ucnl/ucnl.github.io/README.md

|  |
| :---: |
| [www.unavlab.com](https://www.unavlab.com/) <br/> [support@unavlab.com](mailto:support@unavlab.com) |
| [EN](README.md) \| [RU](README_RU.md) |

## Support & Social media
{% include social-media-links.html %}

## Products documentation
* [Navigation & tracking systems](navigation_and_tracking_systems_en.md)
* [Underwater acoustic modems](underwater_acoustic_modems_en.md)
* [Underwater Wireless voice systems (Underwater telephone)](underwater_wireless_voice_systems_en.md)
* [Hydrophones & transducers](underwater_acoustic_antennas_en.md)
* [Accessories](accessories_en.md)
* [Other equipment](underwater_bespoke_systems_en.md)

## Media, educational project and other things
* [Media](media_videos_en.md)
* [Our educational projects](educational_projects_en.md)
* [Miscellaneous info](misc_en.md)
