ucnl/ucnl.github.io/documentation/EN/RedPhone/RedPhone_RF_Dongle_Specification_en.md

[Main](/) ❯ [Underwater wireless voice systems](/underwater_wireless_voice_systems_en) ❯ **RedPhone RF Dongle: Device specification**

|  |  |
| :---: | ---: |
| [www.unavlab.com](https://www.unavlab.com/) <br/> [support@unavlab.com](mailto:support@unavlab.com) | **RedPhone Radio dongle** - Radio dongle for configuring [RedPhone-DX](RedPhone_DX_Specification_en.md) devices <br/> Device specification |

## KEY FEATURES

* **Minimum dimensions and weight**
* **Splash-proof design**

## DESCRIPTION

The device is designed to connect [RedPhone-DX](RedPhone_DX_Specification_en.md) devices to a PC for configuration purposes.

## TECHNICAL SPECIFICATIONS

| PARAMETER | VALUE |
| :--- | :--- |
| DIMENSIONS (L x W x H, excluding the cable) | 42 x 26 x 109 mm |
| USB CABLE LENGTH | At least 0.1 m |
| WEIGHT | 110 g |
| OPERATING TEMPERATURE RANGE | -10 .. 50 °C |
| MAXIMUM RADIO COMMUNICATION RANGE<sup>[1](#footnote1)</sup> | 30 m |
| CONNECTION | To a PC's USB port |
| MOUNTING | Magnetic |

________________
<a name="footnote1"><sup>1</sup></a> Achieved in the absence of interference, in an open area.
