ucnl/ucnl.github.io/documentation/EN/RedPhone/RedPhone_Specification_en.md

|  | RedPhone-D |
| :---: | ---: |
| [www.unavlab.com](https://www.unavlab.com/) <br/> [support@unavlab.com](mailto:support@unavlab.com) | **RedPhone-D** <br/> Diver station of the wireless voice communication system <br/> Device specification |

## FEATURES

* **Compatibility with most similar systems (OTS, Oceanreef, etc.)**
* **Built-in function for determining the diver's location<sup>[1](#footnote1)</sup>**
* **Acoustic communication range up to 1000<sup>[2](#footnote2)</sup> m**
* **Battery life up to 80 hours in receiving mode**
* **Automatic power-on in water**
* **Built-in voice activity detector**
* **Strong, durable plastic housing**

## DESCRIPTION

The **RedPhone-D** wireless diver telephone communication station provides voice messaging between divers and/or from a diver to a surface station. The device supports standard frequency bands and is compatible with most similar systems. The built-in pinger function of the **RWLT** navigation system allows recording the geographic position of the diver upon completion of a voice transmission. 
[RedButton](https://docs.unavlab.com/documentation/EN/Accessories/uPress_Specification_en.html), which contains no corroding elements, is used as a push-to-talk (PTT) button.

## TECHNICAL SPECIFICATIONS

| PARAMETER | VALUE |
| :--- | :--- |
| DIMENSIONS<sup>[3](#footnote3)</sup> (L x W x H) | 106 x 95 x 55 mm |
| WEIGHT<sup>[4](#footnote4)</sup> (dry) | 0.6 kg |
| MAXIMUM IMMERSION DEPTH | 100 m |
| MAXIMUM ACOUSTIC COMMUNICATION RANGE<sup>[2](#footnote2)</sup> | 1000 m |
| MAXIMUM ACOUSTIC SOURCE LEVEL | 150 dB re 1 μPa @ 1 m |
| VOICE BANDWIDTH<sup>[5](#footnote5)</sup> | 300 .. 4300 Hz |
| NUMBER OF SUPPORTED CHANNELS | 8 |
| MAXIMUM BATTERY LIFE (RX MODE)<sup>[6](#footnote6)</sup> | up to 80 hours |
| MAXIMUM BATTERY LIFE (MIXED MODE, 20%)<sup>[6](#footnote6),[7](#footnote7)</sup> | up to 5 hours |
| MAXIMUM BATTERY LIFE (MIXED MODE, 50%)<sup>[6](#footnote6),[8](#footnote8)</sup> | up to 2.5 hours |
| OPERATING TEMPERATURE RANGE | -10 .. 50 °C |
| BUILT-IN POWER SUPPLY | 28 watt-hours, LiFePO4, up to 3000 charge-discharge cycles |
| CHANNEL SWITCHING | In the surface position, using a USB radio dongle |
| HOUSING MATERIAL | Polyurethane |
| CABLE INSULATION MATERIAL | Polyurethane |
| NAVIGATION SIGNAL CARRIER FREQUENCY | 20050 Hz |
| NAVIGATION SIGNAL MODULATION TYPE | BPSK |
| NAVIGATION SIGNAL DURATION | 200 ms |

## CHANNELS AND FREQUENCY BANDS

| CHANNEL NUMBER | CARRIER FREQUENCY, Hz | SIDEBAND | BANDWIDTH, Hz |
| :---: | :---: | :---: | :---: |
| 1 | 32768 | Lower | 28468 .. 32468 |
| 2 | 32768 | Upper | 33068 .. 37068 |
| 3 | 31250 | Lower | 26950 .. 30950 |
| 4 | 31250 | Upper | 31550 .. 35550 |
| 5 | 28500 | Lower | 24200 .. 28200 |
| 6 | 28500 | Upper | 28800 .. 32800 |
| 7 | 25000 | Lower | 20700 .. 24700 |
| 8 | 25000 | Upper | 25300 .. 29300 |

________________
<a name="footnote1"><sup>1</sup></a> The function is provided by the buoys of the **RWLT** navigation system.  
<a name="footnote2"><sup>2</sup></a> A parameter that determines the maximum range at which signal reception is possible, based on the electro-acoustic parameters of the transmitter and receiver, the spatial decrease in the intensity of sound energy, attenuation in the medium and the acoustic noise level.  
<a name="footnote3"><sup>3</sup></a> Including the transducer.  
<a name="footnote4"><sup>4</sup></a> With a battery, a PTT button and a mask connector; depending on the connector, the value may differ by the weight of the connector.  
<a name="footnote5"><sup>5</sup></a> The actual range of reproduced frequencies depends on the characteristics of the headset used.  
<a name="footnote6"><sup>6</sup></a> With new, fully charged batteries with a capacity of 3000 mA\*h or more, at an ambient temperature of 20 °C.  
<a name="footnote7"><sup>7</sup></a> In the mode of 2 minutes of transmission and 8 minutes of reception.  
<a name="footnote8"><sup>8</sup></a> In the mode of 5 minutes of transmission and 5 minutes of reception.
