ucnl/ucnl.github.io/documentation/EN/Transducers/R_1.d3505_1_Specification_en.md

[Main](/) ❯ [Hydrophones & transducers](/underwater_acoustic_antennas_en) ❯ **R-1.d3505-1: Device specification**

|  |  |
| :---: | ---: |
| [www.unavlab.com](https://www.unavlab.com/) <br/> [support@unavlab.com](mailto:support@unavlab.com) | **R-1.d3505-1** <br/> Underwater acoustic receiving transducer <br/> Device specification |

## KEY FEATURES

* Miniature and lightweight transducer based on a single disk piezoelectric element
* Complete absence of corroding elements
* Mounting holes

## TECHNICAL SPECIFICATIONS

| PARAMETER | VALUE |
| :--- | :--- |
| SIZE | 75 x 55 x 6 mm |
| WEIGHT (dry, excluding cable weight) | 5 g |
| ELECTRICAL CAPACITANCE | |
| MAXIMUM EXTERNAL HYDROSTATIC PRESSURE | 30 bar |
| STANDARD CABLE LENGTH | 1 m |
| CABLE TYPE | RG-174 / RG-58 |
| CABLE INSULATION MATERIAL | PVC / PU |
| OPERATING TEMPERATURE RANGE | -40..+60 °C |
| CABLE DIAMETER | 3 +/- 0.5 mm or 4 +/- 0.5 |

## DIMENSIONAL DRAWING

### Cable wire assignment

| No. | Color/Name | Function |
| :---: | :--- | :--- |
| 1 | Shield | Common |
| 2 | Center conductor | NC |

## ADDITIONAL PARAMETERS
