ucnl/ucnl.github.io/documentation/EN/Transducers/RT-1.524525-1_specification_en.md

[Main](/) ❯ [Hydrophones & transducers](/underwater_acoustic_antennas_en) ❯ **RT-1.524525-1: Device specification**

|  |  |
| :---: | ---: |
| [www.unavlab.com](https://www.unavlab.com/) <br/> [support@unavlab.com](mailto:support@unavlab.com) | **RT-1.524525-1** <br/> Underwater acoustic transducer <br/> Device specification |

## KEY FEATURES

* Maintenance-free monoblock design made using a patented technology
* Complete absence of corroding elements
* Single-element transducer - a balance between sensitivity in receiving and transmitting modes, weight and dimensions
* High-quality shielded cable with polyurethane insulation
* Mounting groove

## TECHNICAL SPECIFICATIONS

| PARAMETER | VALUE |
| :--- | :--- |
| SIZE (Ø x h) | 64 x 65 mm |
| WEIGHT (dry) | 0.28 kg |
| MAXIMUM INPUT VOLTAGE (PEAK) | 200 V |
| ELECTRICAL CAPACITANCE | 20 +/- 5 nF |
| MAXIMUM EXTERNAL HYDROSTATIC PRESSURE | 30 bar |
| STANDARD CABLE LENGTH | 1 m |
| OPERATING TEMPERATURE RANGE | -40..+60 °C |
| CABLE DIAMETER | 5 +/- 0.5 mm |
| BEAM PATTERN (10 .. 40 kHz) | Torus coaxial with the cylinder |
| BEAM ANGLE (10 .. 40 kHz) | 120° (frequency response 3 dB) |

## DIMENSIONAL DRAWING

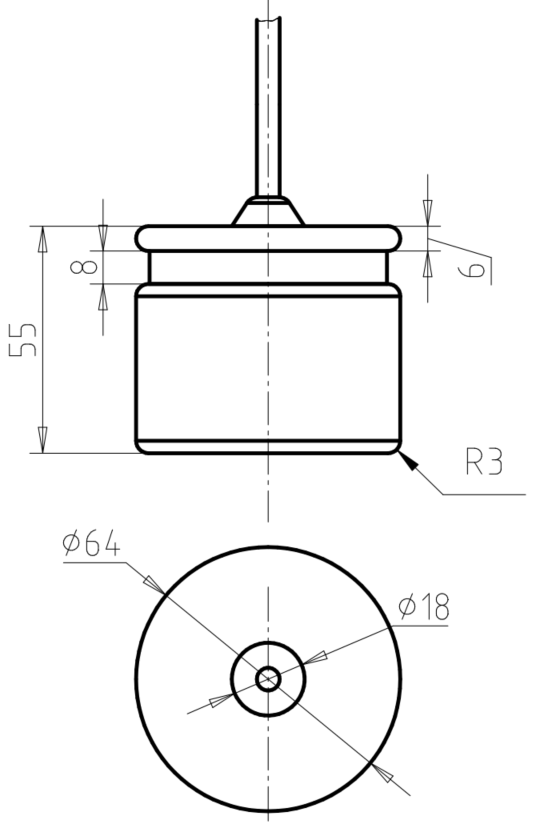
[picture p3: documentation/RT_1_524525_1_drawings.png]
RT_1_524525_1_drawings


### Cable wire assignment

| No. | Color | Function |
| :---: | :--- | :--- |
| 1 | Green | "-" |
| 2 | Red | "+" |
| 3 | White/Transparent | NC |
| 4 | Yellow | NC |
| 5 | Shield | NC |

## ADDITIONAL PARAMETERS

RT_1_524525_1_impedance

RT_1_524525_1_tx_sensitivity

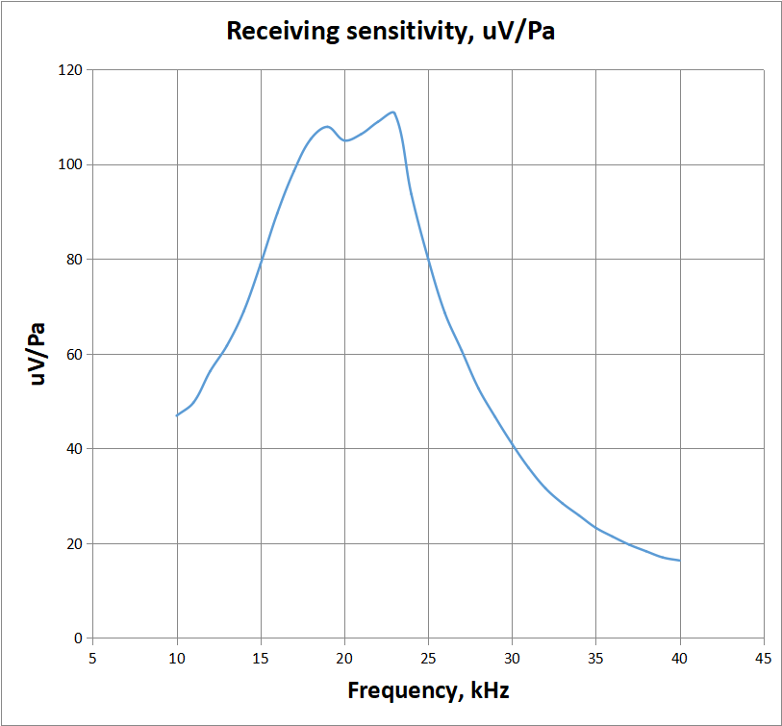
[picture p4: documentation/RT_1_524525_1_rx_sensitivity_en.png]
RT_1_524525_1_rx_sensitivity
