ucnl/ucnl.github.io/documentation/EN/WAYU/WAYU_GIB_Specification_en.md

[Main](/) ❯ [Educational projects](/educational_projects_en) ❯ **WAYU GIB: Device specification**

|  | WAYU_GIB_1(1)(1) |
| :---: | ---: |
| [www.unavlab.com](https://www.unavlab.com/) <br/> [support@unavlab.com](mailto:support@unavlab.com) | **WAYU GIB** - Navigation buoy <br/> Device specification |

## KEY FEATURES

* **Minimum dimensions and weight**
* **Strong and durable maintenance-free housing**
* **Automatic activation in water**

## DESCRIPTION

The **WAYU GIB** navigation sonobuoy of the **[WAYU](WAYU_DataBrief_en.md)** system, in a set of four such devices, forms a floating long navigation base that supports positioning of the **[WAYU Pinger](WAYU_Pinger_Specification_en.md)** pinger.  
The device has a one-piece design, is made of high-strength polyurethane and polypropylene, and switches off automatically when it enters the water. It does not require any settings or calibrations. Buoyancy is provided by an easily noticeable float made of ethylene-vinyl acetate (EVA).

## TECHNICAL SPECIFICATIONS

| PARAMETER | VALUE |
| :--- | :--- |
| DIMENSIONS<sup>[1](#footnote1)</sup> (Ø x h) | 55 x 1000 mm |
| WEIGHT (dry) | 1.55 kg |
| MAXIMUM BATTERY LIFE<sup>[2](#footnote2)</sup> | 12 hours |
| MAXIMUM VELOCITY RELATIVE TO PINGER | +/- 2 m/s |
| OPERATING TEMPERATURE RANGE | -10 .. 50 °C |
| MAXIMUM ACOUSTIC COMMUNICATION RANGE<sup>[3](#footnote3)</sup> | 300 m |
| ACOUSTIC SIGNAL FREQUENCY | 25000 Hz |
| REFERENCE ELLIPSOID | WGS-84 |
| BUILT-IN BATTERY TYPE | LiFePO4 |
| BUILT-IN BATTERY CAPACITY | 18 W·h |
| TRANSDUCER CABLE LENGTH | 1 m |
| BUILT-IN RADIO MODULE TYPE | 433 MHz |
| MAXIMUM RADIO MODULE POWER | 100 mW |
| MAXIMUM RADIO COMMUNICATION RANGE<sup>[4](#footnote4)</sup> | 300 m |
| CHARGING THE BUILT-IN BATTERY | With the included charger |
| CHARGING TIME OF THE BUILT-IN BATTERY | 8 h |

## ADDITIONAL INFORMATION

| [MSDS OF THE BUILT-IN POWER SUPPLY](https://docs.unavlab.com/documentation/EN/Misc/WAYU_GIB_MSDS_en.html) | [ELECTRONIC VERSION OF THIS DOCUMENT](https://docs.unavlab.com/documentation/EN/WAYU/WAYU_GIB_Specification_en.html) |
| :---: | :---: |
|  |  |

________________
<a name="footnote1"><sup>1</sup></a> Not including the receiving transducer on a 1 m cable, not including the float (Ø x h) 125 x 160 mm.  
<a name="footnote2"><sup>2</sup></a> With a new battery, at an ambient temperature of 20 °C.  
<a name="footnote3"><sup>3</sup></a> A parameter that determines the maximum range at which signal reception is possible, based on the electro-acoustic parameters of the transmitter and receiver, the spatial decrease in the intensity of sound energy, attenuation in the medium and the acoustic noise level.  
<a name="footnote4"><sup>4</sup></a> Achieved in the absence of interference, in open areas. The receiving antenna may need to be raised several meters higher.
