ucnl/ucnl.github.io/documentation/EN/Accessories/uPress_Specification_en.md

[Main](/) ❯ [Accessories](/accessories_en) ❯ **uPress underwater button**

|  |  |
| :---: | ---: |
| [www.unavlab.com](https://www.unavlab.com/) <br/> [support@unavlab.com](mailto:support@unavlab.com) | uPress underwater button <br/> Device specification |

## FEATURES

* **Complete absence of corroding elements**
* **Domestic development and production**
* **Patented design<sup>[*](#fn_asterisk)</sup>**
* **Ergonomic design**
* **Strong, durable, highly visible housing**
* **Loop for a cord or strap**

## DESCRIPTION

The **uPress** underwater switch is specially designed for use by divers. The device has no parts that require maintenance or are susceptible to corrosion.
It offers high reliability and a high mean time between failures compared with spring-loaded rod designs and piezo buttons.

___________________

<a name="fn_asterisk"><sup>*</sup></a> Patent RU2831916 C1

## TECHNICAL SPECIFICATIONS

| PARAMETER | VALUE |
| :--- | :--- |
| DEFAULT STATE | NORMALLY OPEN |
| DIMENSIONS (L x W x H)| 86 x 60 x 23 mm |
| WEIGHT<sup>[1](#fn1)</sup> (dry) | 55 g |
| MAXIMUM OPERATING DEPTH | 140 m |
| CABLE LENGTH<sup>[2](#fn2)</sup> | 0.5 m |
| CABLE DIAMETER | 5 mm |
| CABLE INSULATION MATERIAL | Polyurethane |
| HOUSING MATERIAL | Polyurethane |
| HOUSING COLOR<sup>[3](#fn3)</sup> | 🟥 🟦 🟩 🟨 ⬛ ⬜ |
| PUSH ELEMENT COLOR<sup>[3](#fn3)</sup> | 🟥 🟦 🟩 🟨 ⬛ ⬜ |
| OPERATING TEMPERATURE RANGE | -20 .. 50 °C |
| TRAVEL TO ACTUATION | 3 mm |
| MAXIMUM SWITCHING POWER | 10 W |
| SWITCHING CURRENT RANGE | 10<sup>-6</sup> .. 0.5 A |
| SWITCHING VOLTAGE RANGE | 5·10<sup>-2</sup> .. 100 V |
| CURRENT TYPE | DC, AC |
| NUMBER OF ACTUATIONS | 10<sup>5</sup> | 
| ACTUATION FORCE | 16 +/- 2 N |

________________  
<a name="fn1"><sup>1</sup></a> Including a cable of standard length.  
<a name="fn2"><sup>2</sup></a> The parameter can be changed by agreement.  
<a name="fn3"><sup>3</sup></a> Painting in any color from the RAL catalog is possible when ordering 50 pcs or more. Different colors of the button housing and the push element can also be combined.
