ucnl/ucnl.github.io/documentation/EN/Accessories/uSpeak_specification_en.md

[Main](/) ❯ [Accessories](/accessories_en) ❯ **uSpeak - protected microphone for diving masks**

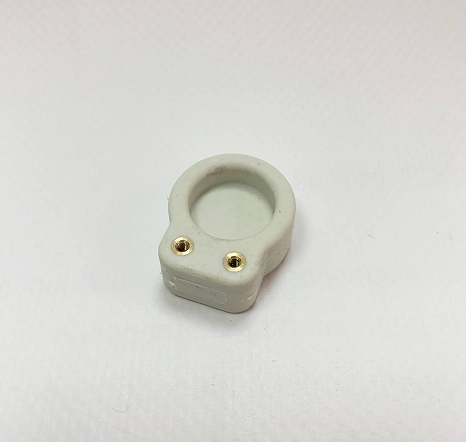
[picture p5: documentation/uspeak.png]
|  |  |
| :---: | ---: |
| [www.unavlab.com](https://www.unavlab.com/) <br/> [support@unavlab.com](mailto:support@unavlab.com) | **uSpeak** Protected microphone for diving masks <br/> Device specification |

## FEATURES

* **Resistant to any diving modes and depths**
* **Domestic development and production**
* **Patented design<sup>[*](#fn_asterisk)</sup>**
* **Ergonomic design**
* **Strong and durable**
* **Can be used as a replacement for DEMSh, OTS HotMic™, etc.**

## DESCRIPTION

**uSpeak** microphones are fully potted in a high-quality polyurethane compound. Simple and reliable, they have no closed air cavities. They withstand any diving and ascent modes.
It connects via a bronze M2 threaded connection, as do most counterparts.
The device is available in two form factors: standard and enlarged.

____________

<a name="fn_asterisk"><sup>*</sup></a> Patent RU225815

## TECHNICAL SPECIFICATIONS

| PARAMETER | VALUE |
| :--- | :--- |
| DIMENSIONS (L x W x H), mm | 31 x 26 x 12 mm (uSpeak) <br/> 39 x 37 x 13 mm (uSpeak Max) |
| WEIGHT (dry), g | 6.5 (uSpeak) <br/> 11.8 (uSpeak Max) |
| SENSITIVITY, μV/Pa | 500 (uSpeak) <br/> 1000 (uSpeak Max) |
| RESISTANCE<sup>[1](#fn1)</sup>, kOhm | 100 |
| FREQUENCY RANGE, Hz | 200 .. 6000 |
| CONNECTION | two bronze M2 screws |
| POTTING COMPOUND MATERIAL | Polyurethane |
| HOUSING COLOR<sup>[2](#fn2)</sup> | 🟥 🟦 🟩 🟨 ⬛ ⬜ |
| OPERATING TEMPERATURE RANGE, °C | -20 .. 60 |

________________  

<a name="fn1"><sup>1</sup></a> The parameter can be changed at the customer's request.  
<a name="fn2"><sup>2</sup></a> Painting in any color from the RAL catalog is possible when ordering 50 pcs or more.
