ucnl/ucnl.github.io/documentation/RU/Zima/Zima2SL_Specification_ru.md

[Главная](/README_RU) ❯ [Гидроакустические навигационные и трекинговые системы](/navigation_and_tracking_systems_ru) ❯ **Zima2-SL — решатель (Solver): Спецификация устройства**

<details>
  <summary><b>ℹ Рекомендации для печати/сохранения в PDF</b></summary>
  <br>
  <ol>
    <li>Нажмите <b>Ctrl+P</b> (macOS: <b>Cmd+P</b>)</li>
    <li>В настройках принтера выберите <b>«Сохранить как PDF»</b> (Microsoft Print to PDF)</li>
    <li>В поле <b>«Страницы»</b> укажите диапазон, исключая первую и последнюю страницу</li>
    <li>Отключите <b>верхние и нижние колонтитулы</b> (заголовки/URL/page numbers)</li>
    <li>В <b>Chrome/Edge</b>: в доп. настройках → «Поля» → <b>Нет</b> | в <b>Firefox</b>: «Поля и колонтитулы» → <b>Нет</b></li>
    <li>Нажмите <b>Печать</b> и укажите куда сохранить PDF</li>
  </ol>
</details>

|  | zima2_sl |
| :---: | ---: |
| [www.unavlab.com](https://www.unavlab.com/) <br/> [support@unavlab.com](mailto:support@unavlab.com) | **Zima2-SL** — решатель навигационной системы **Zima2 LBL** <br/> спецификация устройства |

## КЛЮЧЕВЫЕ ОСОБЕННОСТИ

* **Расчёт положения по дальностям до маяков с известными координатами**
* **Хранение координат маяков (до 16 шт.)**
* **Эмуляция GNSS-протокола (GGA, RMC, MTW)** для потребителя
* **Обмен с Zima2-LX по UART 3.3 В**
* **Компактная плата, размещаемая под водой или на поверхности**
* **Конфигурирование по протоколу [PAZM](Zima2_Protocol_Specification_ru.md)**

## ОПИСАНИЕ

**Zima2-SL** — вычислительный модуль (решатель) длиннобазисной навигационной системы [Zima2 LBL](Zima2_LBL_DataBrief_ru.md).

Модуль принимает по UART данные об измеренных дальностях от трансивера [Zima2-LX](Zima2LX_Specification_ru.md), хранит координаты маяков-ответчиков [Zima2-R](Zima2R_Specification_ru.md) и рассчитывает собственное положение. Результат выдаётся потребителю в виде стандартных GNSS-сообщений (**GGA**, **RMC**, **MTW**), что позволяет использовать **Zima2-SL** в качестве «прозрачной» замены приёмника GNSS в существующих системах.

Модуль может размещаться как под водой, так и на поверхности — в зависимости от решаемой задачи.

________________

## ТЕХНИЧЕСКИЕ ХАРАКТЕРИСТИКИ

| ПАРАМЕТР | ЗНАЧЕНИЕ |
| :--- | :--- |
| ГАБАРИТЫ (Ф х h) | ОЖИДАЕТСЯ |
| ВЕС | ОЖИДАЕТСЯ |
| НАПРЯЖЕНИЕ ПИТАНИЯ | 12 В |
| НАПРЯЖЕНИЕ ЛИНИЙ ДАННЫХ | 0 .. 3.3 В |
| ИНТЕРФЕЙС С Zima2-LX | UART 9600 бит/с |
| ИНТЕРФЕЙС С ПОТРЕБИТЕЛЕМ | UART 9600 бит/с |
| ПРОТОКОЛ КОНФИГУРИРОВАНИЯ | NMEA 0183 [PAZM](Zima2_Protocol_Specification_ru.md) |
| ЭМУЛИРУЕМЫЕ GNSS-СООБЩЕНИЯ | GGA, RMC, MTW |
| МАКСИМАЛЬНОЕ ЧИСЛО МАЯКОВ | до 16 |
| ДИАПАЗОН РАБОЧИХ ТЕМПЕРАТУР | ОЖИДАЕТСЯ |
| ЭНЕРГОПОТРЕБЛЕНИЕ | ОЖИДАЕТСЯ |
| МАКСИМАЛЬНАЯ ЧАСТОТА ОБНОВЛЕНИЯ ПОЗИЦИИ<sup>[1](#footnote1)</sup> | ОЖИДАЕТСЯ |
| НОМИНАЛЬНАЯ ТОЧНОСТЬ ОПРЕДЕЛЕНИЯ МЕСТОПОЛОЖЕНИЯ (СКО)<sup>[2](#footnote2)</sup> | ОЖИДАЕТСЯ |

________________
<a name="footnote1"><sup>1</sup></a> Определяется скоростью последовательного опроса маяков трансивером [Zima2-LX](Zima2LX_Specification_ru.md) и числом маяков в наборе.
<a name="footnote2"><sup>2</sup></a> ОЖИДАЕТСЯ.

### НАЗНАЧЕНИЕ РАЗЪЁМОВ / ЖИЛ КАБЕЛЯ

| ЦВЕТ ЖИЛЫ / КОНТАКТ | ФУНКЦИЯ |
| :--- | :---: |
| ОЖИДАЕТСЯ | + U<sub>пит.</sub> |
| ОЖИДАЕТСЯ | - U<sub>пит.</sub> (GND) |
| ОЖИДАЕТСЯ | UART к Zima2-LX: Rx |
| ОЖИДАЕТСЯ | UART к Zima2-LX: Tx |
| ОЖИДАЕТСЯ | UART к потребителю: Tx (GNSS-поток) |
