ucnl/ucnl.github.io/documentation/EN/RedPhone/RedPhone_DX_Specification_en.md

[Main](/../../) ❯ [Underwater Wireless voice systems (Underwater telephone)](/underwater_wireless_voice_systems_en) ❯ **Device specification: RedPhone-DX**

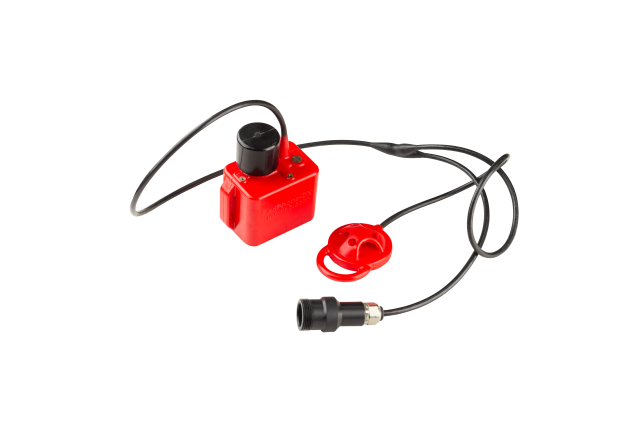
[picture p6: documentation/redphone_dx.png]
RedPhone-DX
|  |  |
| :---: | ---: |
| [www.unavlab.com](https://www.unavlab.com/) <br/> [support@unavlab.com](mailto:support@unavlab.com) | **RedPhone-DX** <br/> Underwater telephone. Diver's unit <br/> Device specification |

## KEY FEATURES

* **Compatible with most similar systems (OTS, Oceanreef, etc.)**
* **Fully rugger monoblock design - no place to leak!**
* **Built-in diver location function <sup>[1](#footnote1)</sup>**
* **Acoustic communication range up to 1000 <sup>[2](#footnote2)</sup> m**
* **Battery life up to 20 hours in receiving mode**
* **Automatic poweron in water**
* **Built-in voice activity detector / automatic squelch**

## DESCRIPTION

Diver's underwater wireless telephone communication unit **RedPhone-DX** provides voice messaging between divers and/or from a diver to a surface station. The device supports standard frequency bands and is compatible with most similar systems. The built-in pinger function of the navigation system **RWLT** allows the user to determine the geographic position of the diver after he completes voice transmission.
[uPress](https://docs.unavlab.com/documentation/EN/Accessories/uPress_Specification_en.html) that does not contain corrodable elements can be used as a Push-To-Talk button.

## TECHNICAL SPECIFICATIONS

| PARAMETER | VALUE |
| :--- | :--- |
| DIMENSIONS<sup>[3](#footnote3)</sup> | 106 x 95 x 55 mm |
| WEIGHT<sup>[4](#footnote4)</sup> (dry) | 0.6 kg |
| MAX. DEPTH | 100 m |
| MAX. OPERATING RANGE<sup>[2](#footnote2)</sup> | 1000 m |
| ACOUSTIC SOURCE LEVEL | 150 dB re 1 uPa @ 1 m |
| POWER (PEP) | 70 Watts |
| VOICE BANDWIDTH<sup>[5](#footnote5)</sup> | 300 .. 4300 Hz |
| NUMBER OF SUPPORTED CHANNELS | 8 |
| BATTERY LIFE (RX MODE)<sup>[6](#footnote6)</sup> | up to 20 hours |
| BATTERY LIFE (MIXED MODE)<sup>[6](#footnote6), [7](#footnote7)</sup> | up to 8 hours |
| BATTERY LIFE (MIXED MODE)<sup>[6](#footnote6), [8](#footnote8)</sup> | up to 2.5 hours |
| WORKING TEMPERATURE RANGE | -10 .. 50° С |
| BUILT-IN POWER SUPPLY | 28 Watt-hours, LiFePO4, up to 3000 cycles |
| CHANNEL SWITCHING | Onshore, via [RF-dongle](RedPhone_RF_Dongle_Specification_en.md) |
| BODY MATERIAL | Polyurethane |
| CABLES INSULATION MATERIAL | Polyurethane |
| NAVIGATION SIGNAL CARRIER | 20050 Hz |
| NAVIGATION SIGNAL MODULATION TYPE | BPSK |
| NAVIGATION SIGNAL DURATION | 200 msec |

## CHANNELS AND FREQUENCY BANDS

| CHANNEL NUMBER | CARRIER, Hz | SIDE BAND | BANDWIDTH, Hz |
| :---: | :---: | :---: | :---: |
| 1 | 32768 | Low | 28468 .. 32468 |
| 2 | 32768 | High | 33068 .. 37068 |
| 3 | 31250 | Low | 26950 .. 30950 |
| 4 | 31250 | High | 31550 .. 35550 |
| 5 | 28500 | Low | 24200 .. 28200 |
| 6 | 28500 | High | 28800 .. 32800 |
| 7 | 25000 | Low | 20700 .. 24700 |
| 8 | 25000 | High | 25300 .. 29300 |

### ADDITIONAL INFORMATION

[Material Safety Data Sheet (MSDS) for built-in battery](\documentation\EN\Misc\RedPhone_DX_MSDS_en) 

________________
<a name="footnote1"><sup>1</sup></a> The function is provided by buoys of the [RWLT](/documentation/EN/RWLT/RWLT_DataBrief_en) navigation system.  
<a name="footnote2"><sup>2</sup></a> A parameter that determines the maximum range at which a signal can be received based on the electro-acoustic parameters of the transmitter and receiver, spatial decrease in the intensity of sound energy, attenuation in the medium and level of acoustic noise.  
<a name="footnote3"><sup>3</sup></a> Including transducer.  
<a name="footnote4"><sup>4</sup></a> With a PTT button and a mask connector, deepending on the specific connector, the value may differ by the weight of the connector.  
<a name="footnote5"><sup>5</sup></a> The actual audible frequency range depends on the headset used.  
<a name="footnote6"><sup>6</sup></a> With new, fully charged batteries with a capacity of 3000 mA\*h or more, at an ambient temperature of 20 °C.  
<a name="footnote7"><sup>7</sup></a> While transmitting 2 minutes per 10 minutes.  
<a name="footnote8"><sup>8</sup></a> While transmitting 5 minutes per 10 minutes.
