ucnl/ucnl.github.io/documentation/EN/Accessories/Flange_rod_mound_Specification_en.md

[Main](/README) ❯ [Accessories](/accessories) ❯ **uClamp-S - Flange rod mount: Device specification**

|  | flange_rod_mount_zima2b |
| :---: | ---: |
| [www.unavlab.com](https://www.unavlab.com/) <br/> [support@unavlab.com](mailto:support@unavlab.com) | **uClamp-S** <br/> Flange rod mount <br/> Device specification |

## KEY FEATURES

* **Delrin resistant to external influences**
* **Four-screw flange mount**
* **Side cable exit**
* **Zero direction lock for Zima2-B and uWave USBL antennas**

## DESCRIPTION

The flange bracket is designed for mounting the following devices on a flat flange:
- Zima2-B direction-finding antennas (and its modifications)
- uWave USBL modems
- Zima2-R beacons-responders
- uWave Max modems
- RedNode navigation receivers
- RWLT Pinger pingers

For installing devices with a zero direction, such as Zima2-B and uWave USBL, the half rings have a special groove, and the position is marked on the cover with a round notch.
The bracket is made of delrin or polyacetal and is supplied with stainless steel screws.

## TECHNICAL SPECIFICATIONS

| PARAMETER | VALUE |
| :--- | :--- |
| DIMENSTIONS (Ф х h) | Ф88 х 58 mm |
| FLANGE MOUNTING | 4 screws М8 |
| HALF-RINGS MOUNTING | ISO 7380-2 A2/A4 M6х20 mm |
| CAP MOUNTING | DIN 7991 A2/A4 M6х40 mm |

## SET

| № | NAME | DESCRIPTION, pcs |
| :--- | :--- | :--- |
| 1 | CYLINDER | 1 |
| 2 | CAP | 1 |
| 3 | HALF-RING | 2 |
| 4 | SCREW ISO 7380-2 A2/A4 M6х20 mm | 4 |
| 5 | SCREW DIN 7991 A2/A4 M6х40 mm | 4 |



When installing Zima2-B and uWave USBL antennas, the round notch on the cap must correspond to the zero direction of the antenna.

## LOCATION OF MOUNTING HOLES
