ucnl/ucnl.github.io/documentation/EN/WAYU/WAYU_RF_Dongle_Specification_en.md

[Main](/../../) ❯ [Navigation & tracking systems](/navigation_and_tracking_systems_en) ❯ **Device specification: WAYU Radio dongle**

|  | uNav_WAYU_RF_Dongle |
| :---: | ---: |
| [www.unavlab.com](https://www.unavlab.com/) <br/> [support@unavlab.com](mailto:support@unavlab.com) | **uNav WAYU RF dongle** - Navigation receiver <br/> Device specification |

## KEY FEATURES

* **GNSS receiver protocol emulation**
* **Built-in GNSS module**

## DESCRIPTION

The receiver of the navigation signal of the buoys of the **[WAYU](WAYU_DataBrief_en.md)** system receives signals from the navigation buoys [WAYU GIB](WAYU_GIB_Specification_en.md) and determines the location of the underwater object on which the pinger [WAYU Pinger](WAYU_Pinger_Specification_en.md) is located. The receiver is made in the form of an unattended monoblock on a cable.

## TECHNICAL SPECIFICATIONS

| PARAMETER | VALUE |
| :--- | :--- |
| DIMENSIONS (Ф x h, w/o cable) | 90 x 330 mm |
| WEIGHT | 0.5 kg |
| CABLE LENGTH | 1 m |
| CABLE DIAMETER | 10 ± 0.5 mm |
| OPERATING TEMPERATURE RANGE | -10 .. 50 °C |
| MAXIMUM RADIO COMMUNICATION RANGE<sup>[1](#footnote1)</sup> | 300 m |
| RADIO COMMUNICATION | 433 MHz, receive only |
| CONNECTION | To PC USB port, USB-B |
| CURRENT CONSUMPTION | 150 mA |
| INTERFACE | RS-422, 38400 baud |
| PROTOCOL | [NMEA0183 (GGA, RMC), UNV](documentation/RU/RWLT/uNav_protocol_specification_en) |
| BUILT-IN GNSS module | GPS/GLONASS |
| HOUSING MATERIAL | Polyurethane |

________________
<a name="footnote1"><sup>1</sup></a> Achieved in the absence of interference, in open areas.
