ucnl/ucnl.github.io/documentation/EN/F4105/F4105_SU_Specification_en.md

[Main](/README) ❯ [Other equipment](/underwater_bespoke_systems_en) ❯ **Device specification: F4105-SU**

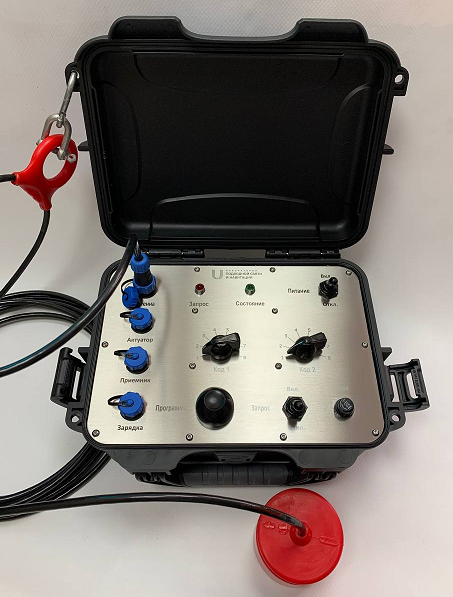
[picture p7: documentation/F4105_SU.png]
F4105-SU
|  |  |
| :---: | ---: |
| [www.unavlab.com](https://www.unavlab.com/) <br/> [support@unavlab.com](mailto:support@unavlab.com) | **F4105-SU** <br/> Acoustic release control unit <br/> Device specification |

## KEY FEATURES

* 64 unique addresses for acoustic realses
* Programming the address of releases and issuing commands in one device
* Durable, long-lasting plastic housing IP67<sup>[1](#footnote1)</sup>
* Stainless steel control panel
* Built-in LiFePO4 battery

## DESCRIPTION

The device is designed to:
- assign addresses to acoustic release receiver units [F4105-AU](F4105_AU_Specification_en.md)
- issue a command to acoustic release receiver units [F4105-AU](F4105_AU_Specification_en.md)

The device is made in accordance with the protection class IP67<sup>[1](#footnote1)</sup> and can operate autonomously thanks to the built-in power source.

## TECHNICAL SPECIFICATIONS

| PARAMETER | VALUE |
| :--- | :--- |
| DIMENSTIONS | 259 x 202 x 115 mm |
| WEIGHT | 2.4 kg |
| MAX. ACOUSTIC RANGE<sup>[2](#footnote2)</sup> | 200 m |
| BANDWIDTH | 22.4 .. 29 kHz | 
| MAX. ACOUSTIC SOURCE LEVEL | 160 dB re 1 uPa @ 1 m |
| TRANSDUCER CABLE LENGTH<sup>[3](#footnote3)</sup> | 5 m |
| TRANSDUCER TYPE | [RT-1.524525-1](/documentation/EN/Transducers/RT-1.524525-1_specification_en) |
| BUILT-IN BATTERY CAPACITY | 48 W·h |
| BUILT-IN BATTERY TYPE | LiFePO4 |
| MAX. BATTERY LIFE IN ASCENT COMMAND TRANSMISSION MODE<sup>[4](#footnote4)</sup> | up to 6 hours |
| WORKING TEMPERATURES | -5 .. 40 °С |
| DUST/WATERPROOF | IP67<sup>[1](#footnote1)</sup> |
| FUSE | 5х20 mm, 5 A |

________________
<a name="footnote1"><sup>1</sup></a> With the lid closed. With the case lid open but the connectors closed, exposure to precipitation is permitted.  
<a name="footnote2"><sup>2</sup></a> A parameter that determines the maximum range at which a signal can be received, based on the electroacoustic parameters of the transmitter and receiver, the spatial decrease in the intensity of sound energy, attenuation in the environment, and the level of hydroacoustic interference.  
<a name="footnote3"><sup>3</sup></a> The cable length can be changed by additional agreement.  
<a name="footnote4"><sup>4</sup></a> With a fully charged battery. As a rule, the initiation time of the release does not exceed 1 minute, provided that it is within the signal coverage area.
