ucnl/ucnl.github.io/documentation/EN/RedWAVE/RedBASE_Specification_en.md

[Main](/../../) ❯ [Navigation & tracking systems](/navigation_and_tracking_systems_en) ❯ **Device specification: RedBASE - GNSS-equipped sonobuoy**

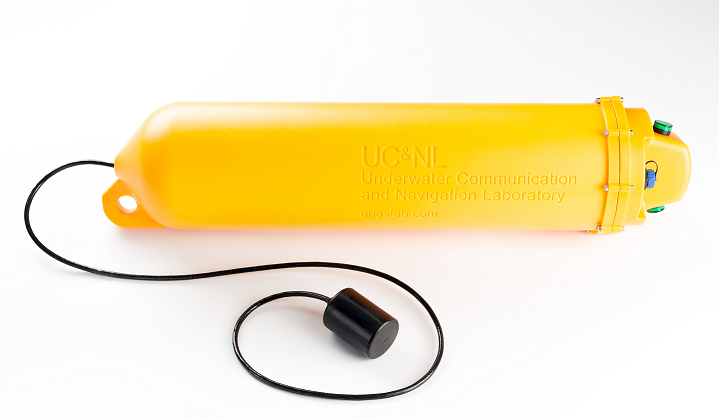
[picture p8: documentation/def_redbase_yellow.png]
|  |  |
| :---: | ---: |
| [www.unavlab.com](https://www.unavlab.com/) <br/> [support@unavlab.com](mailto:support@unavlab.com) | **RedBASE** - GNSS-equipped sonobuoy <br/> Device specification |

## KEY FEATURES

* **Simultaneous positioning for an unlimited number of devices [RedNODE](RedNODE_Specification_en.md) / [RedNAV](RedNAV_Specification_en.md)**
* **High-performance combined GPS/GLONASS receiver**
* **Strong, durable, easily visible housing**
* **Long battery life up to 24 hours**
* **Reliable and noise-immune technology of digital broadband acoustic communication**

## DESCRIPTION

GNSS-equipped sonobuoy **RedBASE** as part of a set of four such devices forms a floating long navigation base,
which supports the simultaneous positioning of an unlimited number of navigation receivers [RedNODE](RedNODE_Specification_en.md)/[RedNAV](RedNAV_Specification_en.md).
The device is made in the form of a plastic cylinder with dimensions Ф150х600 mm with a hydroacoustic transmitting antenna on the cable.

It has positive buoyancy, has a load-carrying eye for anchoring.

## TECHNICAL SPECIFICATION

| PARAMETER | VALUE |
| :--- | :--- |
| DIMENSIONS (Ф х h) | 146 x 597 mm |
| WEIGHT(dry) | 4.8 kg |
| REDUNDANT BUOYANCY | 1 kg |
| CARRIER | 20100 Hz |
| BATTERY LIFE | 24 hours |
| ACOUSTIC RANGE (ENEGRY)<sup>[1](#footnote1)</sup> | 3000 m |
| ACOUSTIC SOURCE LEVEL (IN BAND) | 170 dB re 1 μPa @ 1 m |
| ACOUSTIC SOURCE LEVEL (IN 1 Hz BAND) | 88 dB re 1 μPa @ 1 m |
| MAX. ALLOWED DISTANCE TO OTHER BUOYS FROM THE SET<sup>[2](#footnote2),[3](#footnote3)</sup> | 700 m |
| MIN. ALLOWED DISTANCE TO OTHER BUOYS FROM THE SET<sup>[3](#footnote3)</sup> | 30 m |
| MAX. RELATIVE VELOCITY | +/- 1.8 m/s  |
| WORKING TEMPERATURE RANGE | -10 .. 50 °С |
| REFERENCE ELLIPSOID | WGS-84 |
| BUILT-IN BATTERY TYPE | Lead-acid |
| TRANSDUCER CABLE LENGTH | 1.1 m |
| CHARGE TIME 220 V | 10 hours |

________________
<a name="footnote1"><sup>1</sup></a> A parameter that determines the maximum range at which a signal can be received, based on
electro-acoustic parameters of the transmitter and receiver, spatial decrease in the intensity of sound energy, attenuation in the medium
and the acoustic noise level.  
<a name="footnote2"><sup>2</sup></a> Buoys are located on the surface of the water as a convex polygon so that the distance from each buoy
before any other did not exceed the specified value.  
<a name="footnote3"><sup>3</sup></a> The immersion depth of the navigation receivers should not exceed the size of the navigation base.
