ucnl/ucnl.github.io/documentation/EN/Zima/Zima2B_Specification_en.md

[Main](/../../) ❯ [Navigation & tracking systems](/navigation_and_tracking_systems_en) ❯ **Zima2-B: Device specification**

|  |  |
| :---: | ---: |
| [www.unavlab.com](https://www.unavlab.com/) <br/> [support@unavlab.com](mailto:support@unavlab.com) | **Zima2-B** - **Zima2 USBL** direction finding antenna <br/> Device specification |

## KEY FEATURES

* **Extremely small size and weight**
* **Operating range up to 3000<sup>[1](#footnote1)</sup> m**
* **Reliable and noise-immune technology of digital broadband acoustic communication**
* **Subscribers code division - up to 16 responders**
* **Low power consumption (Rx/Tx) 0.33/10 W**
* **Patented monoblock design**
* **Built-in depth/temperature sensor**

## DESCRIPTION

**Zima2-B** - direction finding antenna of the ultra short baseline system [Zima2 USBL](Zima2_DataBrief_en.md).
The device uses a fixed-length code division signal to provide heading, range, and depth of responders [Zima2-R](Zima2R_Specification_en.md).

When using an external **GNSS** receiver and Compass, the device allows you to determine the absolute coordinates of the responder beacons.
Sequential operation of up to 16 responder beacons is provided.
 
The ideal solution for determining the direction and distance to **ROV**, **AUV** and **divers**.

Extremely small size, low power consumption and ease of use make the direction finding system [Zima2 USBL](Zima2_DataBrief_en.md) an ideal solution for working with autonomous and remotely controlled vehicles, as well as determining the relative position of divers.

## TECHNICAL FEATURES

| PARAMETER | VALUE |
| :--- | :--- |
| DIMENSIONS (Ф х h) | 64 x 128 mm |
| WEIGHT (dry)<sup>[2](#footnote2)</sup> | 0.44 kg |
| MAXIMAL DEPTH | 40 m |
| NOMINAL DEPTH ACCURACY | 0.1 m |
| MAX. OPERATING RANGE<sup>[1](#footnote1)</sup> | 3000 m |
| HORIZONTAL ANGLE OF ARRIVAL ESTIMATION ACCURACY (typ.)<sup>[3](#footnote3)</sup> | 1° |
| SLANT RANGE RESOLUTION | 0.15 m |
| MAX. TILT COMPENSATED BY THE BUILT-IN INCLINOMETER RELATED TO VERTICAL AXIS (pitch/roll) | +/- 30° |
| WORKING VERTICAL ANGLES (RELATIVE TO HORIZONTAL PLANE)<sup>[3](#footnote3)</sup> | 0 .. 85° |
| ACOUSTIC SOURCE LEVEL | 170 dB re 1 μPa @ 1 m |
| CARRIER FREQUENCY | 20100 Hz |
| BUILT-IN TEMPERATURE SENSOR ACCURACY | 0.1°С |
| BIT ERROR RATE | 10<sup>-6</sup> |
| SNR<sup>[2](#footnote2)</sup> | -3 dB |
| MAX. RELATIVE VELOCITY | +/- 2 m/s |
| RATED STARTUP TIME | 100 msec |
| WORKING TEMPERATURE RANGE | -5 .. 50 °C |
| BATTERY LIFE<sup>[4](#footnote4)</sup> (WHEN SUPPLIED FROM [BAT&LINK BOX](Bat_n_link_box_Specification_en.md)) | 8 h |
| POWER CONSUMPTION (Rx/Tx) | 0.5 / 10 W |
| INTERFACE | USB(COM) 9600 bit/s |
| COMMUNICATION PROTOCOL | NMEA 0183 [PAZM](Zima2_Protocol_Specification_en.md) |
| CABLE LENGTH<sup>[5](#footnote5)</sup> | 10 m |
| MAX. NUMBER OF RESPONDERS | 16 |

<!-- | BANDWIDTH | 10 .. 30 kHz | -->
________________
<a name="footnote1"><sup>1</sup></a> A parameter that determines the maximum range at which a signal can be received, based on electro-acoustic parameters of the transmitter and receiver, spatial decrease in the intensity of sound energy, attenuation in the medium and the acoustic noise level.  
<a name="footnote2"><sup>2</sup></a> Withoud cable and interface converter.  
<a name="footnote3"><sup>3</sup></a> Obtained under laboratory conditions in a static test.  
<a name="footnote4"><sup>4</sup></a> Considering 1 request in 3 seconds.  
<a name="footnote5"><sup>5</sup></a> With additional cable and interface converter [Bat&Link Box](Bat_n_link_box_Specification_en.md). Can be increased by a request up to 20 m.
