ucnl/ucnl.github.io/documentation/EN/RWLT/RWLT_Pinger_K_Specification_en.md

[Main](/../../) ❯ [Navigation & tracking systems](/navigation_and_tracking_systems_en) ❯ **Device specification: RWLT Pinger-K**

|  |  |
| :---: | ---: |
| [www.unavlab.com](https://www.unavlab.com/) <br/> [support@unavlab.com](mailto:support@unavlab.com) | **RWLT Pinger-K** - 500/1000 m pinger beacon <br/> Device specification |

## KEY FEATURES

* **Easy media integration**
* **Easy to maintain**
* **Minimum dimensions and weight**

## DESCRIPTION

The navigation beacon-pinger **RWLT Pinger-K** of the **[RWLT](RWLT_DataBrief_en.md)** system is placed on a positioned object: an ROV, AUV or other underwater object and emits a periodic navigation signal, which is received by four floating navigation buoys **[RWLT GIB](RWLT_GIB_Specification_en.md)** the geographic position of the pinger is determined by the navigation signal; transmission of telemetric information from the pinger in combination with navigation allows you to determine its depth, water temperature and battery voltage. Unlike the basic version of the device, **RWLT Pinger-K** is designed to operate at a maximum depth of up to 1000 m.
The device is powered by the carrier.

## TECHNICAL SPECIFICATIONS

| PARAMETER | VALUE |
| :--- | :--- |
| DIMENSIONS<sup>[1](#footnote1)</sup> (Ф х h) | 80 x 147 mm |
| WEIGHT (dry)<sup>[1](#footnote1)</sup> | 1130 г |
| MAX. OPERATING DEPTH | 1000 m |
| DEPTH RESOLUTION | 0.6 m for 500 m version, 1.2 m for 1000 m version |
| CARRIER FREQUENCY | 20050 Hz |
| NAVIGATION SIGNAL EMITTING PERIOD | 2 seconds |
| NAVIGATION SIGNAL DURATION | 0.2 seconds |
| TELEMETRY | Depth, Temperature, Supply voltage |
| MAX. ACOUSTIC RANGE<sup>[2](#footnote2)</sup> | 1500 m |
| ACOUSTIC SOURCE LEVEL | 160 dB re 1 uPa @ 1 m |
| MAX. RELATIVE SPEED | ± 1.8 m/s  |
| WORKING TEMPERATURE RANGE | -10 .. 50 °С |
<!-- | ПОЛОСА ЧАСТОТ | 10 .. 30 кГц | -->

________________
<a name="footnote1"><sup>1</sup></a> Without taking into account the weight and dimensions of the antenna. The device is equipped with an antenna [RT-1.524525-1-FF](/documentation/EN/Transducers/RT_1_524525_1_FF_Specification_en).   
<a name="footnote2"><sup>2</sup></a> A parameter that determines the maximum range at which signal reception is possible, based on the electroacoustic parameters of the transmitter and receiver, the spatial decrease in the intensity of sound energy, attenuation in the medium and the noise level.
