ucnl/ucnl.github.io/documentation/EN/Zima/Zima2RK_Specification_en.md

[Main](/../../) ❯ [Navigation & tracking systems](/navigation_and_tracking_systems_en) ❯ **Zima2-RK: Device specification**

|  |  |
| :---: | ---: |
| [www.unavlab.com](https://www.unavlab.com/) <br/> [support@unavlab.com](mailto:support@unavlab.com) | **Zima2-RK** - **Zima2 USBL** responder beacon <br/> Device specification |

## KEY FEATURES

* **1000 m depth rating**
* **Operating range up to 3000<sup>[1](#footnote1)</sup> m**
* **Reliable and noise-immune technology of digital broadband acoustic communication**
* **Subscribers code division - up to 16 responders**
* **Low power consumption (Rx/Tx) 0.33/10 W**
* **Patented monoblock design**
* **Built-in depth/temperature sensor**

## DESCRIPTION

**Zima2-RK** - responder of ultrashort baseline navigation system [Zima2 USBL](Zima2_DataBrief_en.md) for working on depths up to 1000 m.

The device is designed to be placed on an underwater object in order to determine the location of this object in real time using a direction-finding antenna [Zima2-BK](Zima2BK_Specification_en.md).

## TECHNICAL SPECIFICATIONS

| PARAMETER | VALUE |
| :--- | :--- |
| DIMENSIONS (Ф х h) | 80 x 147 mm |
| WEIGHT<sup>[2](#footnote2)</sup> (dry) | 1130 g |
| DEPTH RATING | 1000 m |
| DEPTH RESOLUTION | 2 m |
| MAX. OPERATING RANGE<sup>[1](#footnote1)</sup> |	3000 m |
| ACOUSIC SOURCE LEVEL |	170 dB re 1 μPa @ 1 m |
| CARRIER FREQUENCY | 20100 Hz |
| BUILT-IN TEMPERATURE SENSOR ACCURACY | 0.1°С |
| BIT ERROR RATE | 10<sup>-6</sup> |
| SNR<sup>[3](#footnote3)</sup> | -3 dB |
| MAX. RELATIVE VELOCITY | +/- 2 m/s |
| RATED STARTUP TIME | 100 msec |
| SUPPLY VOLTAGE | 12 V |
| DATA LINES VOLTAGE | 0 .. 3.3 V |
| WORKING TEMPERATURE RANGE | -5 .. 50 °C |
| POWER CONSUMPTION (Rx/Tx) | 0.33 / 10 W |
| INTERFACE | USB(COM) 9600 bit/s |
| PROTOCOL | NMEA 0183 [PAZM](Zima2_Protocol_Specification_en.md) |
| CABLE LENGTH<sup>[4](#footnote4)</sup> | 0.5 m |
| MAX. NUMBER OF ADRESSES | 16 |

<!-- | BANDWIDTH | 10 .. 30 kHz | -->
  
________________
<a name="footnote1"><sup>1</sup></a> Without the presence of a multipath effect. A parameter that determines the maximum range at which a signal can be received, based on electro-acoustic parameters of the transmitter and receiver, spatial decrease in the intensity of sound energy, attenuation in the medium and the acoustic noise level.   
<a name="footnote2"><sup>2</sup></a> Without taking into account the weight of the antenna. The device is equipped with [RT-1.524525-1-FF](/documentation/EN/Transducers/RT_1_524525_1_FF_Specification_en) antenna.  
<a name="footnote3"><sup>3</sup></a> Obtained under laboratory conditions in a static test.  
<a name="footnote4"><sup>4</sup></a> Can be changed by a special request.
