ucnl/ucnl.github.io/documentation/EN/Zima/Zima2R_Specification_en.md

[Main](/../../) ❯ [Navigation & tracking systems](/navigation_and_tracking_systems_en) ❯ **Zima2-R: Device specification**

|  |  |
| :---: | ---: |
| [www.unavlab.com](https://www.unavlab.com/) <br/> [support@unavlab.com](mailto:support@unavlab.com) | **Zima2-R** - **Zima2 USBL** responder beacon <br/> Device specification |

## KEY FEATURES

* **Extremely small size and weight**
* **Operating range up to 3000<sup>[1](#footnote1)</sup> m**
* **Reliable and noise-immune technology of digital broadband acoustic communication**
* **Subscribers code division - up to 16 responders**
* **Low power consumption (Rx/Tx) 0.33/10 W**
* **Built-in depth/temperature sensor**

## DESCRIPTION

**Zima2-RK** - responder of ultrashort baseline navigation system [Zima2 USBL](Zima2_DataBrief_en.md).

The device is designed to be placed on an underwater object in order to determine the location of this object in real time using a direction-finding antenna [Zima2-B](Zima2B_Specification_en.md).

The device can be either autonomous (with an additional [battery pack](/documentation/EN/Accessories/Sub_batteries_en.md#sb2448lf)) or coupled energetically with the carrier.

Extremely small size, ease of use and low power consumption make the direction finding system [Zima2 USBL](Zima2_DataBrief_en.md) an ideal solution for working with autonomous and remotely controlled vehicles, as well as determining the relative position of divers.

## TECHNICAL SPECIFICATIONS

| PARAMETER | VALUE |
| :--- | :--- |
| DIMENSIONS (Ф х h) | 64 x 62 mm |
| WEIGHT<sup>[2](#footnote2)</sup> (dry) | 0.3 kg |
| DEPTH RATING | 300 m |
| DEPTH RESOLUTION | 0.6 m |
| MAX. OPERATING RANGE<sup>[1](#footnote1)</sup> |	3000 m |
| ACOUSIC SOURCE LEVEL |	170 dB re 1 μPa @ 1 m |
| CARRIER FREQUENCY | 20100 Hz |
| BUILT-IN TEMPERATURE SENSOR ACCURACY | 0.1°С |
| BIT ERROR RATE | 10<sup>-6</sup> |
| SNR<sup>[3](#footnote3)</sup> | -3 dB |
| MAX. RELATIVE VELOCITY | +/- 2 m/s |
| RATED STARTUP TIME | 100 msec |
| SUPPLY VOLTAGE | 12 V |
| DATA LINES VOLTAGE | 0 .. 3.3 V |
| WORKING TEMPERATURE RANGE | -5 .. 50 °C |
| POWER CONSUMPTION (Rx/Tx) | 0.33 / 10 W |
| INTERFACE | USB(COM) 9600 bit/s |
| PROTOCOL | NMEA 0183 [PAZM](Zima2_Protocol_Specification_en.md) |
| CABLE LENGTH<sup>[4](#footnote4)</sup> | 1 m |
| MAX. NUMBER OF ADDRESSES | 16 |

<!-- | BANDWIDTH | 10 .. 30 kHz | -->
________________
<a name="footnote1"><sup>1</sup></a> Without the presence of a multipath effect. A parameter that determines the maximum range at which a signal can be received, based on electro-acoustic parameters of the transmitter and receiver, spatial decrease in the intensity of sound energy, attenuation in the medium and the acoustic noise level.   
<a name="footnote2"><sup>2</sup></a> Without a battery pack. Standard battery pack [SB SB-24-48-LF](/documentation/EN/Accessories/Sub_batteries_en#sb2448lf). 
Battery life with standard battery pack - up to 70 hours in receiving mode, up to 8 hours with 1 request in 3 seconds schedule.  
<a name="footnote3"><sup>3</sup></a> Obtained under laboratory conditions in a static test.  
<a name="footnote4"><sup>4</sup></a> Can be changed by a special request.
