ucnl/ucnl.github.io/documentation/EN/Transducers/RT_2_332820_1_specification_en.md

[Main](/../../) ❯ [Hydrophones & transducers](/underwater_acoustic_antennas_en) ❯ **Transducer RT-2.332820-1**

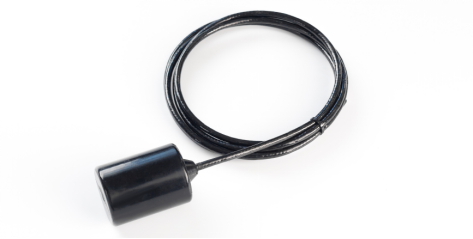
[picture p12: documentation/def_buoy_txd.png]
|  |  |
| :---: | ---: |
| [www.unavlab.com](https://www.unavlab.com/) <br/> [support@unavlab.com](mailto:support@unavlab.com) | **RT-2.332820-1** <br/> Underwater acostic transducer <br/> Device specification |

## KEY FEATURES

* Maintenance-free monoblock design, patented technology
* The complete absence of corrosive elements
* Based on two cylindrical piezo-elements connected in parallel - for maximum efficiency in transmission mode
* High quality shielded cable in polyurethane insulation

## TECHNICAL SPECIFICATIONS

| PARAMETER | VALUE |
| :--- | :--- |
| DIMENSIONS (Ф х h) | 45 x 70 mm |
| WEIGHT (dry) | 0.29 кг |
| MAX. INPUT VOLTAGE (peak) | 200 V |
| ELECTRIC CAPACITY | 30 +/- 5 nF |
| MAX. EXTERNAL HYDROSTATIC PRESSURE | 30 Bar |
| STANDARD CABLE LENGTH | 1 m |
| CABLE INSULATION | Polyurethane |
| CABLE DIAMETER | 5 +/- 0.5 mm |
| WORKING TEMPERATURE RANGE | -40..+60 °С |
| BEAM PATTERN (10 .. 40 kHz) | Torus coaxial with the cylinder |
| BEAM ANGLE (10 .. 40 kHz) | 90° (3 dB) |

## DRAWINGS

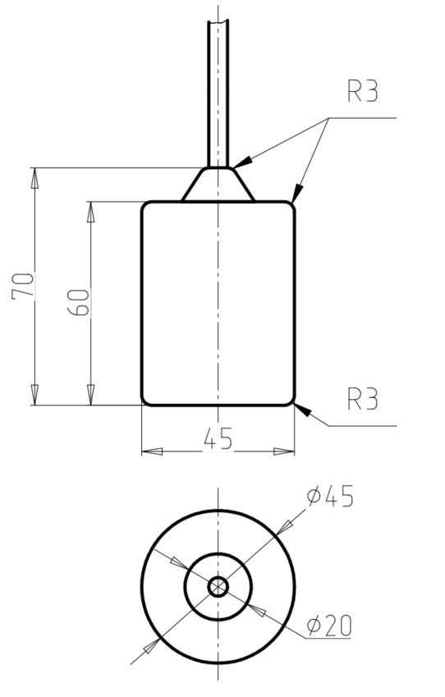
[picture p13: documentation/RT_2_332820_1_drawings.png]
RT_2_332820_1_drawings


### Wire functions

| № | Color | Function |
| :---: | :--- | :--- |
| 1 | Green | Signal |
| 2 | Black | NC |
| 3 | White/Transparent | NC |
| 4 | Brown | Common |
| 5 | Shield | NC |

## ADDITIONAL FEATURES

RT_2_332820_1_impedance

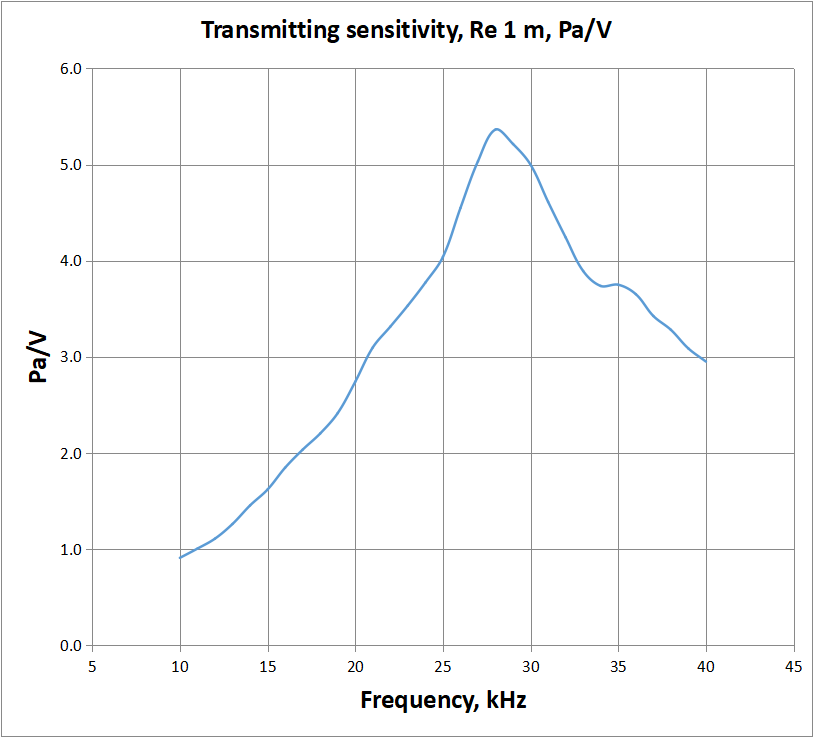
[picture p14: documentation/RT_2_332820_1_en_tx_sensitivity.png]
RT_2_332820_1_tx_sensitivity


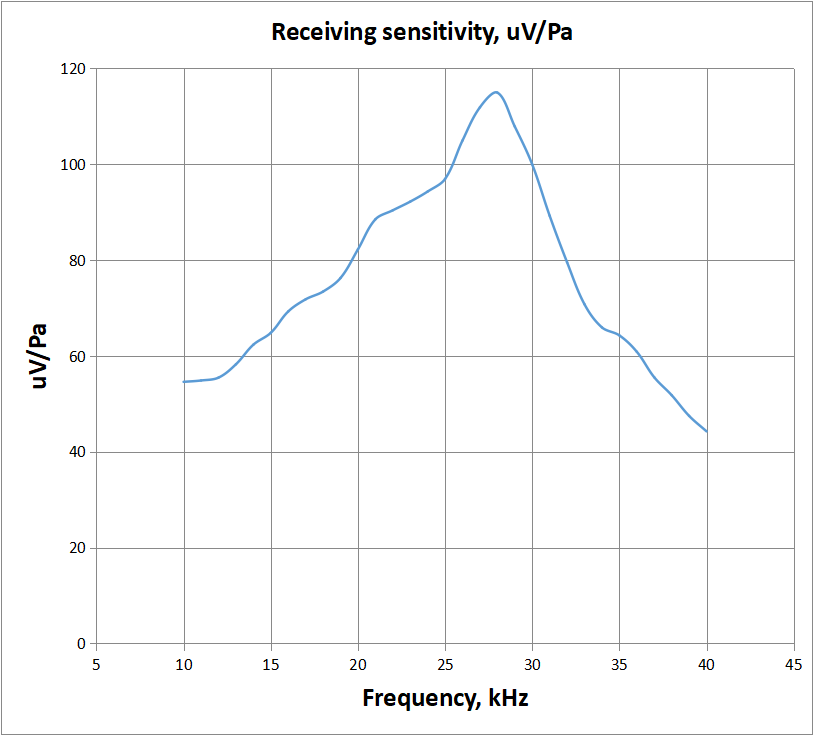
[picture p15: documentation/RT_2_332820_1_en_rx_sensitivity.png]
RT_2_332820_1_rx_sensitivity
