ucnl/ucnl.github.io/documentation/EN/Transducers/RT_1_524525_1_FF_Specification_en.md

[Main](/../../) ❯ [Hydrophones & transducers](/underwater_acoustic_antennas_en) ❯ **Transducer RT-1.524525-1-FF**

|  |  |
| :---: | ---: |
| [www.unavlab.com](https://www.unavlab.com/) <br/> [support@unavlab.com](mailto:support@unavlab.com) | **RT-1.524525-1-FF** <br/> Underwater acoustic transducer <br/> Device specification |

## KEY FEATURES

* Maintenance-free monoblock design, patented technology
* Free-flooded ring design
* The complete absence of corrosive elements
* Single-element antenna - a balance between sensitivity in receiving and transmission modes, weight and dimensions
* High quality shielded cable in polyurethane insulation
* Mounting groove

## TECHNICAL SPECIFICATIONS

| PARAMETER | VALUE |
| :--- | :--- |
| DIMENSIONS (Ф х h) | 64 x 62 mm |
| WEIGHT (dry) | 0.34 кг |
| MAX. INPUT VOLTAGE (peak) | 200 V |
| ELECTRIC CAPACITY | 20 +/- 5 nF |
| MAX. EXTERNAL HYDROSTATIC PRESSURE | 100 Bar |
| STANDARD CABLE LENGTH | 1 m |
| CABLE INSULATION | Polyurethane |
| CABLE DIAMETER | 5 +/- 0.5 mm |
| WORKING TEMPERATURE RANGE | -40..+60 °С |

## DRAWINGS
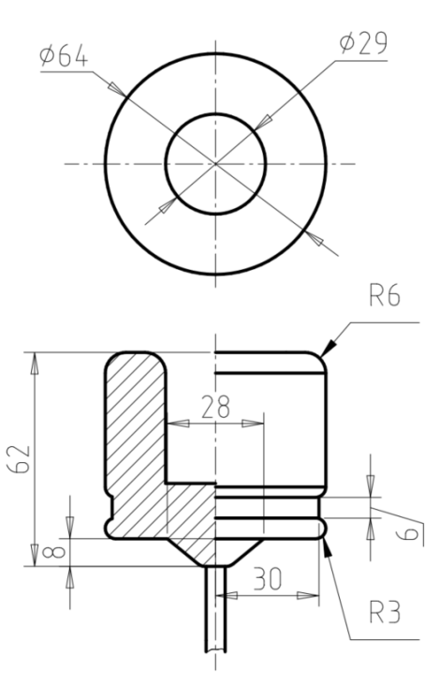
[picture p16: documentation/RT_1_524525_1_FF_drawings.png]
RT_1_524525_1_FF_drawings


### Wire functions

| № | Color | Function |
| :---: | :--- | :--- |
| 1 | Green | Signal |
| 2 | Black | NC |
| 3 | White/Transparent | NC |
| 4 | Brown | Common |
| 5 | Shield | NC |

## ADDITIONAL PARAMETERS

RT_1_524525_1_FF_en_impedance

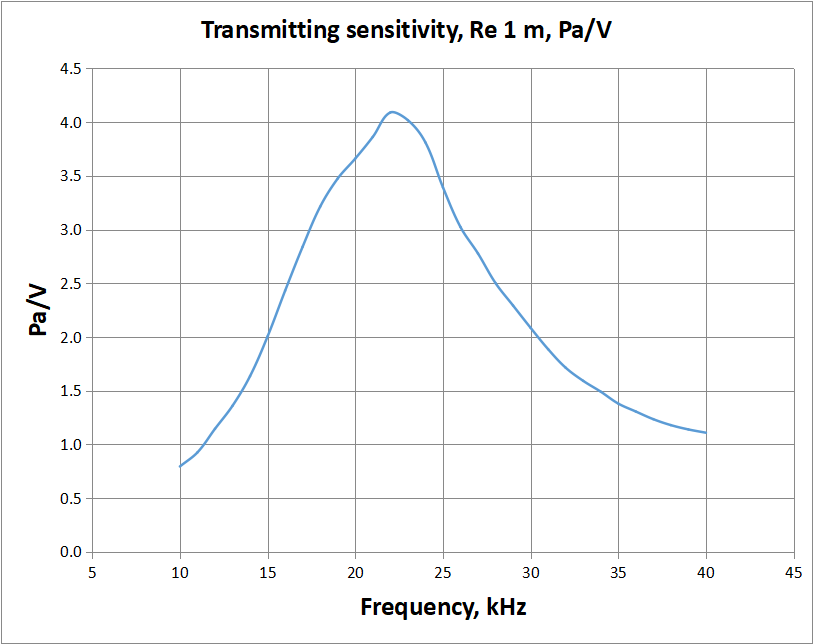
[picture p17: documentation/RT_1_524525_1_FF_en_tx_sensitivity.png]
RT_1_524525_1_FF_en_tx_sensitivity


RT_1_524525_1_FF_en_rx_sensitivity
