ucnl/ucnl.github.io/documentation/EN/Transducers/RT_1_332820_1_Specification_en.md

[Main](/../../) ❯ [Hydrophones & transducers](/underwater_acoustic_antennas_en) ❯ **Transducer RT-1.332820-1**

|  |  |
| :---: | ---: |
| [www.unavlab.com](https://www.unavlab.com/) <br/> [support@unavlab.com](mailto:support@unavlab.com) | **RT-1.332820-1** <br/> Underwater acoustic transducer <br/> Device specification |

## KEY FEATURES

* Small single-element antenna 
* Maintenance-free monoblock design, patented technology
* The complete absence of corrosive elements
* High quality shielded cable in polyurethane insulation
* Mounting groove

## TECHNICAL SPECIFICATIONS

| PARAMETER | VALUE |
| :--- | :--- |
| DIMENSIONS (Ф х h) | 41 x 45 mm |
| WEIGHT (dry) | 0.1 kg |
| MAX. INPUT VOLTAGE (peak) | 200 V |
| ELECTRIC CAPACITY | 15 +/- 3 nF |
| MAX. EXTERNAL HYDROSTATIC PRESSURE | 30 Bar |
| STANDARD CABLE LENGTH | 1 m |
| CABLE INSULATION | Polyurethane |
| CABLE DIAMETER | 5 +/- 0.5 mm |
| WORKING TEMPERATURE RANGE | -40..+60 °С |
| BEAM PATTERN (10 .. 40 kHz) | Torus coaxial with the cylinder |
| BEAM ANGLE (10 .. 40 kHz) | 120° (3 dB) |

## DRAWINGS

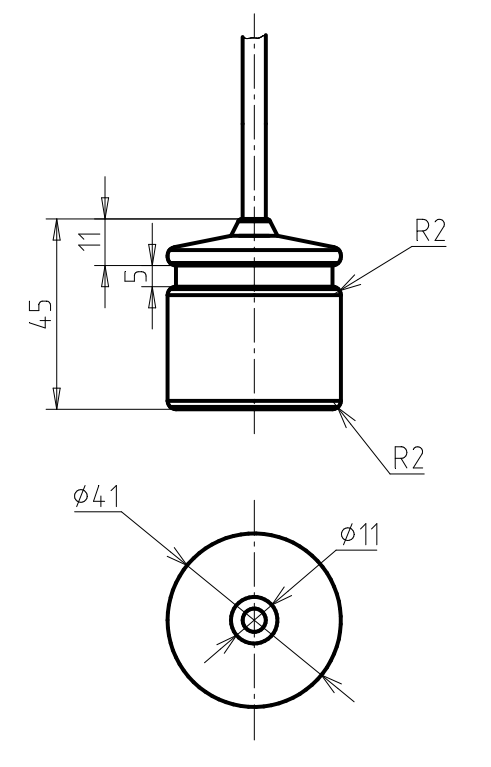
[picture p18: documentation/RT_1_332820_1_drawings.png]
RT_1_332820_1_drawings


### Wire functions

| № | Color | Function |
| :---: | :--- | :--- |
| 1 | Green | Signal |
| 2 | Black | NC |
| 3 | White/Transparent | NC |
| 4 | Brown | Common |
| 5 | Shield | NC |

## ADDITIONAL FEATURES

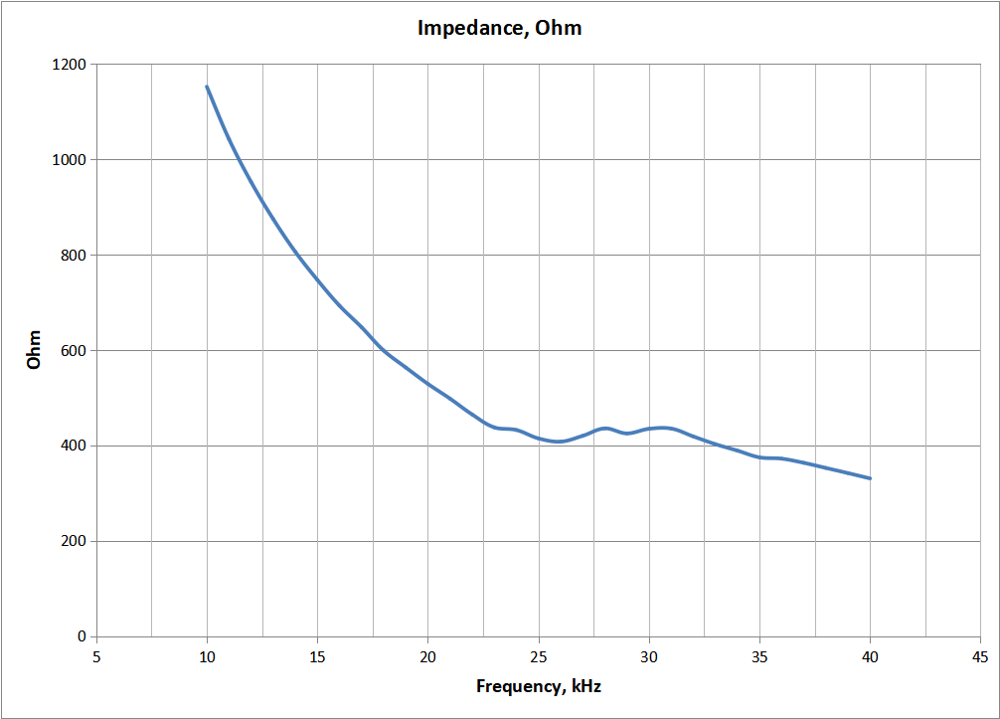
[picture p19: documentation/RT_1_332820_1_en_impedance.png]
RT_1_332820_1_impedance


RT_1_332820_1_tx_sensitivity

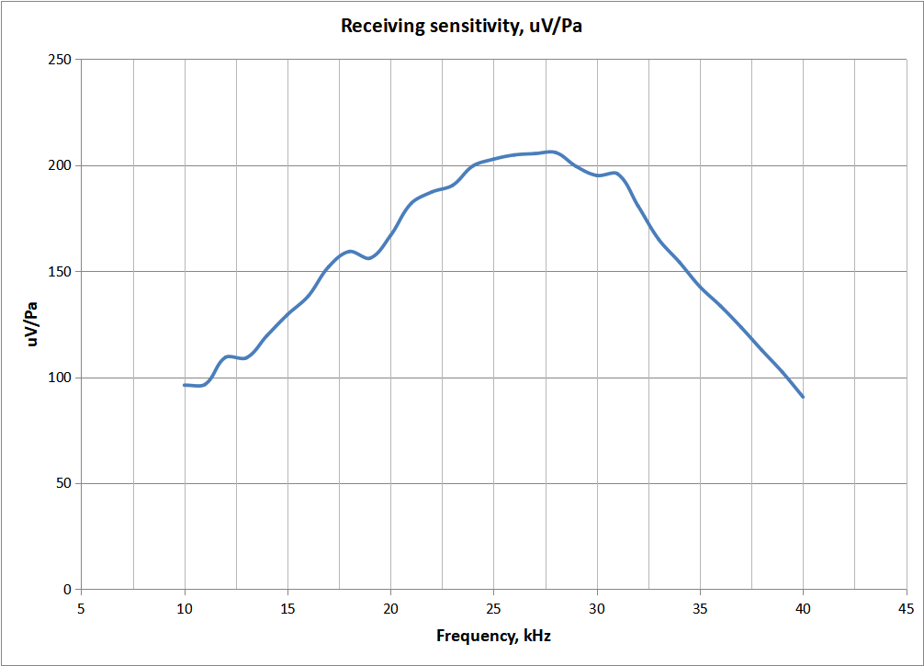
[picture p20: documentation/RT_1_332820_1_en_rx_sensitivity.png]
RT_1_332820_1_rx_sensitivity
