ucnl/ucnl.github.io/documentation/EN/Zima/Bat_n_link_box_Specification_en.md

[Main](/../../) ❯ [Navigation & tracking systems](/navigation_and_tracking_systems_en) ❯ **Bat & Link Box: Device specification**

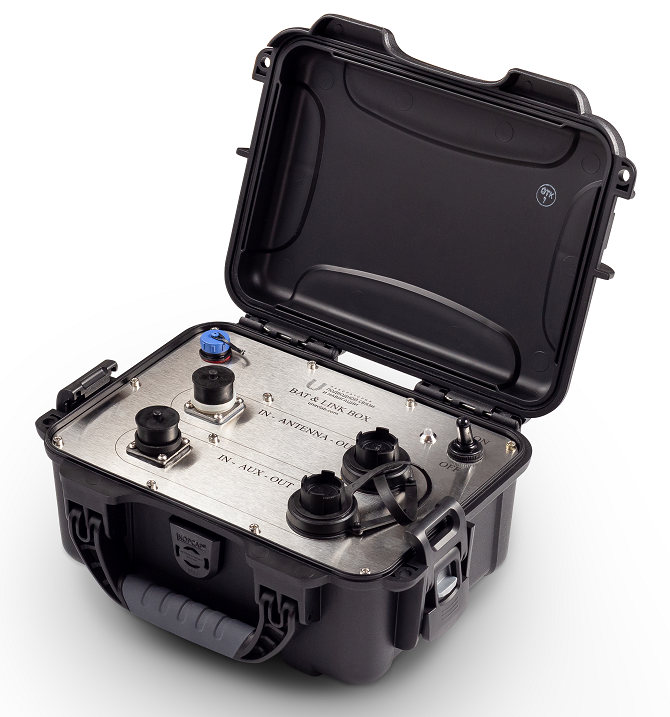
[picture p21: documentation/batnlinkbox.png]
Bat&Link Box
|  |  |
| :---: | ---: |
| [www.unavlab.com](https://www.unavlab.com/) <br/> [support@unavlab.com](mailto:support@unavlab.com) | **Bat&Link Box** - Autonomous power supply and interfacing unit <br/> Device specification |

## KEY FEATURES

* **Small size and weight**
* **IP67**
* **Long-life built-in LiFePO4 power supply**
* **Ability to work from an external power source**
* **3 mm thick hight quality stainless steel faceplate**

## DESCRIPTION

The Bat & Link Box device combines the functions of an autonomous power supply for a direction-finding station [Zima-B](Zima_B_Specification_en.md) and a converter for pairing the station with a user's PC, as well as for connecting data sources on the heading and position of the direction-finding station. Contains protection circuits against reverse polarity and overvoltage of connected devices.

The device is housed in a small shockproof plastic case. Has a front panel made of high-quality stainless steel. The modern lithium-iron-phosphate batteries used in the device provide operation at low temperatures and **more than a thousand** charge-discharge cycles. If necessary, it is possible to work from an external 12 V DC source and at the same time charge the built-in battery from a standard charger.

## TECHNICAL SPECIFICATIONS

| PARAMETER | VALUE |
| :--- | :--- |
| DIMENSIONS | 110 X 260 X 210 mm |
| WEIGHT | 2.5 kg |
| WORKING TEMPERATURE RANGE | -10 .. 50 °С |
| BUILT-IN BATTERY CAPACITY | 40 W\*h |
| BUILT-IN BATTERY TYPE | LiFePO4 |
| EXTERNAL POWER SUPPLY VOLTAGE | 12 +/-2 V |
| LOW BATTERY INDICATION | YES |
| EXTERNAL POWER SUPPLY QUALITY INDICATION | YES |
| CONNECTORS | 1 or 2 USB-B |
| | 1 RS-422 (FULL) |
| | 2 RS-422 (TX ONLY) |
| | EXTERNAL POWER SUPPLY |
| | CHARGER |

## ADDITIONAL INFORMATION

[Material Safety Data Sheet (MSDS) for built-in battery](\documentation\MSDS_BATLINK_LiFePO4_en.pdf)
