ucnl/ucnl.github.io/documentation/EN/RedPhone/RedPhone_OS_Specification_en.md

[Main](/../../) ❯ [Underwater Wireless voice systems (Underwater telephone)](/underwater_wireless_voice_systems_en) ❯ **Device specification: RedPhone-OS**

|  |  |
| :---: | ---: |
| [www.unavlab.com](https://www.unavlab.com/) <br/> [support@unavlab.com](mailto:support@unavlab.com) | **RedPhone-OS** <br/> Underwater telephone. Surface unit <br/> Device specification |

## KEY FEATURES

* **Compatible with most similar systems (OTS, Oceanreef, etc.)**
* **Rugged, durable plastic housing**
* **Operating range up to 1000<sup>[1](#footnote1)</sup> m**
* **High receiver sensitivity**
* **Built-in voice activity detector**

## DESCRIPTION

The RedPhone-OS Wireless underwater telephone provides voice transmission between the surface station and the divers. The device supports standard frequency bands and is compatible with most other systems. The device is made in a shockproof plastic case, the dashboard is made of high-grade 3 mm stainless steel with inscriptions applied by laser engraving. The built-in power supply consists of lithium-iron-phosphate batteries, which operate at low temperatures and more than 1000 charge-discharge cycles.

## TECHNICAL SPECIFICATIONS

| PARAMETER | VALUE |
| :--- | :--- |
| DIMENSIONS (length х width х height) | 259 x 202 x 115 mm |
| WIGHT | 2 kg |
| MAX. OPERATING RANGE<sup>[1](#footnote1)</sup> | 1000 m |
| ACOUSIC SOURCE LEVEL | 160 dB re 1 μPa @ 1 m |
| TRANSDUCER'S CABLE LENGTH<sup>[2](#footnote2)</sup> | 7 m |
| NUMBER OF SUPPORTED CHANNELS | 8 |
| VOICE BANDWIDTH<sup>[3](#footnote3)</sup> | 300 .. 4300 Hz |
| BUILT-IN BATTERY | LiFePO4 60 W\*h | 
| BATTERY LIFE (RX MODE)<sup>[4](#footnote4),[5](#footnote5)</sup> | up to 30 hours |
| BATTERY LIFE (20% TX, 80% RX)<sup>[4](#footnote4),[5](#footnote5),[6](#footnote6)</sup> | up to 24 hours |
| BATTERY LIFE (50% TX, 50% RX)<sup>[4](#footnote4),[5](#footnote5),[7](#footnote7)</sup> | up 12 hours |
| WORKING TEMPERATURE RANGE | -10 .. 50 °С |
| MICROPHONE | Handheld, with PTT |
| EXTERNAL HEADPHONES RESISTANCE (not less) | 8 Ohm |
| PROTECTION CLASS | IP67<sup>[8](#footnote8)</sup> |

## CHANNELS & FREQUENCY BANDS

| CHANNEL NUMBER | CARRIER, Hz | SIDE BAND | BANDWIDTH, Hz |
| :---: | :---: | :---: | :---: |
| 1 | 32768 | Low | 28468 .. 32468 |
| 2 | 32768 | High | 33068 .. 37068 |
| 3 | 31250 | Low | 26950 .. 30950 |
| 4 | 31250 | High | 31550 .. 35550 |
| 5 | 28500 | Low | 24200 .. 28200 |
| 6 | 28500 | High | 28800 .. 32800 |
| 7 | 25000 | Low | 20700 .. 24700 |
| 8 | 25000 | High | 25300 .. 29300 |

## ADDITIONAL INFORMATION

[Material Safety Data Sheet (MSDS) for built-in battery](\documentation\EN\Misc\RedPhone_OS_MSDS_en) 

________________
<a name="footnote1"><sup>1</sup></a> A parameter that determines the maximum range at which a signal can be received, based on electro-acoustic parameters of the transmitter and receiver, spatial decrease in the intensity of sound energy, attenuation in the medium and the acoustic noise level.  
<a name="footnote2"><sup>2</sup></a> By agreement, delivery with increased cable length is possible.  
<a name="footnote3"><sup>3</sup></a> The actual audible frequency range depends on the headset used.  
<a name="footnote4"><sup>4</sup></a> When playing on the built-in speaker, with a volume level of 40%.  
<a name="footnote5"><sup>5</sup></a> With a fully charged, new battery. At an ambient temperature of 20 ° C.  
<a name="footnote6"><sup>6</sup></a> In the mode, 2 minutes of transmission and 8 minutes of reception.  
<a name="footnote7"><sup>7</sup></a> In the mode, 5 minutes of transmission and 5 minutes of reception.  
<a name="footnote8"><sup>8</sup></a> With top cover closed
