ucnl/ucnl.github.io/documentation/EN/Accessories/RedButton_Specification_en.md

[Main](/../../) ❯ [Accessories](/accessories_en) ❯ **Underwater button RedButton**

|  |  |
| :---: | ---: |
| [www.unavlab.com](https://www.unavlab.com/) <br/> [support@unavlab.com](mailto:support@unavlab.com) | RedButton underwater button <br/> Device specification |

## KEY FEATURES
* **Total absence of corrosive elements**
* **Ergonomic design**
* **Strong, durable, highly visible housing**
* **Loop for a cord or belt**

## DESCRIPTION
Submersible switch **RedButton** specially designed for divers. The device has no serviced and corrosive parts.
It has high reliability and MTBF compared with spring-rod designs and piezo buttons.  

## TECHNICAL SPECIFICATIONS

| PARAMETER | VALUE |
| :--- | :--- |
| STATE BY DEFAULT | DISCONNECTED |
| DIMENSIONS | 86 x 60 x 23 mm |
| WEIGHT<sup>[1](#footnote1)</sup> (dry) | 55 g |
| DEPTH RATING | 300 m |
| CABLE LENGTH<sup>[2](#footnote2)</sup> | 0.5 m |
| CABLE DIAMETER | 5 мм |
| CABLE INSULATION MATERIAL | Polyurethane |
| BODY MATERIAL | Polyurethane |
| BODY COLOUR<sup>[3](#footnote1)</sup> | Red |
| WORKING TEMPERATURE RANGE | -20 .. 50 °С |
| DISPLACEMENT BETWEEN SWITCHING | 3 mm |
| MAX. POWER | 10 W |
| CURRENT RANGE | 10<sup>-6</sup> .. 0.5 A |
| VOLTAGE RANGE | 5·10<sup>-2</sup> .. 100 В |
| CURRENT TYPE |DC, AC |
| NUMBER OF CYCLES | 10<sup>5</sup> |
| SWITCHING FORCE | 25 +/- 5 N |

________________
<a name="footnote1"><sup>1</sup></a> With standard length cable.  
<a name="footnote2"><sup>2</sup></a> The parameter can be changed by agreement.  
<a name="footnote3"><sup>3</sup></a> The default color is specified. Other colors are available: black, yellow, green, blue. It is possible to dye in any color according to the RAL catalog when ordering from 50 pcs.
