ucnl/ucnl.github.io/documentation/EN/RWLT/RWLT_GIB_Specification_en.md

[Main](/../../) ❯ [Navigation & tracking systems](/navigation_and_tracking_systems_en) ❯ **Device specification: RWLT GIB**

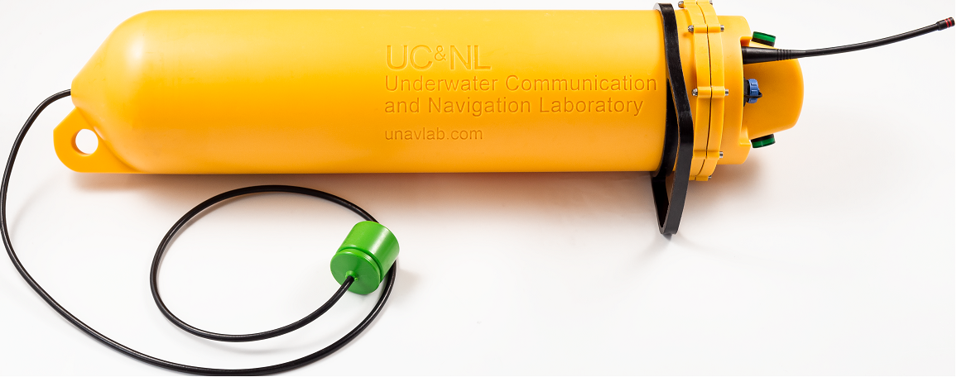
[picture p23: documentation/RWLT_GIB.png]
RWLT GIB
|  |  |
| :---: | ---: |
| [www.unavlab.com](https://www.unavlab.com/) <br/> [support@unavlab.com](mailto:support@unavlab.com) | **RWLT GIB** - Navigation buoy <br/> Device specification |

## KEY FEATURES

* **High performance combined GPS/GLONASS receiver**
* **Robust, durable, highly visible body**
* **Long battery life up to 24 hours**
* **Reliable and robust digital broadband hydroacoustic communication technology**

## DESCRIPTION

Navigation buoy **RWLT GIB** of the system **[RWLT](RWLT_DataBrief_en.md)** as part of a set of four such devices forms a floating long navigation base, with the support of which positioning of the pinger **[RWLT Pinger](RWLT_Pinger_Specification_ru. md)** or underwater wireless telephone **[RedPhone](https://docs.unavlab.com/documentation/EN/RedPhone/RedPhone_Specification_en.html)** is provided.  
The device is made in the form of a plastic cylinder with dimensions Ф150х600 mm with a receiving hydroacoustic antenna on a cable.

The device has positive buoyancy and a load-carrying eye for anchor attachment.

## TECHNICAL SPECIFICATIONS

| PARAMETER | VALUE |
| :--- | :--- |
| DIMENSIONS<sup>[1](#footnote1)</sup> (Ф х h) | 146 x 597 mm |
| WEIGHT (dry) | 4.8 kg |
| POSITIVE BUOYANCY | 1 kg |
| FREQUENCY RANGE | 10 .. 30 kHz |
| BATTERY LIFE<sup>[2](#footnote2)</sup> | up to 12 hours |
| MAX. RELATIVE VELOCITY | +/- 1.8 m/s  |
| WORKING TEMPERATURE RANGE | -10 .. 50 °С |
| MAX. ACOUSTIC RANGE<sup>[3](#footnote3)</sup> | 3000 m |
| MAX. ALLOWED DISTANCE TO OTHER BUOYS OF THE SET<sup>[4](#footnote4),[5](#footnote5)</sup> | 1500 m |
| MIN. ALLOWED DISTANCE TO OTHER BUOYS OF THE SET<sup>[5](#footnote5)</sup> | 30 m |
| REFERENCE ELLIPSOID | WGS-84 |
| BUILT-IN BATTERY TYPE | Lead-acid |
| ACOUSTIC ANTENNA CABLE LENGTH | 1.5 m |
| BUILT-IN RF UNIT TYPE | GFSK, 433 MHz |
| MAX. BUILT-IN RF UNIT OUTPUT POWER | 100 mW |
| MAX. RF RANGE<sup>[6](#footnote4)</sup> | 1000 m |

________________
<a name="footnote1"><sup>1</sup></a> Without taking into account the height of the radio antenna (180 mm) and the acoustic receiving antenna on a cable 1.5 m long.  
<a name="footnote2"><sup>2</sup></a> With a new, fully charged battery, at an ambient temperature of 20 °C.  
<a name="footnote3"><sup>3</sup></a> A parameter that determines the maximum range at which signal reception is possible, based on
electroacoustic parameters of the transmitter and receiver, spatial decrease in the intensity of sound energy, attenuation in the environment
and the level of hydroacoustic noise.  
<a name="footnote4"><sup>4</sup></a>Buoys should be located on the surface of the water in a convex polygon so that the distance from each buoy
to any other did not exceed the indicated value.  
<a name="footnote5"><sup>5</sup></a> Pinger's immersion depth should not exceed the size of the navigation base.  
<a name="footnote6"><sup>6</sup></a> Achieved in the absence of interference, in an open area.
