ucnl/ucnl.github.io/documentation/EN/RedLINE/RedLine_Specification_en.md

|  |  |
| :---: | ---: |
| [www.unavlab.com](https://www.unavlab.com/) <br/> [support@unavlab.com](mailto:support@unavlab.com) | **RedLINE** - Underwater acoustic modem <br/> Device specification |

## KEY FEATURES
* **Extremely small size and weight**
* **Reliable data transmission with 80 bit/s**
* **Operating range up to 8000<sup>[1](#footnote1)</sup> m**
* **Subscribers code division**
* **Reliable and noise-immune technology of digital broadband acoustic communication**
* **Low power consumption (Rx/Tx) 0.33/10 W**
* **Open & easy interfacing protocol**
* **Patented monoblock design**

## DESCRIPTION
**RedLINE** - a family of wireless underwater acoustic modems that implement a transparent transmission channel.

**RedLINE** have an unrivalled ratio of parameters such as power consumption/dimensions/reliability and transmission range.
Unified with devices [RedNODE](/documentation/EN/RedWAVE/RedNODE_Specification_en.md), [uWAVE MAX](/documentation/EN/uWAVE/uWAVE_Max_Specification_en.md) and [Zima-R](/documentation/EN/Zima/Zima_R_Specification_en.md) monoblock design allows the use of standard solutions for integration.

Small size, low power consumption and ease of use make **RedLINE** an ideal solution for small-sized ROVs/AUVs as well
and for larger devices.

The function of code division of subscribers allows you to most effectively solve data transfer problems for multiple devices.

## TECHNICAL SPECIFICATIONS

| PARAMETER | VALUE |
| :--- | :--- |
| DIMENSIONS (Ф х h) | 64 x 62 mm |
| WEIGHT (dry) | 0.36 kg |
| DEPTH RATING | 400 m |
| MAX. OPERATING RANGE<sup>[1](#footnote1)</sup> | 8000 m |
| PAYLOAD DATA RATE | 80 bit/s |
| POWER CONSUMPTION Rx/Tx | 0.33/10 W |
| SUPPLY VOLTAGE | 12 V |
| ACOUSIC SOURCE LEVEL | 170 dB re 1 μPa @ 1 m |
| DATA LINES VOLTAGE | 0 .. 3.3 V |
| BANDWIDTH | 5 .. 15 kHz |
| BIT ERROR RATE | 10<sup>-6</sup> |
| SNR<sup>[2](#footnote2)</sup> | -6 dB |
| MAX. RELATIVE VELOCITY | +/- 3 m/s |
| RATED STARTUP TIME | 100 msec |
| WORKING TEMPERATURE RAGE | -5 .. 50 °C |
| INTERFACE<sup>[3](#footnote3)</sup> | UART 9600 bit/s |
| CONFIGURATION PROTOCOL | NMEA 0183 [PTNT](RedLINE_Protocol_Specifications_en.md) |
| CABLE LENGTH<sup>[3](#footnote3)</sup> | 0.5 m |
| SUBSCRIBER'S DIVISION | 20 code channels |
| MINIMAL PACKET SIZE FOR TRANSMISSION | 7 bytes |
| TX BUFFER SIZE | 256 bytes |
| EXTRA FEATURES | Relay mode |
  
________________
<a name="footnote1"><sup>1</sup></a> A parameter that determines the maximum range at which a signal can be received, based on electro-acoustic parameters of the transmitter and receiver, spatial decrease in the intensity of sound energy, attenuation in the medium and the acoustic noise level.  
<a name="footnote2"><sup>2</sup></a> This value is obtained without the presence of the multipath effect  
<a name="footnote3"><sup>3</sup></a> Can be changed by the special request
