ucnl/ucnl.github.io/documentation/EN/RedGTR/RedGTR_Specifications_en.md

|  |  |
| :---: | ---: |
| [www.unavlab.com](https://www.unavlab.com/) <br/> [support@unavlab.com](mailto:support@unavlab.com) | **RedGTR** - code communication underwater acoustic modem <br/> Device specification |

## KEY FEATURES
* **Extremely small size and weight**
* **Operating range up to 8000<sup>[1](#footnote1)</sup> m**
* **Subscribers code division**
* **Reliable and noise-immune technology of digital broadband acoustic communication**
* **Low power consumption (Rx/Tx) 0.33/25 W**
* **Open & easy interfacing protocol**
* **Built-in depth/temperature sensor**
* **40 code messages / 25 subscribers**
* **Broadcast code messages**
* **Patented monoblock design**

## DESCRIPTION
**RedGTR** - hydro-acoustic code communication modem.

The device uses a fixed-length signal with a code division to ensure the operation of a point-to-point network consisting of 25 devices,
located in one water area.

**RedGTR** modems support up to 25 addresses - isolating code channels, 40 different code commands can be transmitted to each modem with a very high guarantee of reliability.
 
Ideal for controlling underwater actuators or for creating specialized acoustic releases.

Extremely small size, low power consumption, ease of use and high reliability make code modems **RedGTR**
An ideal solution for controlling autonomous underwater devices.

## TECHNICAL SPECIFICATIONS

| PARAMETER | VALUE |
| :--- | :--- |
| DIMENSIONS (Ф х h) | 64 x 62 mm |
| WEIGHT (dry) | 0.36 kg |
| MAX. OPERATING RANGE<sup>[1](#footnote1)</sup> | 8000 m |
| DEPTH RATING<sup>[2](#footnote2)</sup> | 300 m |
| POWER CONSUMPTION Rx/Tx | 0.33/25 W |
| SUPPLY VOLTAGE | 12 V |
| ACOUSIC SOURCE LEVEL | 170 dB re 1 μPa @ 1 m |
| DATA LINES VOLTAGE | 0 .. 3.3 V |
| BANDWIDTH | 5 .. 15 kHz |
| BIT ERROR RATE | 10<sup>-6</sup> |
| SNR<sup>[3](#footnote3)</sup> | -6 dB |
| MAX. RELATIVE VELOCITY | +/- 3 m/s |
| RATED STARTUP TIME | 100 msec |
| WORKING TEMPERATURE RAGE | -5 .. 50 °C |
| INTERFACE<sup>[4](#footnote4)</sup> | UART 9600 bit/s |
| CONFIGURATION PROTOCOL | NMEA0183 [PTNT](RedGTR_Protocol_Specifications_en.md) |
| CABLE LENGTH<sup>[4](#footnote4)</sup> | 0.5 m |
| SUBSCRIBER'S DIVISION | 25 code channels |
| NUMBER OF CODE MESSAGES | 40 |
  
________________
<a name="footnote1"><sup>1</sup></a> A parameter that determines the maximum range at which a signal can be received, based on electro-acoustic parameters of the transmitter and receiver, spatial decrease in the intensity of sound energy, attenuation in the medium and the acoustic noise level.  
<a name="footnote2"><sup>2</sup></a> In the version without a built-in pressure sensor, maximum depth is 400 meters  
<a name="footnote3"><sup>3</sup></a> This value is obtained without the presence of the multipath effect  
<a name="footnote4"><sup>4</sup></a> Can be changed by the special request
