ucnl/ucnl.github.io/Docs/EN/uWAVE/uWAVE_Specification_en.md

|  |  |
| :--: | --: |
| [www.unavlab.com](https://www.unavlab.com/) <br/> [support@unavlab.com](mailto:support@unavlab.com) | uWAVE underwater acoustic modem specifications |

## KEY FEATURES
* Extremely small size and weight
* Can be applied in underwater wireless sensor networks
* Reliable data transmission with 78 bit/s
* Operating range up to 1000 m
* Subscribers code division
* Propagation time measurement
* Reliable and noise-immune technology of digital broadband acoustic communication
* Low power consumption (Rx/Tx) 0.33/6 W
* Open configuration protocol
* Built-in depth/temperature sensor

## DESCRIPTION
uWAVE is the world smallest<sup>[1](#footnote1)</sup> underwater acoustic digital modem, which allows to communicate 
up to 20 subscribers in area 1000 x 1000 meters with both transparent channel and predefined code messages/telemetry transmission.
Extremely small size, low power consumption and simplicity of usage make uWAVE an ideal solution for AUV control as well as data 
transmission, where dimensions and wight are the bottleneck.

## TECHNICAL SPECIFICATIONS
| PARAMETER | VALUE |
| :-- | :-- |
| DIMENSIONS (Ф х h) | 40 x 45 mm |
| WEIGHT (dry) | 0.16 kg |
| DEPTH RATING |	300 m |
| MAX OPERATING RANGE |	1000 m |
| PAYLOAD DATA RATE | 78 bit/s |
| POWER CONSUMPTION Rx/Tx | 0.33/6 W |
| POWER SUPPLY<sup>[2](#footnote2)</sup> | 	5..12 V |
| DATA LINES VOLTAGE | 	0 .. 3.3 V |
| FREQUENCY BAND | 10 .. 30 kHz |
| BIT ERROR RATE | 10<sup>-6</sup> |
| SNR<sup>[3](#footnote3)</sup> |	-2 dB |
| MAX RELATIVE VELOCITY | +/- 1 m/s |
| RATED START-UP TIME | 100 ms |
| OPERATING TEMPERATURE RANGE | -5 .. 50 °C |
| INTERFACE<sup>[4](#footnote4)</sup> | 	UART 9600 bit/s |
| CONFIGURATION PROTOCOL | NMEA 0183 PUWV |
| CABLE LENGTH<sup>[5](#footnote5)</sup> | 	0.5 m |
| SUBSCRIBERS CODE DIVISION | 20 code channels |
| COMMAND MODE | 16 predefined messages (9 for user applications) |

_________
<a name="footnote1"><sup>1</sup></a> According to open sources, July 2018  
<a name="footnote2"><sup>2</sup></a> Maximum output power can be achieved with 12V power supply  
<a name="footnote3"><sup>3</sup></a> This value is obtained without the presence of the multipath effect   
<a name="footnote4"><sup>4</sup></a> Port speed can be changed by special request  
<a name="footnote5"><sup>5</sup></a> Length can be increased by special request
