ucnl/ucnl.github.io/navigation_and_tracking_systems_en.md

[Main](/) ❯ **Navigation & tracking systems**

|  |
| :---: |
| [www.unavlab.com](https://www.unavlab.com/) <br/> [support@unavlab.com](mailto:support@unavlab.com) |
| [EN](navigation_and_tracking_systems_en.md) \| [RU](navigation_and_tracking_systems_ru.md) |

# Navigation & tracking systems

## General information
* [Comparison table of navigation systems](navigation_systems_comparison_en.md)
### Connectors and autonomous power supplies
* [Underwater battery with connector (3D model STEP)](/documentation/sb_w_connector.STEP)
* [Connector (female, 3D model STEP)](/documentation/ns_connector_f.STEP)
* [Connector (male, 3D model STEP)](/documentation/ns_connector_m.STEP)
* [Connector (assembled, 3D model STEP)](/documentation/ns_m-f.STEP)
* [Connector (assembled, pdf)](/documentation/ns_connector_m-f.pdf)

## Zima
### Ultra-short baseline (USBL) / long baseline (LBL) ranging system
#### Zima2
Available since June 2022
* [Zima2 USBL: Quick start - a sheet of essential links](/documentation/EN/Zima/Zima2_fast_start_en.md)
* [Zima2 USBL: Data brief](/documentation/EN/Zima/Zima2_DataBrief_en.md)
* [Zima2 USBL: User's manual](/documentation/EN/Zima/Zima2_Users_manual_en.md)
* [Zima2-B (direction-finding antenna): Device specification:](/documentation/EN/Zima/Zima2B_Specification_en.md)
* [Zima2-R (responder-beacon): Device specification](/documentation/EN/Zima/Zima2R_Specification_en.md)
* [Zima2-uR (micro responder-beacon): Device specification](/documentation/EN/Zima/Zima2uR_Specification_en.md)
* [Zima2 LBL: Data brief](/documentation/EN/Zima/Zima2_LBL_DataBrief_en.md)
* [Zima2-L (LBL transceiver): Device specification](/documentation/EN/Zima/Zima2L_Specification_en.md)
* [Zima2-B35 (direction-finding antenna): Device specification:](/documentation/EN/Zima/Zima2B35_Specification_en.md)
* [Zima2-R35 (responder-beacon): Device specification](/documentation/EN/Zima/Zima2R35_Specification_en.md)
* [Zima2-BK (direction-finding antenna for Zima2-RK beacons): Device specification:](/documentation/EN/Zima/Zima2BK_Specification_en.md)
* [Zima2-RK (responder-beacon rated to 1000 m): Device specification](/documentation/EN/Zima/Zima2RK_Specification_en.md)
* [Zima2-RK housing: 3D model (STEP)](/documentation/Zima2_RK.STEP)
* [Zima2-RK transducer: 3D model (STEP)](/documentation/RT_1.524525_1_FF.STEP)
* [Zima2 USBL: Communication protocol specification](/documentation/EN/Zima/Zima2_Protocol_Specification_en.md)
* [🐙 AzimuthWebSuite: Online host application for Zima2 USBL](https://docs.unavlab.com/AzimuthWebSuite/)
* [🐙 AzimuthWebSuite: Online host application for Zima2 USBL (Repository)](https://github.com/ucnl/AzimuthWebSuite)
* [🐙 AzimuthSuite: Host application for Zima2 USBL (Win, Source code)](https://github.com/ucnl/AzimuthSuite)
* [🐙 AzimuthSuite: Host application for Zima2 USBL (Win, Download release)](https://github.com/ucnl/AzimuthSuite/releases/download/beta/AzimuthSuite.zip)
* [🖵 AzimuthConsole: Console host application for Zima2 USBL (Win, Linux) - User's manual](/documentation/EN/Zima/AzimuthConsole_manual_en.md)
* [🖵 AzimuthConsole: Repository](https://github.com/ucnl/AzimuthConsole)
* [🖵 AzimuthConsole: Releases](https://github.com/ucnl/AzimuthConsole/releases)
* [🖵 AzimuthConsole: Download release (Win x64)](https://github.com/ucnl/AzimuthConsole/releases/latest/download/AzimuthConsole_win_x64.zip)
* [🖵 AzimuthConsole: Download release (Linux x64)](https://github.com/ucnl/AzimuthConsole/releases/latest/download/AzimuthConsole_linux_x64.zip)
* [🖵 AzimuthConsole: All platforms](https://github.com/ucnl/AzimuthConsole/releases)
* [Zima2 USBL: Product passport (template)](/documentation/EN/Zima/Zima2_technical_passport_en.md)
* [Zima2K USBL: Product passport (template)](/documentation/EN/Zima/Zima2K_technical_passport_en.md)
* [Zima2-OEM35 USBL: Product passport (template)](/documentation/EN/Zima/Zima2-OEM35_technical_passport_en.md)
* [Zima2-35 USBL: Product passport (template)](/documentation/EN/Zima/Zima2-35_technical_passport_en.md)
* [Zima2: Version history & changes](/documentation/EN/Zima/Zima2_version_history_en.md)

#### Common documents for Zima and Zima2 systems
* [Bat&Link Box (power supply and switching unit): Device specification](/documentation/EN/Zima/Bat_n_link_box_Specification_en.md)
* [Bat&Link Box (power supply and switching unit): User's manual](/documentation/EN/Zima/Bat_n_link_box_Users_manual_en.md)
* [Compatibility data sheet for positioning and heading systems](/documentation/EN/Zima/Zima_GNSS_requirements_en.md)
* [Zima-B, Zima2-B, Zima2-B35 assembled with a bracket: 3D model (STEP)](/documentation/Zima2B_uWaveUSBL_uClamp.step)
* [Zima-B bracket: 3D model (STEP)](/documentation/uClamp.step)
* [Zima-B, Zima2-B, Zima2-B35: 3D model (STEP)](/documentation/Zima2B_uWaveUSBL.step)
* [Zima-R, Zima2-R, Zima2-R35: 3D model (STEP)](/documentation/Zima2R_uWaveMax_RedNode.step)
* [Zima-R, Zima2-R, Zima2-R35: Flat bracket (3D model STEP)](/documentation/ZIMA-R_holder_flat.step)
* [Zima-R, Zima2-R, Zima2-R35: Flat bracket (3D model Fusion360 f3d)](/documentation/ZIMA-R_holder_flat.f3d)
* [Zima-R, Zima2-R, Zima2-R35: Tank bracket (3D model STEP)](/documentation/msize_tank_holder.STEP)
* [Zima-R, Zima2-R, Zima2-R35: Wiring diagram](/documentation/EN/Zima/ZimaR_wiring_diagram_en.md)
* [UART-RS422 extension cable](/documentation/EN/Accessories/RS422_extension_cable_en.md)

#### Zima
Supplied from May 2016 to May 2022
* [Zima USBL: Data brief](/documentation/EN/Zima/Zima_DataBrief_en.md)
* [Zima USBL: media, test videos, etc.](/documentation/EN/Zima/media)
* [Zima USBL: User's manual](/documentation/EN/Zima/Zima_Users_manual_en.md)
* [Zima-B (direction-finding antenna): Device specification](/documentation/EN/Zima/Zima_B_Specification_en.md)
* [Zima-R (responder-beacon): Device specification](/documentation/EN/Zima/Zima_R_Specification_en.md)
* [Zima-R 1000 (OEM responder-beacon): Device specification](/documentation/EN/Zima/Zima_R_OEM_Specification_en.md)
* [Zima USBL: Communication protocol specification](/documentation/EN/Zima/Zima_Protocol_Specification_en.md)
* [ZHost: Host application for Zima USBL (Source code)](https://github.com/ucnl/ZHost)
* [ZHost: Host application for Zima USBL (Download release)](https://github.com/ucnl/ZHost/releases/download/2.2/ZHost.zip)

## RedWave
### Underwater GPS (LBL)
* [RedWave: Data brief](/documentation/EN/RedWAVE/RedWAVE_DataBrief_en.md)
* [RedWave: media, test videos, tracks, etc.](/documentation/EN/RedWAVE/media)
* [RedBase (GNSS-equipped sonobuoy): Device specification](/documentation/EN/RedWAVE/RedBASE_Specification_en.md)
* [RedBase (GNSS-equipped sonobuoy, old version): Device specification](/documentation/EN/RedWAVE/RedBASE_old_Specification_en.md)
* [RedNode (navigation receiver for ROVs and AUVs): Device specification](/documentation/EN/RedWAVE/RedNODE_Specification_en.md)
* [RedNav (diver's navigation receiver): Device specification](/documentation/EN/RedWAVE/RedNAV_Specification_en.md)
* [Aquatab S (diver's tablet): Device specification](/documentation/EN/RedWAVE/Aquatab_s_specification_en.md)
* [RedNode: Communication protocol specification](/documentation/EN/RedWAVE/RedWAVE_Protocol_Specification_en.md)
* [RedWave: User's manual](/documentation/EN/RedWAVE/RedWAVE_Users_Manual_en.md)
* [RedNav Host software: User's manual](/documentation/EN/RedWAVE/RedNAV_Host_Users_Manual_en.md)
* [uGPSHub software: User's manual](/documentation/EN/RedWAVE/uGPSHub_Users_manual_en.md)
* [RedNode: Wiring diagram](/documentation/EN/RedWAVE/RedNODE_wiring_diagram_en.md)
* [RedNode: Tank bracket (3D model STEP)](/documentation/msize_tank_holder.STEP)
* [RedNode: 3D model STEP](/documentation/Zima2R_uWaveMax_RedNode.step)
* [RedBase: 3D model (STEP)](/documentation/RedBase_v2.0_3D.STEP)
* [RedNav: 3D model (STEP)](/documentation/RedNav_v2.0_3D.step)
* [RedNav with navigation panel: 3D model (STEP)](/documentation/RedNav_with_compass_3D.step)
* [UGPSHub application for working with navigation receivers (Source code)](https://github.com/ucnl/UGPSHub)
* [UGPSHub application for working with navigation receivers (Download release)](https://github.com/ucnl/UGPSHub/releases/download/1.0/UGPSHub.zip)
* [RedBase_Config application for configuring buoys (Source code)](https://github.com/ucnl/RedBASE_Config/)
* [RedBase_Config application for configuring buoys (Download release)](https://github.com/ucnl/RedBASE_Config/releases/download/1.0/RedBASE_Config.zip)
* [Application for RedNav (Source code)](https://github.com/ucnl/RedNavHost)
* [Application for RedNav (Download release)](https://github.com/ucnl/RedNavHost/releases/download/1.1/RedNAVHost.zip)
* [Test program and procedures (diver version)](/documentation/EN/RedWAVE/RedNAV_PM_en.md)
* [RedWave: Product passport (template)](/documentation/EN/RedWAVE/RedWave_tech_pass_en.md)

## RWLT
### Long baseline tracking system
* [RWLT: Data brief](/documentation/EN/RWLT/RWLT_DataBrief_en.md)
* [RWLT: media, test videos, tracks, etc.](/documentation/EN/RWLT/media.md)
* [RWLT Pinger: Device specification](/documentation/EN/RWLT/RWLT_Pinger_Specification_en.md)
* [RWLT Pinger-K: Device specification](/documentation/EN/RWLT/RWLT_Pinger_K_Specification_en.md)
* [RWLT GIB: Device specification](/documentation/EN/RWLT/RWLT_GIB_Specification_en.md)
* [uNav RWLT Radio dongle: Device specification](/documentation/EN/RWLT/RWLT_RF_Dongle_en.md)
* [RWLT: User's manual](/documentation/EN/RWLT/RWLT_Users_Manual_en.md)
* [uNav RWLT Radio dongle: Communication protocol specification](/documentation/EN/RWLT/uNav_protocol_specification_en.md)
* [💧 uNav: Applications for configuring uNav Radio dongle (Source code)](https://github.com/ucnl/uNav)
* [💧 uNav: Applications for configuring uNav Radio dongle (Download release)](https://github.com/ucnl/uNav/releases/download/1.0/uNav.zip)
* [💧 uNav: User's manual](documentation/EN/RWLT/uNav_application_Users_manual_en.md)
* [Product passport (template)](documentation/EN/RWLT/RWLT_tech_pass_en.md)

## WAYU
### Long baseline tracking system for amateur use
* [WAYU: Data brief](/documentation/EN/WAYU/WAYU_DataBrief_en.md)
* [WAYU: media, test videos, tracks, etc.](/documentation/EN/WAYU/media)
* [WAYU Pinger: Device specification](/documentation/EN/WAYU/WAYU_Pinger_Specification_en.md)
* [WAYU GIB: Device specification](/documentation/EN/WAYU/WAYU_GIB_Specification_en.md)
* [uNav WAYU Radio dongle: Device specification](/documentation/EN/WAYU/WAYU_RF_Dongle_Specification_en.md)
* [uNav WAYU Radio dongle: Communication protocol specification](/documentation/EN/RWLT/uNav_protocol_specification_en.md)
* [WAYU: User's manual](documentation/EN/WAYU/WAYU_Users_Manual_en.md)
* [💧 uNav: User's manual](documentation/EN/RWLT/uNav_application_Users_manual_en.md)
* [💧 uNav: Applications for configuring uNav Radio dongle (Source code)](https://github.com/ucnl/uNav)
* [💧 uNav: Applications for configuring uNav Radio dongle (Download release)](https://github.com/ucnl/uNav/releases/download/1.0/uNav.zip)
* [Product passport (template)](documentation/EN/WAYU/WAYU_tech_pass_en.md)

## [Back to main](README.md)
