ucnl/ucnl.github.io/educational_projects_en.md

[Main](/README.md) ❯ **Our educational projects**

|  |
| :---: |
| [www.unavlab.com](https://www.unavlab.com/) <br/> [support@unavlab.com](mailto:support@unavlab.com) |
| [EN](educational_projects_en.md) \| [RU](educational_projects_ru.md) |

## Our projects for education

> In this section we have collected our products intended for education purposes. Some of them can be purchased, some - to make yourself according to open instructions. In addition, here are online utilities and libraries with open source code, which we ourselves use in our projects and you can also use them absolutely free of charge.

### uSwitch
underwater acoustic modem
* [uSwitch: Device specifications](documentation/EN/uSwitch/uSwitch_Specification_en.md)

### A<sup>3</sup>S - "Acoustic coubes"
A set of basic elements for prototyping hydroacoustic communication and navigation systems
* UNDER CONSTRUCTION [A<sup>3</sup>S ACoubes: User's guide](/documentation/EN/A3S/A3S_Users_Manual_en)
* [A<sup>3</sup>T - Pulse single frequency acoustic Transmitter: Device specification](/documentation/EN/A3S/A3T_Datasheet_en)
* [A<sup>3</sup>R - Signle frequency acoustic receiver](/documentation/EN/A3S/A3R_Datasheet_en)

### UNDER CONSTRUCTION: uSound
Low noise hydrophones
* [uSound - Underwater Sound Recording Equipment Kit: Description]()
* [uSound Box - Autonomous power supply and signal converter: Device specification]()
* [uSound CR - Mid frequency low noise hydrophone: Device specification]()
* [uSound DR - Low frequency low noise hydrophone: Device specification]()

### WAYU
#### Sensibly priced amateur LBL tracking system. By the way, it can be build with "Acoustic cubes"
* [WAYU: Data brief](/documentation/EN/WAYU/WAYU_DataBrief_en.md)
* [WAYU: tracks, videos, tutorials, etc.](/documentation/EN/WAYU/media)
* [Device specification: WAYU Pinger](/documentation/EN/WAYU/WAYU_Pinger_Specification_en.md)
* [Device specification: WAYU GIB](/documentation/EN/WAYU/WAYU_GIB_Specification_en.md)
* [Device specification: WAYU Radio dongle](/documentation/EN/WAYU/WAYU_RF_Dongle_Specification_en.md)
* [User's manual](/documentation/EN/WAYU/WAYU_Users_Manual_en.md)
* [💧 uNav: User's manual](documentation/EN/RWLT/uNav_application_Users_manual_en.md)
* [💧 uNav: uNav Radio dongle application (Source code)](https://github.com/ucnl/uNav)
* [💧 uNav: uNav Radio dongle application (Download release)](https://github.com/ucnl/uNav/releases/download/1.0/uNav.zip)

### Misc.
* [DIY.unavlab.com: Easy to repeat projects for DIY](https://diy.unavlab.com/)
* [Online-utilities:Depth, Speed of sound, raytracing, NMEA0183 etc.](online_utilities_en.md)

### Open-source libraries
* [UCNLNav: A library for solving geodetic and navigation problems *(C#/Rust/Matlab/GNU Octave)*](https://github.com/ucnl/UCNLNav)
* [UCNLPhysics: A library for estimation of fundamental properties of seawater *(C#/Rust/C/Matlab/GNU Octave/JavaScript)*](https://github.com/ucnl/UCNLPhysics)
* [UCNLNMEA: A library for parsing/building NMEA sentences *(C#)*](https://github.com/ucnl/UCNLNMEA)
* [uMCPIno: A lightweight communication protocol with guaranteed delivery *(C#/C/Arduino)*](https://github.com/AlekUnderwater/uMCPIno)
* [uRayTracerDemo: Underwater sound propagation through layered medium](https://github.com/ucnl/uRayTracerDemo)

## [Back to main](README.md)
