ucnl/ucnl.github.io/accessories_en.md

[Main](/README.md) ❯ **Accessories**

|  |
| :---: |
| [www.unavlab.com](https://www.unavlab.com/) <br/> [support@unavlab.com](mailto:support@unavlab.com) |
| [EN](accessories_en.md) \| [RU](accessories_ru.md) |

## Accessories
* [uPress - Underwater button: Device specification](/documentation/EN/Accessories/uPress_Specification_en.md)
* [uBat - Underwater battery packs: Device specifications](/documentation/EN/Accessories/Sub_batteries_en.md)
* [uWire - Extension cable with UART-RS422 converter: Device specification](/documentation/EN/Accessories/RS422_extension_cable_en.md)
* [uClamp-S - Flange rod mount: Device specification](Flange_rod_mound_Specification_en.md)

## [Back to main](README.md)
