ucnl/ucnl.github.io/underwater_acoustic_modems_en.md

[Main](/README.md) ❯ **Underwater acoustic modems**

|  |
| :---: |
| [www.unavlab.com](https://www.unavlab.com/) <br/> [support@unavlab.com](mailto:support@unavlab.com) |
| [EN](underwater_acoustic_modems_en.md) \| [RU](underwater_acoustic_modems_ru.md) |

## Underwater acoustic modems
* [Modems comparison](modems_comparison_en.md)

### uWave
#### underwater acoustic modem
* [Data brief: uWave devices family](/documentation/EN/uWAVE/uWAVE_Family_en.md)
* [uWave family modems comparison tables](/documentation/EN/uWAVE/uWAVE_Modems_comparison_en.md)
* [Device specification: uWave](/documentation/EN/uWAVE/uWAVE_Specification_en.md)
* [Device specification: uWave Max](/documentation/EN/uWAVE/uWAVE_Max_Specification_en.md)
* [Device specification: uWave Max OEM](/documentation/EN/uWAVE/uWAVE_Max_OEM_Specification_en.md)
* [Device specification: uWave USBL Modem](/documentation/EN/uWAVE/uWAVE_USBL_Modem_Specification_en.md)
* [uBear: uWave USBL Modem Host application (Source code)](https://github.com/ucnl/uBear)
* [uBear: uWave USBL Modem Host application(Download release)](https://github.com/ucnl/uBear/releases/download/1.0/uBear.zip)
* [Communication protocol specification: uWave](documentation/EN/uWAVE/uWAVE_Protocol_Specification_en.md)
* [Device wiring diagram: uWave](/documentation/EN/uWAVE/uWAVE_wiring_diagram_en.md)
* [Versions & changes](/documentation/EN/uWAVE/uWAVE_version_history_en.md)
* [uWaveCommander: demo host application (Source code)](https://github.com/ucnl/uWaveCommander)
* [uWaveCommander: demo host application (Download release)](https://github.com/ucnl/uWaveCommander/releases/download/1.1/uWaveCommander.zip)
* [uWaveCommander: brief user's manual](https://github.com/ucnl/uWaveCommander/blob/main/README.md)
* [Arduino library with examples](https://github.com/ucnl/uWAVE_ALib)
* [Examples for Arduino (Old)](https://github.com/ucnl/uWAVE_Arduino)
* [uWave: videos, tutorials, etc.](/documentation/EN/uWAVE/media)
* [3D-model (STEP): uWave](/documentation/uWave.step)
* [3D-model (STL): uWave](/documentation/uWave.stl)
* [3D-model (STEP): uWave Max/uWave Max OEM Transducer](/documentation/uWave_Max.step)
* [3D-model (STEP): uWave Max tank holder](/documentation/msize_tank_holder.STEP)
* [3D-model (STEP): uWave tank holder 3D model](/documentation/uWAVE_holder_tank.step)
* [3D-model (Fusion360 f3d): uWave tank holder 3D model](/documentation/uWAVE_holder_tank.f3d)
* [3D-model (STEP): uWave flat holder](/documentation/uWAVE_holder_flat.step)
* [3D-model (Fusion360 f3d): uWave flat holder](/documentation/uWAVE_holder_flat.f3d)
* [Instructions for firmware updating: uWave family](/documentation/EN/uWAVE/uWAVE_FW_Updating_en.md)

### uSwitch
#### underwater acoustic modem
* [Device specification: uSwitch](documentation/EN/uSwitch/uSwitch_Specification_en.md)

### RedLine
#### underwater acoustic modem
* [Device specification: RedLine](/documentation/EN/RedLINE/RedLine_Specification_en.md)
* [Communication protocol specification: RedLine](/documentation/EN/RedLINE/RedLINE_Protocol_Specifications_en.md)
* [Device wiring diagram: RedLine](/documentation/EN/RedLINE/RedLINE_wiring_diagram_en.md)
* [Demo host application (Repository)](https://github.com/ucnl/RedLINE_Host)
* [Demo host application (Download release)](https://github.com/ucnl/RedLINE_Host/releases/download/1.0/RedLINE_Host.zip)

### RedGTR
#### underwater acoustic code modem
* [Device specification: RedGTR](/documentation/EN/RedGTR/RedGTR_Specifications_en.md)
* [Communication protocol specification: RedGTR](/documentation/EN/RedGTR/RedGTR_Protocol_Specifications_en.md)

## [Back to main](README.md)
