ucnl/ucnl.github.io/underwater_wireless_voice_systems_en.md

[Main](/README.md) ❯ **Underwater Wireless voice systems (Underwater telephone)**

|  |
| :---: |
| [www.unavlab.com](https://www.unavlab.com/) <br/> [support@unavlab.com](mailto:support@unavlab.com) |
| [EN](underwater_wireless_voice_systems_en.md) \| [RU](underwater_wireless_voice_systems_ru.md) |

## Underwater Wireless voice systems (Underwater telephone)
### RedPhone - Underwater telephone
* [Device specification: RedPhone-OS](/documentation/EN/RedPhone/RedPhone_OS_Specification_en.md)
* [User's manual: RedPhone-OS](/documentation/EN/RedPhone/RedPhone_OS_Users_manual_en.md)
* [Device specification: RedPhone-DX](/documentation/EN/RedPhone/RedPhone_DX_Specification_en.md)  
* [User's manual: RedPhone-DX](/documentation/EN/RedPhone/RedPhone_DX_Users_Manual_en.md)
* [Utility for RedPhone-DX configuration (Repository)](https://github.com/ucnl/RedPhoneDXConfig)
* [Utility for RedPhone-DX configuration (Download release)](https://github.com/ucnl/RedPhoneDXConfig/releases/download/1.0/RedPhoneDXConfig.zip)
* [Device specification: RedPhone RF Dongle](/documentation/EN/RedPhone/RedPhone_RF_Dongle_Specification_en.md)
* [Media: tests videos, tutorials etc.](/documentation/EN/RedPhone/media.md)

### Discontinued
* [Device specification: RedPhone-D](/documentation/EN/RedPhone/RedPhone_Specification_en.md)  
* [User's manual: RedPhone-D](/documentation/EN/RedPhone/RedPhone_Users_Manual_en.md)

## [Back to main](README.md)
