ucnl/ucnl.github.io/documentation/EN/F4105/F4105_tech_pass_en.md

[Main](/) ❯ [Other equipment](/underwater_bespoke_systems_en) ❯ **F4105: Product passport (template)**

<h3 align="center">
UCNL LLC
</h3>
<hr>

<table align="center">
<tbody>
  <tr>
    <td>APPROVED<br></td>
    <td>APPROVED</td>
  </tr>
  <tr>
    <td>Head of R&amp;D<br>UCNL LLC<br></td>
    <td>Chief Engineer<br>UCNL LLC<br></td>
  </tr>
  <tr>
    <td>_________________ A. V. Dikarev</td>
    <td>________________ S. M. Dmitriev</td>
  </tr>
  <tr>
    <td>"____" ______________ 20 ___<br></td>
    <td>"____" ______________ 20 ___</td>
  </tr>
</tbody>
</table>

<br/>
<br/>
<br/>
<h1 align="center">PRODUCT PASSPORT <br> "Underwater acoustic release and ascent system"</h1>
<br/>
<br/>
<br/>

## 1. GENERAL INFORMATION ABOUT THE PRODUCT

The system is designed to enable the recovery of various autonomous bottom stations.
The system consists of three main devices:
- **F4105-SU** programming and command transmission unit. It is made as a plastic case with a stainless steel front panel on which the controls and connectors are located. The device contains a built-in power source based on LiFePO4 batteries. It is designed for setting (programming) one of the 64 possible addresses of the **F4105-AU** acoustic wake-up unit, as well as for issuing remote addressed commands to the wake-up units.
- **F4105-AU** acoustic wake-up unit. It is made as a monoblock with a cable and a watertight connector. The wake-up unit is an underwater acoustic receiver designed for long-term (up to 2 months) standby for a special underwater acoustic signal, the parameters of which are set when the wake-up unit is connected to the **F4105-SU** programming and control unit. Upon receiving the specified command, the wake-up unit generates a logic control signal, which is fed to the actuating device, the **F4105-BU** release unit, ensuring uncoupling of the device from the anchor and its ascent.
- **F4105-BU** release unit. The device contains a screw mechanism and a built-in power source based on LiFePO4 batteries and is designed for uncoupling from the anchor by a control signal coming from the control device (**F4104-AU**).

The maximum underwater acoustic communication range between the devices of the kit is 200 m. The release unit and the acoustic wake-up unit have a maximum immersion depth of 200 m. 

Logos, information on the customer's trademarks, design elements and inscriptions that do not affect the technical characteristics of the devices may be applied to the devices.

### 1.1. Specifications and documentation

Full technical specifications of the devices, user's manuals and the e-mail address of technical support:    

| Technical documentation <br/> website | Technical support |
| :---: | :---: |
| [docs.unavlab.com](https://www.docs.unavlab.com/) | [support@unavlab.com](mailto:support@unavlab.com) |
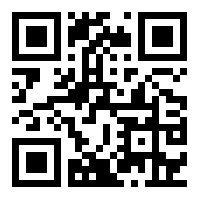
[picture p25: documentation/docs_unavlab_web_qr.png]
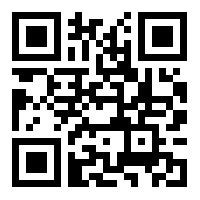
[picture p26: documentation/unavlab_support_email_qr.png]
|  |  |

## 2. CERTIFICATE OF MANUFACTURE AND PACKING. DELIVERY SET. FACTORY NUMBERS. 
<br/>

| Kit production date | _ _ _ _ _ _ _ _ _ _ _ _ _ _ _ _ _ _ _ _ |
| :--- | :--- |
| **Packed and checked against the delivery set** | _ _ _ _ _ _ _ _ _ _ _ _ _ _ _ _ _ _ _ _ |
| **Packer** | _ _ _ _ _ _ _ _ _ _ _ _ _ _ _ _ _ _ _ _ |

<br/>

### 2.1. Location of factory numbers

The factory number is applied by hot stamping on the outer surfaces of the housings of the following devices:
- **F4105-SU** programming and control unit for releases (on the bottom surface of the device)
- **F4105-AU** acoustic wake-up unit (on the end face opposite the cable entry)
- **F4105-BU** release unit (on the load-bearing eye)

No factory number is provided for the other components of the kit.

### 2.2. Delivery set contents

| No. | Name in the delivery set | Qty, <br/> pcs |
| :--- | :--- | :--- |
| 1 | **F4105-SU** programming and control unit | |
| 2 | Underwater acoustic transducer of type **RT-1.524525-1** on a cable ____ m with a load-bearing eye |  |
| 3 | Mains charger of the programming and control unit |  |
| 4 | Adapter for connecting the **F4105-AU** acoustic wake-up unit |  |
| 5 | Adapter for connecting the **F4105-BU** release unit |  |
| 6 | Jumper with clamps |  |
| 7 | Spare fuse |  |
| 8 | **F4105-BU** release unit with lock nut |  |
| 9 | Mains charger of the release unit |  |
| 10 | Spare sealing ring (O-ring) for the lock nut |  |
| 11 | **F4105-AU** acoustic wake-up unit |  |
| 12 | Stabilizer float for **F4105-AU** |  |
| 13 | Reel |  |
| 14 | Reel cover |  |
| 15 | Line ____ mm |  |
| 16 | Rigging shackle | |
| 17 | Carabiner |  |
| 18 | Lock pin | |

### 2.3. List of factory numbers of the items in the delivery set

| No. | Name of the device in the delivery set | Factory number |
| :--- | :--- | :--- |
| 1 | |
| 2 | |
| 3 | |
| 4 | |
| 5 | |
| 6 | |
| 7 | |
| 8 | |
| 9 | |
| 10 | |
| 11 | |
| 12 | |
| 13 | |
| 14 | |
| 15 | |
| 16 | |
| 17 | |
| 18 | |
| 19 | |
| 20 | |
| 21 | |
| 22 | |
| 23 | |
| 24 | |

## 3. MANUFACTURER'S WARRANTY. SERVICE LIFE
The warranty period for the supplied equipment kit is **24 (twenty-four) months** and is counted from the date of actual receipt of the devices by the customer, unless otherwise provided by the contract.
If, during the warranty period, defects or latent defects are found in the product (latent defects are defects that could not be detected during a check usual for the given product and were revealed only during operation), the Supplier shall eliminate them at its own expense by repairing the product or replacing it with a new one within a period of **no more than 30 (thirty) calendar days** and specified in the certificate of transfer of the product for repair.
The warranty period for the product is extended by the time during which the product was not used because of the identified defects. The time during which the product was not used is counted from the date of the written notification to the Supplier of the identified defects until the day of receipt of the product under the acceptance certificate after repair (replacement).
When the product is replaced, the warranty period for the product is counted anew from the date the parties sign the acceptance certificate after repair (replacement).
Delivery of the product for replacement work from the Customer's premises, and after the work has been completed to the Customer's warehouse, is carried out using the Customer's own resources.

The warranty obligations do not apply to the product in the case of:  
- Violation of the rules for operating the product;
- Electrical damage to the product as a result of use with third-party accessories (headsets, chargers, etc.);
- Mechanical damage to the product that caused its loss or failure and occurred after it was handed over to the Customer.

## 4. NOTES ON OPERATION AND STORAGE

### 4.1. Interchangeability
Devices of the same type are fully interchangeable electrically. 

### 4.2. Special storage requirements
The use of organic solvents and/or aggressive acids and/or alkalis to remove contamination from the surface of the devices and cables is not allowed.

### 4.3 Special safety precautions during operation
The devices are not rescue or human life-support equipment.
Any work using the devices must be performed in strict compliance with the requirements of the intersectoral rules for diving/underwater operations, as well as the departmental and local regulations in force for the Customer governing diving operations.
