ucnl/ucnl.github.io/documentation/RU/A3S/A3R_Datasheet_ru.md

[Главная](/README_RU) ❯ [Наши проекты для образования](/educational_projects_ru) ❯ **ACubes A<sup>3</sup>R: Спецификация устройства**

<details>
<summary><b>ℹ Рекомендации для печати/сохранения в PDF</b></summary>

1. Нажмите **Ctrl+P** (macOS: **Cmd+P**)
2. В настройках принтера выберите **«Сохранить как PDF»** (Microsoft Print to PDF)
3. В поле **«Страницы»** укажите диапазон, исключая первую и последнюю страницу
4. Отключите **верхние и нижние колонтитулы** (заголовки/URL/page numbers)
5. В **Chrome/Edge**: в доп. настройках → «Поля» → **Нет** | в **Firefox**: «Поля и колонтитулы» → **Нет**
6. Нажмите **Печать** и укажите куда сохранить PDF

</details>

|  |  |
| :---: | ---: |
| [www.unavlab.com](https://www.unavlab.com/) <br/> [support@unavlab.com](mailto:support@unavlab.com) | **ACubes A<sup>3</sup>R** <br/> Спецификация |

## КЛЮЧЕВЫЕ ОСОБЕННОСТИ

* **Идеальное решение для образовательных проектов и обучения**
* **Совместимость с модулями [A<sup>3</sup>T](A3T_Datasheet_ru.md)**
* **Объединяются в стек до 12 штук**
* **Низкое энергопотребление - 20 мА**

## ОПИСАНИЕ

**ACubes A<sup>3</sup>R** - модуль гидроакустического одночастотного приемника с логическим выходом. 
Устройства **A<sup>3</sup>R** могут объединятся с импульсным передатчиком **[A<sup>3</sup>T](A3T_Datasheet_ru.md)** и совместно использовать одну гидроакустическую приемопередающую антенну.
Также устройства могут объединятся в стек до 12 шт, и каждый такой стек может объединяться с одним передатчиком. В этом случае каждый приемник и передатчик использует отдельную антенну.

В качестве антенны могут применятся:
- [R-1.d3505-1](/documentation/RU/Transducers/R_1.d3505_1_Specification_ru) - приемная антенна на основе пластинчатого пьезоэлемента
- [RT-1.332820-1](https://docs.unavlab.com/documentation/RU/Transducers/RT_1_332820_1_Specification_ru.html) - малогабаритная приемопередающая антенна
- [RT-2.332820-1](https://docs.unavlab.com/documentation/RU/Transducers/RT_2_332820_1_Specification_ru.html) - двухэлементная антенна с повышенной чувствительностью для работы с поверхности
- [RT-1.524525-1](https://docs.unavlab.com/documentation/RU/Transducers/RT-1.524525-1_specification_ru.html) - антенна с повышенной чувствительностью

## ТЕХНИЧЕСКИЕ ХАРАКТЕРИСТИКИ

| ПАРАМЕТР | ЗНАЧЕНИЕ |
| :--- | :--- |
| ГАБАРИТЫ | 100 x 50 х 10  мм |
| ВЕС | 0.015 кг |
| МАКСИМАЛЬНАЯ ДАЛЬНОСТЬ АКУСТИЧЕСКОЙ СВЯЗИ<sup>[1](#footnote1)</sup> | 300 м |
| ЭНЕРГОПОТРЕБЛЕНИЕ | 20 мА |
| НАПРЯЖЕНИЕ ПИТАНИЯ | 5 .. 15 В |
| НАПРЯЖЕНИЕ ЛИНИИ ДАННЫХ | TTL/LVTTL (0 .. 3.3/0 .. 5) В |
| НЕСУЩАЯ ЧАСТОТА | 25000 Гц |
| ЗАЩИТНЫЙ ИНТЕРВАЛ ПОСЛЕ ДЕТЕКТИРОВАНИЯ СИГНАЛА | 100 мсек |
| МАКСИМАЛЬНАЯ ОТНОСИТЕЛЬНАЯ СКОРОСТЬ | +/- 2 м/с |
| ДИАПАЗОН РАБОЧИХ ТЕМПЕРАТУР | -5 .. 50 °C |

________________
<a name="footnote1"><sup>1</sup></a> Параметр, определяющий максимальную дальность, на которой возможен прием сигнала, исходя из электроакустических параметров передатчика и приемника, пространственного убывания интенсивности звуковой энергии, затухания в среде и уровня гидроакустических помех.  

## РАСПИНОВКА И ПОДКЛЮЧЕНИЕ

|  |
| :---: |
| **A<sup>3</sup>R** <br/> *расположение и функции контактных площадок* |

### РАЗЪЕМ XS1

| НОМЕР КОНТАКТА | I/O | ФУНКЦИЯ |
| :--- | :---: | :--- |
| 1 | I | Вход антенны  |
| 2 | - | GND |
| 3 | - | GND |
| 4 | I | Соединен с контактом №1 |

### РАЗЪЕМ XS2

| НОМЕР КОНТАКТА | I/O | АКТИВНОЕ СОСТОЯНИЕ | ФУНКЦИЯ |
| :--- | :---: | :---: | :--- |
| 1 | - | - | GND |
| 2 | O | 0 | Строб при начале передачи |
| 3 | - | - | GND |
| 4 | I | 0 | Инициация передачи импульса |
| 5 | - | - | GND |
| 6 | O | 0 | Строб приемника №1 |
| 7 | - | - | GND |
| 8 | O | 0 | Строб приемника №2 |
| 9 | - | - | GND |
| 10 | O | 0 | Строб приемника №3 |
| 11 | - | - | GND |
| 12 | O | 0 | Строб приемника №4 |
| 13 | - | - | GND |
| 14 | O | 0 | Строб приемника №5 |
| 15 | - | - | GND |
| 16 | O | 0 | Строб приемника №6 |
| 17 | - | - | GND |
| 18 | - | - | NC |
| 19 | - | - | GND |
| 20 | - | - | +U<sub>пит.</sub> |

### РАЗЪЕМ XS3

| НОМЕР КОНТАКТА | I/O | АКТИВНОЕ СОСТОЯНИЕ | ФУНКЦИЯ |
| :--- | :---: | :---: | :--- |
| 1 | O | 0 | Общий строб приемников |
| 2 | - | - | GND |
| 3 | - | - | Резерв |
| 4 | - | - | GND |
| 5 | O | 0 | Строб приемника №7 |
| 6 | - | - | GND |
| 7 | O | 0 | Строб приемника №8 |
| 8 | - | - | GND |
| 9 | O | 0 | Строб приемника №9 |
| 10 | - | - | GND |
| 11 | O | 0 | Строб приемника №10 |
| 12 | - | - | GND |
| 13 | O | 0 | Строб приемника №11 |
| 14 | - | - | GND |
| 15 | O | 0 | Строб приемника №12 |
| 16 | - | - | GND |
| 17 | - | - | Резерв |
| 18 | - | - | GND |
| 19 | - | - | +U<sub>пит.</sub> |
| 20 | - | - | GND |

### РАЗЪЕМ XS4

| НОМЕР КОНТАКТА | I/O | ФУНКЦИЯ |
| :--- | :---: | :--- |
| 1 | O | Выход предусилителя |
| 2 | O | Соединен с контактом #1 |
| 3 | - | Резерв |

### РАЗЪЕМ XP2

| НОМЕР КОНТАКТА | I/O | ФУНКЦИЯ |
| :--- | :---: | :--- |
| 1 | I | 5 .. 15 В  |
| 2 | - | GND |

### ПЕРЕКЛЮЧАТЕЛИ (ПЕРЕМЫЧКИ) P0 - P12

### Переключатель P0 - Режим ответчика

Перемычка связывает контакт 1 (Общий строб приемников) разъема XS3 и контакт 4 (Инициация передачи импульса) разъема XS2. 
Таким образом, если перемычка установлена и модуль A<sup>3</sup>R сопряжен с модулем [A<sup>3</sup>T](A3T_Datasheet_ru.md), то при приеме акустического сигнала, будет инициирована передача ответного импульса. 

Переключатель P0 управляет включением и выключением режима ответчика для сопряженных модулей A<sup>3</sup>R и [A<sup>3</sup>T](A3T_Datasheet_ru.md).

### Переключатели P1 - P12 - Адрес на шине

Данные переключатели позволяют вывести строб приемника на заданную линию шины, образуемой разъемами XS2 и XS3. Данная функция может использоваться при сопряжении нескольких приемников с индивидуальными приемными антеннами для возможности вывода выходного сигнала от каждого приемника на разные линии шины.
