ucnl/ucnl.github.io/documentation/EN/Accessories/RS422_extension_cable_en.md

[Main](/README) ❯ [Accessories](/accessories_en) ❯ **uWire - Extension cable with UART-RS422 converter**

|  |  |
| :---: | ---: |
| [www.unavlab.com](https://www.unavlab.com/) <br/> [support@unavlab.com](mailto:support@unavlab.com) | **uWire** <br/> Extension cable with UART-RS422 converter <br/> Device specification |

## KEY FEATURES

* **High-quality polyurethane shell**
* **Environment-resistant**
* **Load-bearing core**

## DESCRIPTION

The extension cable with a UART-RS422 converter is designed for power supply and data interfacing of Zima-B/Zima2-B, Zima2-R devices in the standard configuration, and can also be used to work with uWave/uWave MAX modems.
The lower part of the cable has a sealed connector, next to the connector there is a UART-RS422 interface converter, filled in a polyurethane compound.

## TECHNICAL SPECIFICATIONS

| PARAMETER | VALUE |
| :--- | :--- |
| MAIN (RS-422) CABLE DIAMETER | 9 ± 0.5 mm |
| UART CABLE DIAMETER | 6 ± 0.5 mm |
| LENGTH OPTIONS | 5 m / 10 m / 20 m |
| PROTECTIVE COATING MATERIAL | Polyurethane |
| CABLE INSULATION MATERIAL | Polyurethane |
| WORKING TEMPERATURE RANGE | -20 .. 60 °С |

## CABLE CORES FUNCTIONS (in version without upper connector)

| CORE COLOR | FUNCTION |
| :--- | :--: |
| 🟥 Red | + U<sub>пит.</sub> |
| ⬛ Black | - U<sub>пит.</sub> |
| 🟩 Green | Tx+ |
| 🟫 Brown | Tx- |
| ⬜ White/Transparent | Rx+ |
| 🟦 Blue | Rx- |
