ucnl/ucnl.github.io/documentation/EN/RWLT/RWLT_RF_Dongle_en.md

[Main](/../../) ❯ [Navigation & tracking systems](/navigation_and_tracking_systems_en) ❯ **Device specification: uNav RWLT RF dongle**

|  | RWLT RF dongle |
| :---: | ---: |
| [www.unavlab.com](https://www.unavlab.com/) <br/> [support@unavlab.com](mailto:support@unavlab.com) | **uNav RWLT RF dongle** - Navigation receiver <br/> Device specification |

## KEY FEATURES

* **IP68**
* **GNSS protocol emulation**
* **Built-in GNSS receiver**

## DESCRIPTION

The receiver of the navigation signal of the buoys of the system [RWLT](RWLT_DataBrief_en.md) receives signals from the [RWLT GIB](RWLT_GIB_Specification_ru.md) navigation buoys and determines the location of the underwater object on which the [RWLT Pinger](RWLT_Pinger_Specification_ru.md) pinger is located. The receiver is designed as a maintenance-free monoblock on a cable.

## TECHNICAL SPECIFICATIONS

| PARAMETER | VALUE |
| :--- | :--- |
| DIMENSIONS (Ф х h, w/o cable) | 90 x 330 mm |
| WEIGHT (w/ 10 m cable) | 1.4 kg |
| CABLE LENGTH | 10 m |
| CABLE DIAMETER | 10 ± 0.5 mm |
| WORKING TEMPERATURE RANGE | -10 .. 50 °С |
| MAX. RF RANGE<sup>[1](#footnote1)</sup> | 1000 m |
| RADIO COMMUNICATION | 433 MHz, receiving only |
| CONNECTION | to a PC USB-port via [Bat&Link Box](documentation/EN/Zima/Bat_n_link_box_Specification_en) |
| INTERFACE | RS-422, 38400 baud |
| PROTOCOL | [NMEA0183 (GGA, RMC), UNV](/uNav_protocol_specification_en) |
| BUILT-IN GNSS UNIT | GPS/GLONASS |
| BODY MATERIAL | Polyurethane |

________________
<a name="footnote1"><sup>1</sup></a>Achieved in the absence of interference, in open areas.
