ucnl/ucnl.github.io/documentation/EN/RedWAVE/media.md

[Main](/../../) ❯ [Navigation & tracking systems](/navigation_and_tracking_systems_en) ❯ **RedWAVE: tracks, videos, tutorials, etc.**

|  |
| :---: |
| [www.unavlab.com](https://www.unavlab.com/) <br/> [support@unavlab.com](mailto:support@unavlab.com) |
| [EN](\documentation\EN\RedWAVE\media) \| [RU](\documentation\RU\RedWAVE\media) |

## RedWAVE media: tests videos, tutorials, etc.

| Diver's movement track obtained with [RedWAVE](/documentation/EN/RedWAVE/RedWAVE_DataBrief_en) |
| :--- |
| 23 October 2022 |
| [🗺 Diving Center "Spas-Kamenka" (Google Maps)](https://goo.gl/maps/JhHLn1t4AWQ5sQvd6) |
| [🡇 Download track (KML)](/documentation/UGPSHub_Tracks_23_10_2022.kml) |
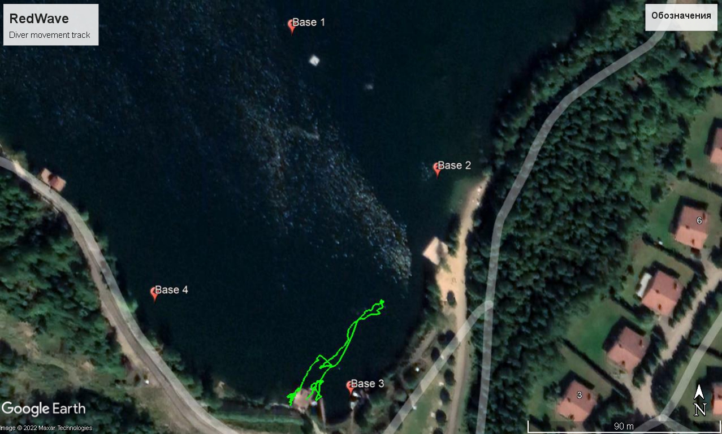
[picture p33: documentation/Dslt_readwave_20_10_2022.jpg]
|  |
|  |
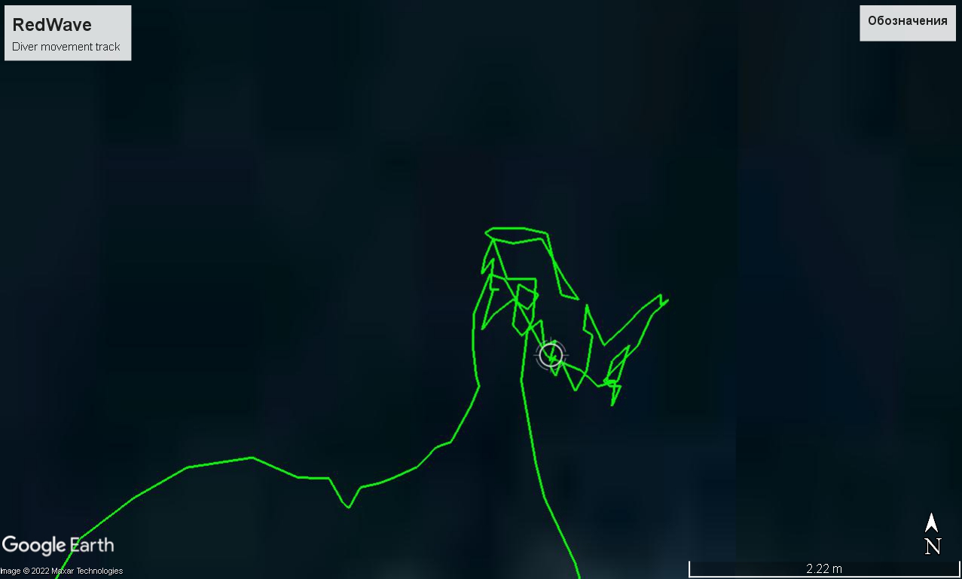
[picture p34: documentation/Dslt_readwave_20_10_2022_zmax.jpg]
|  |

| Diver's movement track obtained with [RedWAVE](/documentation/EN/RedWAVE/RedWAVE_DataBrief_en) |
| :--- |
| 18 September 2022 |
| [Moscow river, Moscow, Russia (Google Maps)](https://goo.gl/maps/zJtaqhawt4GzD3Em8) |
| [🡇 Download track (KML)](/documentation/UGPSHub_Tracks_09-29-24.kml) |
|  |

| Diver's movement track obtained with [RedWAVE](/documentation/EN/RedWAVE/RedWAVE_DataBrief_en) |
| :--- |
| 08 August 2022 |
| [Moscow river, Moscow, Russia (Google Maps)](https://goo.gl/maps/zJtaqhawt4GzD3Em8) |
| [🡇 Download track (KML)](/documentation/UGPSHub_Tracks_23-32-48.kml) |
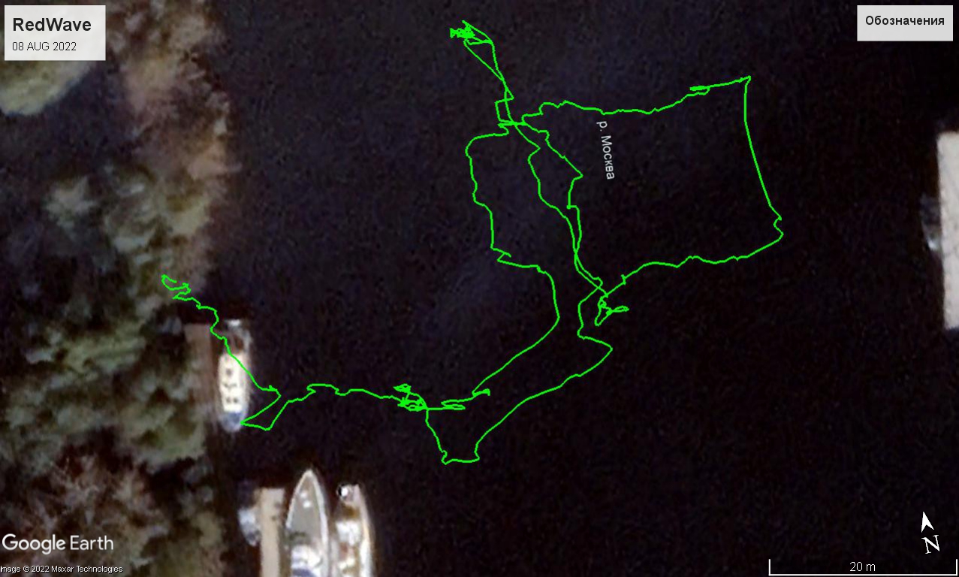
[picture p35: documentation/UGPSHub_Tracks_23-32-48.jpg]
|  |

| Diver's movement track obtained with [RedWAVE](/documentation/EN/RedWAVE/RedWAVE_DataBrief_en) |
| :--- |
| 22 November 2020 |
| [Khimkinskoye Vodokhranilishche, Moscow, Russia (Google Maps)](https://goo.gl/maps/T3ipWGqQJ65j9p5w7) |
| [🡇 Download track (KML)](/documentation/rednode_track_22-10-2020-13-39-24.kml) |
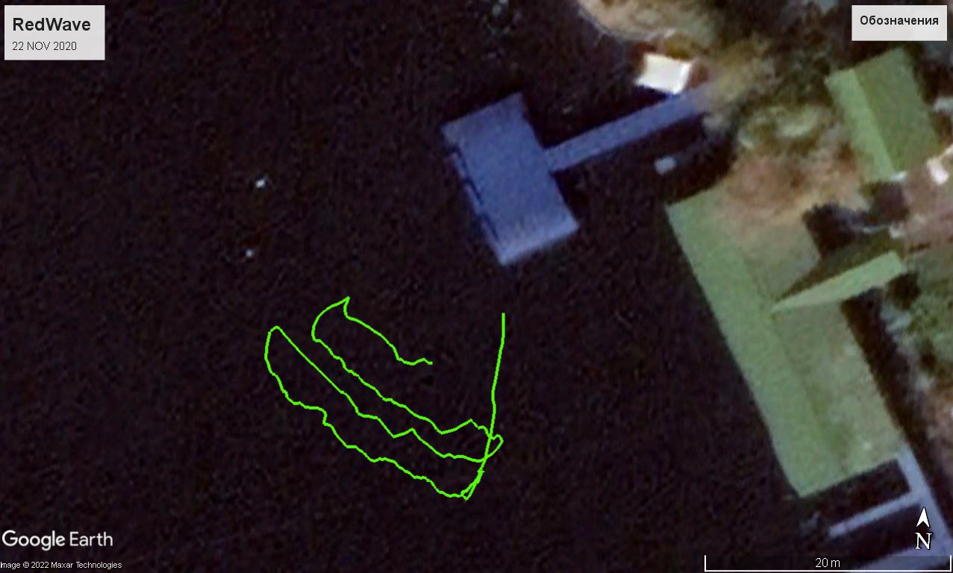
[picture p36: documentation/rednode_track_22-10-2020-13-39-24.jpg]
|  |

| ROV navigation via [RedWAVE](/documentation/EN/RedWAVE/RedWAVE_DataBrief_en) |
| :--- |
| 11 November 2020 |
| [Yujzniy pond, Volgograd, Russia (Google Maps)](https://goo.gl/maps/xjJrX28KmWDdJxLC9) |
| [🡇 Download track (KML)](/documentation/UGPSHub_Tracks_14-31-20.kml) |
|  |

| ROV & diver simultaneous navigation via [RedWAVE](/documentation/EN/RedWAVE/RedWAVE_DataBrief_en) |
| :--- |
| 7 November 2020 |
| [Amerievsky dolomite quarry, Moskow, Russia (Google Maps)](https://goo.gl/maps/BftxRy1cKA6ZsUUP6) |
| [🡇 Download track (Diver, KML)](/documentation/7-11-2020_17-30.kml) |
| [🡇 Download track (ROV, KML)](/documentation/UGPSHub_Tracks_17-30-59.kml) |
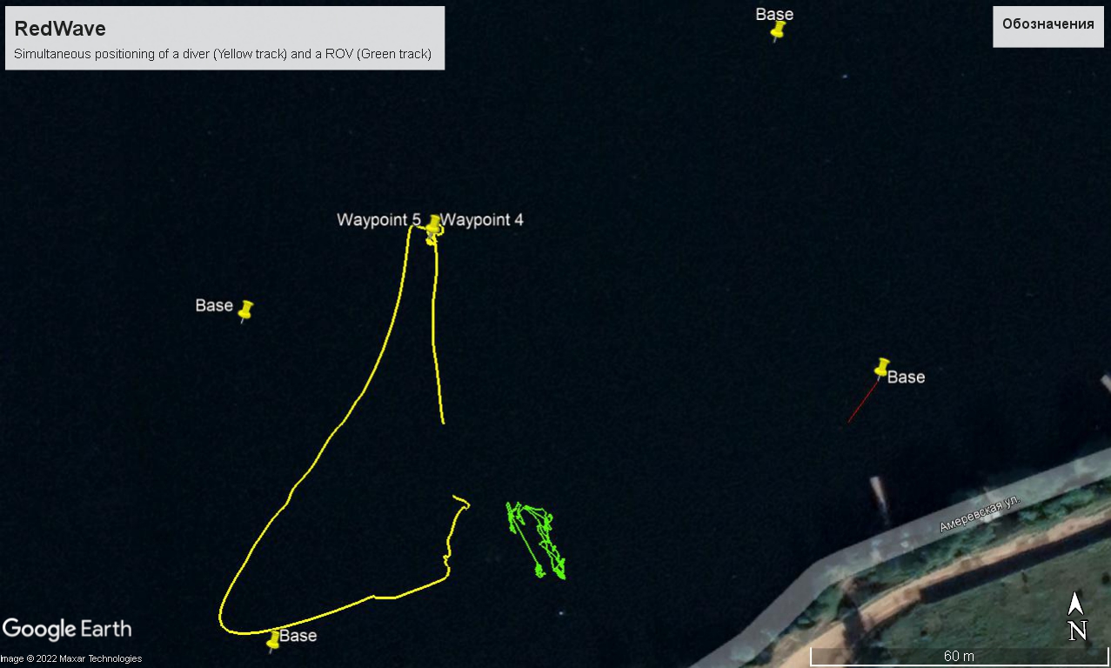
[picture p37: documentation/7-11-2020_17-30.jpg]
|  |

| Working with [RedWAVE/DiveNET GPS](/documentation/EN/RedWAVE/RedWAVE_DataBrief_en) underwater GPS |
| :--- |
| 3 March 2020 |
| [Monterey Bay, California, US (Google Maps)](https://goo.gl/maps/SZ3tC49dcVGnequB7) |
| [🡇 Download track (KML)](/documentation/rednav_track_03-03-2020.kml) |
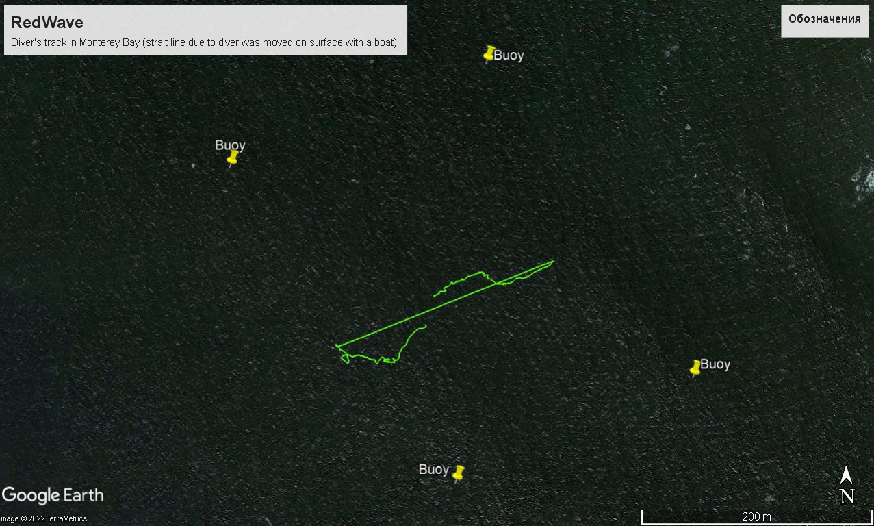
[picture p38: documentation/rednav_track_03-03-2020.jpg]
|  |
| <a href="https://youtu.be/_2PoVsB1wEY" target="_blank">RedWAVE Underwater GPS Monterey, California, US</a> |

| Palying with a small ROV equipped with [RedWAVE](/documentation/EN/RedWAVE/RedWAVE_DataBrief_en) underwater GPS |
| :--- |
| 18 April 2019 |
| [Pichuga river, Volgograd Oblast, RU (Google Maps)](https://goo.gl/maps/Qix3nK84i7inM3FGA) |
| [🡇 Download track (1, KML)](/documentation/rednode_track_18042019_092548.kml) |
| [🡇 Download track (2, KML)](/documentation/rednode_track_18042019_131504.kml) |
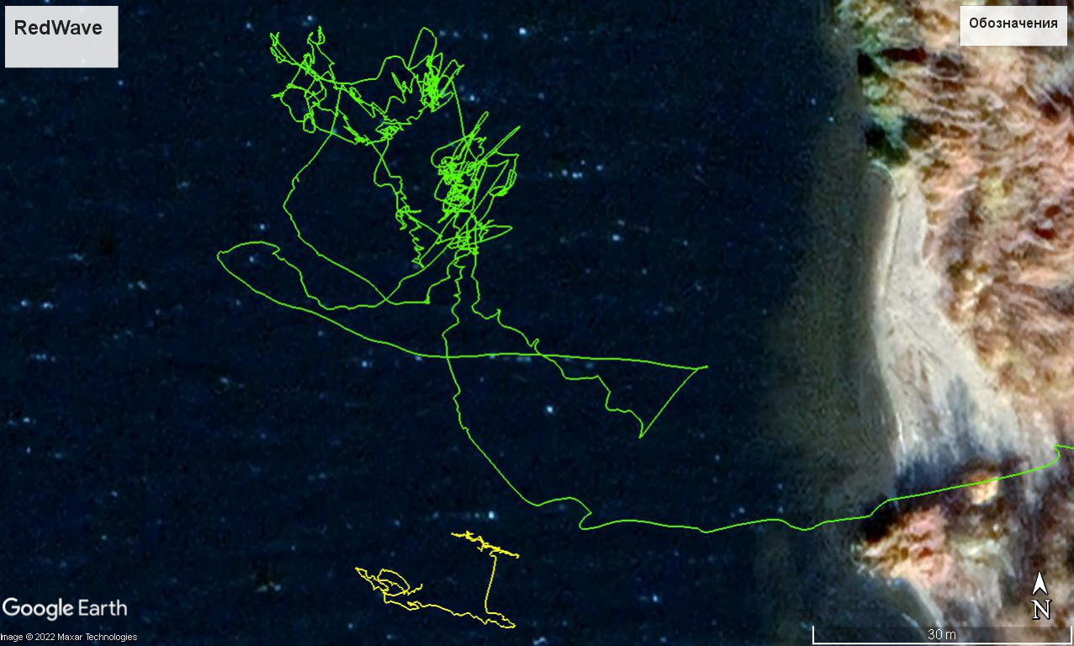
[picture p39: documentation/rednode_track_18042019_092548.jpg]
|  |
| <a href="https://youtu.be/xaVfjhPIURc" target="_blank">RedWAVE Underwater GPS on ROV</a> |

| Working with [RedWAVE](/documentation/EN/RedWAVE/RedWAVE_DataBrief_en) underwater GPS |
| :--- |
| 30 October 2018 |
| [Casino Point Underwater Park, Avalon, California, US (Google Maps)](https://goo.gl/maps/Qv7d9sCtDehMiVtg9) |
| [🡇 Download track (1, KML)](/documentation/rednav_track_30-10-2018_13-40.kml) |
| [🡇 Download track (2, KML)](/documentation/rednav_track_30-10-2018_21-42.kml) |
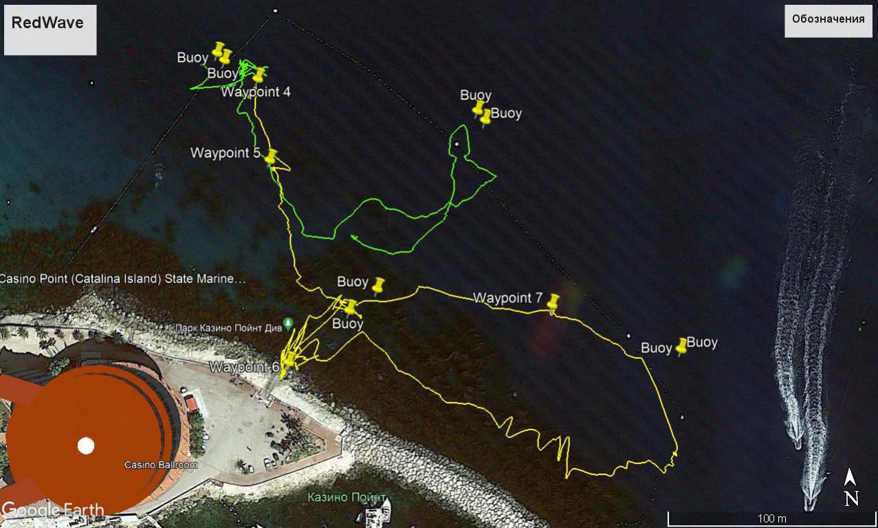
[picture p40: documentation/rednav_track_30-10-2018_13-40.jpg]
|  |
| <a href="https://youtu.be/nqmbPgxIonM" target="_blank">RedWAVE Underwater GPS Casino Point Underwater Park, Avalon, California, US</a>   |

## [To all media](/../../media_videos_en)
