ucnl/ucnl.github.io/documentation/EN/RWLT/media.md

[Main](/../../) ❯ [Navigation & tracking systems](/navigation_and_tracking_systems_en) ❯ **RWLT: tracks, videos, tutorials, etc.**

|  |
| :---: |
| [www.unavlab.com](https://www.unavlab.com/) <br/> [support@unavlab.com](mailto:support@unavlab.com) |
| [EN](\documentation\EN\RWLT\media) \| [RU](\documentation\RU\RWLT\media) |

## RWLT media: videos, tracks, etc.

| Towing pinger and tracking an ROV |
| :--- |
| 27 July 2021 |
| [🗺 6th Gateway of Volga-Don Canal, Volgograd (Google Maps)](https://goo.gl/maps/rmktnCWcauE4HbcZ6) |
| [🡇 Download track (KML)](/documentation/RWLT_Tracks_27_JUL_2021_06-48-42.kml) |
|  |

| Static test (GIBs in ice holes, pinger is submerged on a rope) |
| :--- | 
| 09 February 2021 |
| [🗺 Youzhny Pond, Volgograd (Google Maps)](https://goo.gl/maps/8hZFEP7M3Z8YtdAo6) |
| [🡇 Download track (KML)](/documentation/09-02-2021_RWLT_static_ice.kml) |
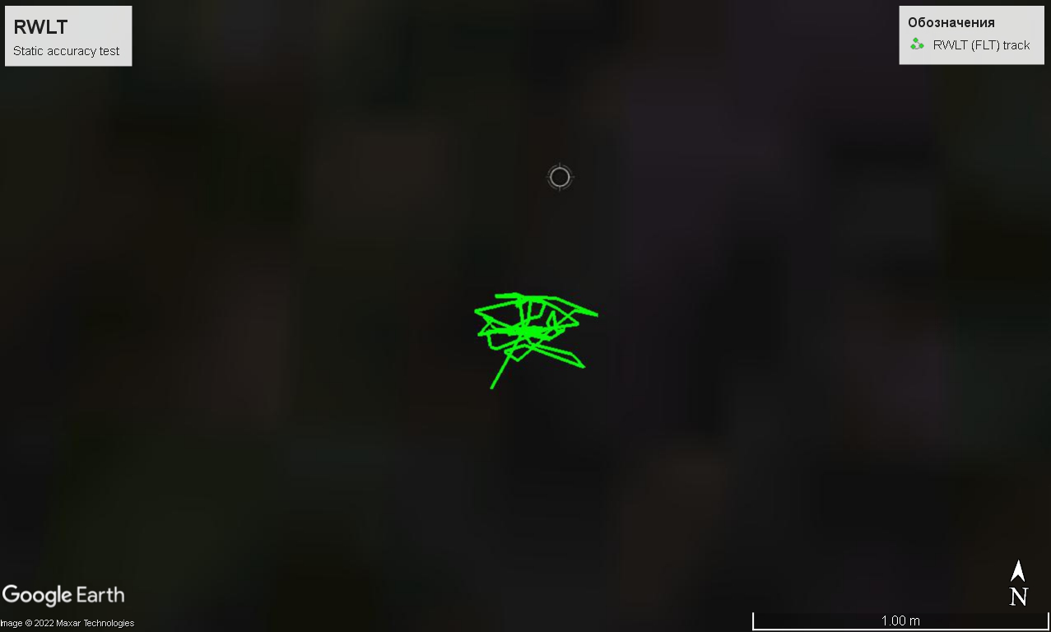
[picture p41: documentation/09-02-2021_RWLT_static_ice.jpg]
|  |

## [To all media](/../../media_videos_en)
