ucnl/ucnl.github.io/documentation/RU/RedLine_Specification_ru.md

|  |  |
| :---: | ---: |
| [www.unavlab.com](https://www.unavlab.com/) <br/> [support@unavlab.com](mailto:support@unavlab.com) | **RedLINE** - Гидроакустический модем <br/> Спецификация устройства |

## КЛЮЧЕВЫЕ ОСОБЕННОСТИ

* **Дальность связи до 8000 м**
* **Надежная передача данных со скоростью 80 bit/s**
* **Предельно малые габариты и масса**
* **Может применятся в беспроводных подводных сетях сенсоров**
* **Кодовое разделение абонентов**
* **Высоконадежная цифровая гидроакустическая связь**
* **Низкое энергопотребление (Rx/Tx) 0.33/25 Вт**
* **Открытый протокол сопряжения**

## ОПИСАНИЕ

**RedLINE** - семейство модемов беспроводной подводной цифровой связи, реализующих прозрачный канал передачи. 

Модемы **RedLINE** имеют непревзойденное соотношение таких параметров как энергопотребление/габариты/надежность и дальность передачи.
Унифицированный с устройствами **RedNODE** моноблочный корпус позволяет использовать типовые решения для интеграции.

Малый размер, низкое энергопотребление и простота использования делают **RedLINE** идеальным решением как для малогабаритных ТНПА/АНПА так 
и для более крупных устройств.

Функция кодового разделения абонентов позволяет максимально эффективно решать задачи передачи данных для нескольких устройств.

## ТЕХНИЧЕСКИЕ ХАРАКТЕРИСТИКИ

| ПАРАМЕТР | ЗНАЧЕНИЕ |
| :--- | :--- |
| ГАБАРИТЫ (Ф х h) | 64 x 62 мм |
| ВЕС (сухой) | 0.36 кг |
| МАКСИМАЛЬНАЯ ГЛУБИНА | 400 м |
| МАКСИМАЛЬНАЯ ДАЛЬНОСТЬ СВЯЗИ | 8000 м |
| СКОРОСТЬ ПЕРЕДАЧИ ДАННЫХ | 78 бит/с |
| ЭНЕРГОПОТРЕБЛЕНИЕ Rx/Tx | 0.33/25 Вт |
| НАПРЯЖЕНИЕ ПИТАНИЯ | 12 В |
| НАПРЯЖЕНИЕ ЛИНИЙ ДАННЫХ | 0 .. 3.3 В |
| ПОЛОСА ЧАСТОТ | 5 .. 15 кГц |
| BIT ERROR RATE | 10<sup>-6</sup> |
| SNR<sup>[1](#footnote1)</sup> | -6 дБ |
| МАКСИМАЛЬНАЯ ОТНОСИТЕЛЬНАЯ СКОРОСТЬ | +/- 3 м/с |
| ВРЕМЯ СТАРТА | 100 мсек |
| ДИАПАЗОН РАБОЧИХ ТЕМПЕРАТУР | -5 .. 50 °C |
| ИНТЕРФЕЙС СОПРЯЖЕНИЯ<sup>[2](#footnote4)</sup> | UART 9600 бит/с |
| ПРОТОКОЛ СОПРЯЖЕНИЯ | NMEA 0183 [PTNT](RedLINE_Protocol_Specification_ru.md) |
| ДЛИНА КАБЕЛЯ<sup>[2](#footnote2)</sup> | 0.5 м |
| СХЕМА РАЗДЕЛЕНИЯ АБОНЕНТОВ | 20 кодовых каналов |
  
________________
<a name="footnote1"><sup>1</sup></a> Значение получено без учета эффекта многолучевого распространения   
<a name="footnote2"><sup>2</sup></a> Значение может быть изменен по запросу
