ucnl/ucnl.github.io/documentation/RU/Zima/Zima2R_Specification_ru.md

[Главная](/README_RU) ❯ [Гидроакустические навигационные и трекинговые системы](/navigation_and_tracking_systems_ru) ❯ **Zima2-R - маяк-ответчик: Спецификация устройства**

<details>
  <summary><b>ℹ Рекомендации для печати/сохранения в PDF</b></summary>
  <br>
  <ol>
    <li>Нажмите <b>Ctrl+P</b> (macOS: <b>Cmd+P</b>)</li>
    <li>В настройках принтера выберите <b>«Сохранить как PDF»</b> (Microsoft Print to PDF)</li>
    <li>В поле <b>«Страницы»</b> укажите диапазон, исключая первую и последнюю страницу</li>
    <li>Отключите <b>верхние и нижние колонтитулы</b> (заголовки/URL/page numbers)</li>
    <li>В <b>Chrome/Edge</b>: в доп. настройках → «Поля» → <b>Нет</b> | в <b>Firefox</b>: «Поля и колонтитулы» → <b>Нет</b></li>
    <li>Нажмите <b>Печать</b> и укажите куда сохранить PDF</li>
  </ol>
</details>

|  | zima_r_wbat |
| :---: | ---: |
| [www.unavlab.com](https://www.unavlab.com/) <br/> [support@unavlab.com](mailto:support@unavlab.com) | **Zima2-R** - маяк-ответчик навигационной системы **Zima2 USBL** <br/> спецификация устройства |

## КЛЮЧЕВЫЕ ОСОБЕННОСТИ

* **Предельно малые габариты и масса**
* **Дальность связи до 3000<sup>[1](#footnote1)</sup> метров**
* **Высоконадежная цифровая гидроакустическая связь устойчивая к многолучевому распространению**
* **Кодовое разделение абонентов - до 16 изолирующих адресов**
* **Низкое энергопотребление (Rx/Tx) 0.33/10 Вт**
* **Встроенный датчик давления/температуры**
* **Патентованная<sup>[*](#footnote_a1)</sup> моноблочная конструкция**

## ОПИСАНИЕ

**Zima2-R** - маяк-ответчик ультракороткобазисной навигационной системы [Zima2 USBL](Zima2_DataBrief_ru.md).  

Устройство предназначено для размещения на подводном объекте с целью определения местоположения это объекта в реальном времени при помощи пеленгационной антенны [Zima2-B](Zima2B_Specification_ru.md). 

Устройство может быть как автономным (с дополнительным [батарейным блоком](/documentation/RU/Accessories/Sub_batteries_ru#sb2448lf)), так и сопрягаться энергетически с носителем. 

Предельно малый размер, простота использования и низкое энергопотреблениеделают пеленгационную систему [Zima2 USBL](Zima2_DataBrief_ru.md) идеальным решением для работы с автономными и телеуправляемыми аппаратами а так же определения относительного местоположения водолазов.

________________
<a name="footnote_a1"><sup>*</sup></a> Патент RU2659299C1.  

## ТЕХНИЧЕСКИЕ ХАРАКТЕРИСТИКИ

| ПАРАМЕТР | ЗНАЧЕНИЕ |
| :--- | :--- |
| ГАБАРИТЫ (Ф х h) | 64 x 62 мм |
| ВЕС (сухой)<sup>[2](#footnote2)</sup> | 0.3 кг |
| МАКСИМАЛЬНАЯ ГЛУБИНА | 300 м |
| РАЗРЕШЕНИЕ ПО ГЛУБИНЕ | 0.6 м |
| МАКСИМАЛЬНАЯ ДАЛЬНОСТЬ АКУСТИЧЕСКОЙ СВЯЗИ<sup>[1](#footnote1)</sup> | 3000 м |
| РАЗВИВАЕМОЕ АКУСТИЧЕСКОЕ ДАВЛЕНИЕ | 170 дБ re 1 мкПа @ 1 м |
| НЕСУЩАЯ ЧАСТОТА | 20100 Гц | 
| ТОЧНОСТЬ ВСТРОЕННОГО ДАТЧИКА ТЕМПЕРАТУРЫ | 0.1°С |
| НАПРЯЖЕНИЕ ПИТАНИЯ | 12 В |
| НАПРЯЖЕНИЕ ЛИНИЙ ДАННЫХ | 0 .. 3.3 В |
| BIT ERROR RATE | 10<sup>-6</sup> |
| SNR<sup>[3](#footnote3)</sup> | -3 дБ |
| МАКСИМАЛЬНАЯ ОТНОСИТЕЛЬНАЯ СКОРОСТЬ | ± 2 м/с |
| ВРЕМЯ СТАРТА | 100 мсек |
| ДИАПАЗОН РАБОЧИХ ТЕМПЕРАТУР | -5 .. 50 °C |
| ЭНЕРГОПОТРЕБЛЕНИЕ (Rx/Tx) | 0.33 / 10 Вт |
| ИНТЕРФЕЙС СОПРЯЖЕНИЯ | UART 9600 бит/с |
| ПРОТОКОЛ СОПРЯЖЕНИЯ | NMEA 0183 [PAZM](Zima2_Protocol_Specification_ru.md) |
| ДЛИНА КАБЕЛЯ<sup>[4](#footnote4)</sup> | 0.5 м |
| МАКСИМАЛЬНОЕ ЧИСЛО АДРЕСОВ | 16 |

<!-- | ПОЛОСА ЧАСТОТ | 10 .. 30 кГц | -->
________________
- <a name="footnote1"><sup>1</sup></a> Параметр, определяющий максимальную дальность, на которой возможен прием сигнала, исходя из электроакустических параметров передатчика и приемника, пространственного убывания интенсивности звуковой энергии, затухания в среде и уровня гидроакустических помех.  
- <a name="footnote2"><sup>2</sup></a> Без учета веса блока батарей. Стандартный блок батарей [SB-24-48-LF](/documentation/RU/Accessories/Sub_batteries_ru#sb2448lf).  
- <a name="footnote3"><sup>3</sup></a> Значение получено без учета эффекта многолучевого распространения в лабораторном статическом эксперименте.  
- <a name="footnote4"><sup>4</sup></a> Значение может быть изменено по запросу.  
- <a name="footnote5"><sup>5</sup></a> Получено в лабораторных условиях в статическом эксперименте.  

## ДОПОЛНИТЕЛЬНО

В автономном исполнении устройство комплектуется батарейным блоком [SB-24-48-LF](/documentation/RU/Accessories/Sub_batteries_ru#sb2448lf) на основе LiFePO4 (Литий-железофосфатных) аккумуляторов, обеспечивающих более тысячи циклов заряд-разряд и работу при низких температурах окружающей среды. 

Подключение маяка-ответчика к батарейному блоку осуществляется через герметичный разъем, обеспечивающий дополнительно функцию автоматического включения устройства при погружении в воду.

Время работы маяка-ответчика от батарейного блока зависит от интенсивности обмена с пеленгационной антенной, которая в свою очередь зависит от дальности, количества маяков-ответчиков, которые опрашивает пеленгационная антенна и гидрологических условий.

### ВРЕМЯ АВТОНОМНОЙ РАБОТЫ 

| ПЕРИОД ОПРОСА, сек | ВРЕМЯ РАБОТЫ, ч | ПРИМЕЧАНИЕ |
| :---: | :---: | :--- |
| - | 70 | Без опроса, в режиме приема |
| 1 | 8 | Минимально возможный период опроса |
| 2 | 16 | |
| 4 | 32 | |
| 8 | 64 | |
| 16 | до 70 | |

### НАЗНАЧЕНИЕ ЖИЛ КАБЕЛЯ (В интегрируемом исполнении)

| ЦВЕТ ЖИЛЫ | ФУНКЦИЯ |
| :--- | :---: |
| 🟥 Красный | + U<sub>пит.</sub> |
| 🟩 Зеленый | Tx |
| ⬜ Белый/Прозрачный | Rx |
| 🟨 Желтый | SVC |
| Экран | - U<sub>пит.</sub> |
