ucnl/ucnl.github.io/documentation/RU/Zima/Zima2LX_Specification_ru.md

[Главная](/README_RU) ❯ [Гидроакустические навигационные и трекинговые системы](/navigation_and_tracking_systems_ru) ❯ **Zima2-LX — LBL-трансивер: Спецификация устройства**

<details>
  <summary><b>ℹ Рекомендации для печати/сохранения в PDF</b></summary>
  <br>
  <ol>
    <li>Нажмите <b>Ctrl+P</b> (macOS: <b>Cmd+P</b>)</li>
    <li>В настройках принтера выберите <b>«Сохранить как PDF»</b> (Microsoft Print to PDF)</li>
    <li>В поле <b>«Страницы»</b> укажите диапазон, исключая первую и последнюю страницу</li>
    <li>Отключите <b>верхние и нижние колонтитулы</b> (заголовки/URL/page numbers)</li>
    <li>В <b>Chrome/Edge</b>: в доп. настройках → «Поля» → <b>Нет</b> | в <b>Firefox</b>: «Поля и колонтитулы» → <b>Нет</b></li>
    <li>Нажмите <b>Печать</b> и укажите куда сохранить PDF</li>
  </ol>
</details>

|  | zima2_lx |
| :---: | ---: |
| [www.unavlab.com](https://www.unavlab.com/) <br/> [support@unavlab.com](mailto:support@unavlab.com) | **Zima2-LX** — LBL-трансивер навигационной системы **Zima2 LBL** <br/> спецификация устройства |

## КЛЮЧЕВЫЕ ОСОБЕННОСТИ

* **Предельно малые габариты и масса**
* **Дальность связи до 3000<sup>[1](#footnote1)</sup> метров**
* **Надёжная цифровая гидроакустическая связь, устойчивая к многолучевому распространению**
* **Низкое энергопотребление (Rx/Tx) 0.33/10 Вт**
* **Встроенный датчик давления/температуры**
* **Последовательный опрос произвольного набора маяков-ответчиков (до 16 шт.)**
* **Патентованная<sup>[*](#footnote_a1)</sup> моноблочная конструкция**

## ОПИСАНИЕ

**Zima2-LX** — трансивер длиннобазисной навигационной системы [Zima2 LBL](Zima2_LBL_DataBrief_ru.md).

Устройство предназначено для размещения на подводном объекте с целью измерения дальностей до маяков-ответчиков [Zima2-R](Zima2R_Specification_ru.md), положения которых известны. 

В отличие от [Zima2-L](Zima2L_Specification_ru.md), работающего с фиксированной навигационной базой из 3–4 маяков по схеме общего запроса и ограниченного размером базы 265 м, Zima2-LX обеспечивает последовательный опрос произвольного набора маяков (до 16 шт.) без ограничений на геометрию базы. Единственное ограничение — энергетическая дальность акустической связи (до 3000 м).
Позиция трансивера рассчитывается внешним устройством [Zima2-SL](Zima2SL_Specification_ru.md) на основе измеренных дальностей и известных координат маяков.

**Zima2-LX** и [Zima2-L](Zima2L_Specification_ru.md) используют **одну и ту же аппаратную платформу**.

________________
<a name="footnote_a1"><sup>*</sup></a> Патент RU2659299C1.

## ТЕХНИЧЕСКИЕ ХАРАКТЕРИСТИКИ

| ПАРАМЕТР | ЗНАЧЕНИЕ |
| :--- | :--- |
| ГАБАРИТЫ (Ф х h) | 64 x 62 мм |
| ВЕС (сухой) | 0.3 кг |
| МАКСИМАЛЬНАЯ ГЛУБИНА | 300 м |
| РАЗРЕШЕНИЕ ПО ГЛУБИНЕ | 0.1 м |
| МАКСИМАЛЬНАЯ ДАЛЬНОСТЬ АКУСТИЧЕСКОЙ СВЯЗИ<sup>[1](#footnote1)</sup> | 3000 м |
| РАЗВИВАЕМОЕ АКУСТИЧЕСКОЕ ДАВЛЕНИЕ | 170 дБ re 1 мкПа @ 1 м |
| НЕСУЩАЯ ЧАСТОТА | 20100 Гц |
| ТОЧНОСТЬ ВСТРОЕННОГО ДАТЧИКА ТЕМПЕРАТУРЫ | 0.1 °С |
| НАПРЯЖЕНИЕ ПИТАНИЯ | 12 В |
| НАПРЯЖЕНИЕ ЛИНИЙ ДАННЫХ | 0 .. 3.3 В |
| BIT ERROR RATE | 10<sup>-6</sup> |
| SNR<sup>[2](#footnote2)</sup> | -3 дБ |
| МАКСИМАЛЬНАЯ ОТНОСИТЕЛЬНАЯ СКОРОСТЬ | ± 2 м/с |
| ВРЕМЯ СТАРТА | 100 мсек |
| ДИАПАЗОН РАБОЧИХ ТЕМПЕРАТУР | -5 .. 50 °C |
| ЭНЕРГОПОТРЕБЛЕНИЕ (Rx/Tx) | 0.33 / 10 Вт |
| ИНТЕРФЕЙС СОПРЯЖЕНИЯ | UART 9600 бит/с |
| ПРОТОКОЛ СОПРЯЖЕНИЯ | NMEA 0183 [PAZM](Zima2_Protocol_Specification_ru.md) |
| МАКСИМАЛЬНОЕ ЧИСЛО МАЯКОВ В НАБОРЕ | до 16 |
| ДЛИНА КАБЕЛЯ<sup>[3](#footnote3)</sup> | 0.5 м |
| МАКСИМАЛЬНАЯ ЧАСТОТА ОБНОВЛЕНИЯ ДАЛЬНОСТЕЙ<sup>[4](#footnote4)</sup> | ОЖИДАЕТСЯ |
| НОМИНАЛЬНАЯ ТОЧНОСТЬ ИЗМЕРЕНИЯ ДАЛЬНОСТИ (СКО)<sup>[5](#footnote5)</sup> | ОЖИДАЕТСЯ |

________________
<a name="footnote1"><sup>1</sup></a> Параметр, определяющий максимальную дальность, на которой возможен приём сигнала, исходя из электроакустических параметров передатчика и приёмника, пространственного убывания интенсивности звуковой энергии, затухания в среде и уровня гидроакустических помех. Максимальная дальность связи не эквивалентна максимальной дальности работы навигационной системы.
<a name="footnote2"><sup>2</sup></a> Значение получено без учёта эффекта многолучевого распространения в лабораторном статическом эксперименте.
<a name="footnote3"><sup>3</sup></a> Значение может быть изменено по запросу.
<a name="footnote4"><sup>4</sup></a> Зависит от числа маяков в наборе и их адресов; при последовательном опросе частота обновления ниже, чем у [Zima2-L](Zima2L_Specification_ru.md).
<a name="footnote5"><sup>5</sup></a> ОЖИДАЕТСЯ.

### НАЗНАЧЕНИЕ ЖИЛ КАБЕЛЯ

| ЦВЕТ ЖИЛЫ | ФУНКЦИЯ |
| :--- | :---: |
| 🟥 Красный | + U<sub>пит.</sub> |
| 🟩 Зеленый | Tx |
| ⬜ Белый/Прозрачный | Rx |
| 🟨 Желтый | SVC |
| Экран | - U<sub>пит.</sub> |
