ucnl/ucnl.github.io/documentation/RU/uSwitch/uSwitch_Specification_ru.md

[Главная](/README_RU) ❯ [Наши проекты для образования](/educational_projects_ru) ❯ **uSwitch: Спецификация устройства: uSwitch**

<details>
  <summary><b>ℹ Рекомендации для печати/сохранения в PDF</b></summary>
  <br>
  <ol>
    <li>Нажмите <b>Ctrl+P</b> (macOS: <b>Cmd+P</b>)</li>
    <li>В настройках принтера выберите <b>«Сохранить как PDF»</b> (Microsoft Print to PDF)</li>
    <li>В поле <b>«Страницы»</b> укажите диапазон, исключая первую и последнюю страницу</li>
    <li>Отключите <b>верхние и нижние колонтитулы</b> (заголовки/URL/page numbers)</li>
    <li>В <b>Chrome/Edge</b>: в доп. настройках → «Поля» → <b>Нет</b> | в <b>Firefox</b>: «Поля и колонтитулы» → <b>Нет</b></li>
    <li>Нажмите <b>Печать</b> и укажите куда сохранить PDF</li>
  </ol>
</details>

|  |  |
| :---: | ---: |
| [www.unavlab.com](https://www.unavlab.com/) <br/> [support@unavlab.com](mailto:support@unavlab.com) | **uSwitch** - Гидроакустический модем <br/> Спецификация устройства |

## КЛЮЧЕВЫЕ ОСОБЕННОСТИ

* **Простое и доступное решение**
* **Дальность связи до 300<sup>[1](#footnote1)</sup> м**
* **Скорость передачи 32 bit/s**
* **Функция измерения времени распространения сигнала**
* **Функция включения при контакте с водой**
* **Может использоваться в качестве пингера системы [WAYU](documentation/navigation_and_tracking_systems_ru#wayu)**
* **Низкое энергопотребление (Rx/Tx) 30 мА / 2.5 А**
* **Идеальное решение для образовательных проектов и обучения**

## ОПИСАНИЕ

Гидроакустический модем **uSwitch** является простым и доступным решением для передачи данных через толщу воды на небольшие расстрояния.
Работа с устройством требует минимальных навыков, что позволяет использовать его как простой инструмент, сосредоточившись на задачах пользователя.
Например, для отработки различных сетевых алгоритмов, прототипирования и построения специализированных навигационных систем, систем телеуправления и т.д.

Устройство поставляется в виде сборки печатных плат и гидроакустической антенны на кабеле. 

В качестве антенны могут применятся:
- [RT-1.332820-1](https://docs.unavlab.com/documentation/RU/Transducers/RT_1_332820_1_Specification_ru.html) - доступное решение с минимальными габаритами
- [RT-2.332820-1](https://docs.unavlab.com/documentation/RU/Transducers/RT_2_332820_1_Specification_ru.html) - двухэлементная антенна с повышенной чувствительностью для работы с поверхности
- [RT-1.524525-1](https://docs.unavlab.com/documentation/RU/Transducers/RT-1.524525-1_specification_ru.html) - антенна с повышенной чувствительностью

## ТЕХНИЧЕСКИЕ ХАРАКТЕРИСТИКИ

| ПАРАМЕТР | ЗНАЧЕНИЕ |
| :--- | :--- |
| ГАБАРИТЫ | 100 x 19 х 25  мм |
| ВЕС | 0.03 кг |
| МАКСИМАЛЬНАЯ ДАЛЬНОСТЬ АКУСТИЧЕСКОЙ СВЯЗИ<sup>[1](#footnote1)</sup> | 300 м |
| СКОРОСТЬ ПЕРЕДАЧИ ДАННЫХ | 32 бит/с |
| ЭНЕРГОПОТРЕБЛЕНИЕ Rx/Tx | 20 мА / 2.5 А |
| НАПРЯЖЕНИЕ ПИТАНИЯ<sup>[2](#footnote2)</sup> | 7 .. 13 В |
| НАПРЯЖЕНИЕ ЛИНИЙ ДАННЫХ | 0 .. 3.3 В |
| ЧАСТОТНЫЙ ДИАПАЗОН | 24000 .. 26000 Гц |
| МАКСИМАЛЬНОЕ АКУСТИЧЕСКОЕ ДАВЛЕНИЕ<sup>[3](#footnote3)</sup> (В полосе) | 165 дБ re 1 мкПа @ 1 м |
| МАКСИМАЛЬНАЯ ОТНОСИТЕЛЬНАЯ СКОРОСТЬ | +/- 2 м/с |
| ДИАПАЗОН РАБОЧИХ ТЕМПЕРАТУР | -5 .. 50 °C |
| ИНТЕРФЕЙС СОПРЯЖЕНИЯ | UART 9600 бит/с |

________________
<a name="footnote1"><sup>1</sup></a> Параметр, определяющий максимальную дальность, на которой возможен прием сигнала, исходя из электроакустических параметров передатчика и приемника, пространственного убывания интенсивности звуковой энергии, затухания в среде и уровня гидроакустических помех.  
<a name="footnote2"><sup>2</sup></a> Максимальная выходная мощность достигается при питании модема напряжением 12 В.  
<a name="footnote3"><sup>3</sup></a> При использовании антенны [RT-1.332820-1](https://docs.unavlab.com/documentation/RU/Transducers/RT_1_332820_1_Specification_ru.html).  

## РАСПИНОВКА И ПОДКЛЮЧЕНИЕ

|  |
| :---: |
| Модем **uSwitch** <br/> *расположение и функции контактных площадок* |

| ОБОЗНАЧЕНИЕ | НАИМЕНОВАНИЕ | I/O | АКТИВНОЕ СОСТОЯНИЕ | ФУНКЦИЯ |
| :--- | :--- | :---: | :---: |:--- |
| 1 | GND | - | - | Земля/Общий |
| 2 | STR_TRX | O | 1 | Строб при начале передачи/приема, не менее 10 мс |
| 3 | GND | - | - | Земля/Общий |
| 4 | TX_OVF | O | 0 | Если буфер передачи полон, выставляется 0 |
| 5 | GND | - | - | Земля/Общий |
| 6 | TX | O | - | Tx приемника |
| 7 | GND | - | - | Земля/Общий |
| 8 | RX | I | - | Rx передатчика |
| 9 | +U<sub>пит.</sub> | I | - | Питание |
| 10 | +U<sub>пит.</sub> | I | - | Питание |
| X1 | ANT | - | - | Подключение гидроакустической антенны |
| X2 | WATER_DET | - | - | Контакты детектора воды |

## ДОПОЛНИТЕЛЬНАЯ ИНФОРМАЦИЯ

Устройство позволяет переключать максимальную мощность передающего тракта для работы на максимальой дальности и для работы в малых водоемах, например в бассейнах.

Переключение режимов осуществляется запайкой соответствующей перемычки (резистор 0 Ом типоразмера 1206).

- для работы на максимальной дальности:
  - R1 не запаян, R2 запаян
  
- для работы в бассейнах:
  - R1 запаян, R2 не запаян

> ВАЖНО! Запайка одновременно обоих перемычек R1 и R2 приведет к выходу устройств из строя и негарантийной поломке
