ucnl/ucnl.github.io/documentation/RU/uWAVE/uWAVE_Specification_ru.md

[Главная](/README_RU) ❯ [Гидроакустические модемы](/underwater_acoustic_modems_ru) ❯ **Спецификация устройства: uWave**

<details>
  <summary><b>ℹ Рекомендации для печати/сохранения в PDF</b></summary>
  <br>
  <ol>
    <li>Нажмите <b>Ctrl+P</b> (macOS: <b>Cmd+P</b>)</li>
    <li>В настройках принтера выберите <b>«Сохранить как PDF»</b> (Microsoft Print to PDF)</li>
    <li>В поле <b>«Страницы»</b> укажите диапазон, исключая первую и последнюю страницу</li>
    <li>Отключите <b>верхние и нижние колонтитулы</b> (заголовки/URL/page numbers)</li>
    <li>В <b>Chrome/Edge</b>: в доп. настройках → «Поля» → <b>Нет</b> | в <b>Firefox</b>: «Поля и колонтитулы» → <b>Нет</b></li>
    <li>Нажмите <b>Печать</b> и укажите куда сохранить PDF</li>
  </ol>
</details>

|  |  |
| :---: | ---: |
| [www.unavlab.com](https://www.unavlab.com/) <br/> [support@unavlab.com](mailto:support@unavlab.com) | **uWave** - Гидроакустический модем <br/> Спецификация устройства |

## КЛЮЧЕВЫЕ ОСОБЕННОСТИ

* **Предельно малые габариты и масса**
* **Может применятся в беспроводных подводных сетях сенсоров**
* **Дальность связи до 1000<sup>[1](#footnote1),[*](#footnote_a1)</sup> м**
* **Надежная передача данных со скоростью до 634<sup>[2](#footnote2)</sup> bit/s**
* **Кодовое разделение абонентов**
* **Измерение времени распространения сигнала**
* **Высоконадежная цифровая гидроакустическая связь**
* **Низкое энергопотребление (Rx/Tx) 0.33/6 Вт**
* **Открытый протокол сопряжения**
* **Встроенный датчик давления/температуры**
* **Пакетный режим с гарантированной доставкой (ALO - At-least-once)**
* **Патентованная<sup>[**](#footnote_a2)</sup> моноблочная конструкция**

## ОПИСАНИЕ

**uWave** - самый маленький в мире<sup>[***](#footnote_a3)</sup> гидроакустический модем. Устройство позволяет обеспечивать гидроакустическую 
цифровую связь между 254 абонентами в акваториях 1000 х 1000 метров, используя кодовый режим, режим прозрачного канала или пакетный режим с логической адресацией и гарантированной доставкой. 
Предельно малый размер, низкое энергопотребление и простота использования делают модемы [семейства uWave](uWAVE_Family_ru.md) идельным решением для управления автономными подводными устройствами и передачи данных в приложениях, чувствительных к габаритам и массе.

Устройство позволяет:
* передавать данные в режиме прозрачного канала - достаточно просто подключить модем к последовательному порту
* запрашивать глубину, температуру, напряжение питания удаленных модемов [семейства uWave](uWAVE_Family_ru.md) с одновременным измерением времени распространения сигнала (а следовательно и дальности до них)
* передавать данные в пакетном режиме с гарантированной доставкой (ALO - At-least-once) и уведомлением о доставке
* измерять локальную глубину погружения, температуру воды и напряжение питания.

Устройства [семейства uWave](uWAVE_Family_ru.md) используют простой [NMEA-подобный протокол](uWAVE_Protocol_Specification_ru.md) настройки, а поставляемые open-source библиотеки [**uWaveLib**](https://github.com/ucnl/uWAVELib) (.NET) и [**uWave ALibs**](https://github.com/ucnl/UCNL_ALibs) (Arduino) позволяют сделать интеграцию модемов в пользовательские решения максимально просто и быстро.

_________
<a name="footnote_a1"><sup>\*</sup></a> По результатам испытаний в мелководном водоеме, при помощи устройств **uWave** была получена практическая дальность связи **1092 м**.  
<a name="footnote_a2"><sup>\*\*</sup></a> *Патент RU2659299C1*.  
<a name="footnote_a3"><sup>\*\*\*</sup></a> *Согласно открытым источникам на ноябрь 2024*.  

## ТЕХНИЧЕСКИЕ ХАРАКТЕРИСТИКИ

| ПАРАМЕТР | ЗНАЧЕНИЕ |
| :--- | :--- |
| ГАБАРИТЫ (Ф х h) | 41 x 45 мм |
| ВЕС (сухой) | 0.16 кг |
| МАКСИМАЛЬНАЯ ГЛУБИНА | 300 м |
| МАКСИМАЛЬНАЯ ДАЛЬНОСТЬ АКУСТИЧЕСКОЙ СВЯЗИ<sup>[1](#footnote1)</sup> | 1000 м |
| СКОРОСТЬ ПЕРЕДАЧИ ДАННЫХ<sup>[2](#footnote2)</sup> | 78/156/314/634 бит/с |
| ЭНЕРГОПОТРЕБЛЕНИЕ Rx/Tx | 0.33/6 Вт |
| НАПРЯЖЕНИЕ ПИТАНИЯ<sup>[3](#footnote3),[4](#footnote4)</sup> | 5 .. 12 В |
| НАПРЯЖЕНИЕ ЛИНИЙ ДАННЫХ | 0 .. 3.3 В |
| ВЫХОДНОЕ СОПРОТИВЛЕНИЕ ЛИНИЙ ДАННЫХ | 1 кОм |
| НЕСУЩАЯ | 20050 Гц |
| МАКСИМАЛЬНОЕ АКУСТИЧЕСКОЕ ДАВЛЕНИЕ (В полосе) | 169 дБ re 1 мкПа @ 1 м |
| BIT ERROR RATE | 10<sup>-6</sup> |
| SNR<sup>[5](#footnote5)</sup> | -2 дБ |
| МАКСИМАЛЬНАЯ ОТНОСИТЕЛЬНАЯ СКОРОСТЬ | +/- 1 м/с |
| ВРЕМЯ СТАРТА | 100 мсек |
| ДИАПАЗОН РАБОЧИХ ТЕМПЕРАТУР | -5 .. 50 °C |
| ИНТЕРФЕЙС СОПРЯЖЕНИЯ<sup>[6](#footnote6)</sup> | UART 9600 бит/с |
| ПРОТОКОЛ СОПРЯЖЕНИЯ | NMEA 0183 [PUWV](uWAVE_Protocol_Specification_ru.md) |
| ДЛИНА КАБЕЛЯ<sup>[6](#footnote6)</sup> | 0.5 м |
| ДИАМЕТР КАБЕЛЯ | 5 мм |
| СХЕМА РАЗДЕЛЕНИЯ АБОНЕНТОВ<sup>[2](#footnote2)</sup> | 20 кодовых каналов |
| РАЗМЕР БУФЕРА ПЕРЕДАТЧИКА | 127 байт |
| КОМАНДНЫЙ РЕЖИМ| 16 предустановленных сообщений (9 для пользовательских приложений) |
| РАЗРЕШЕНИЕ ПРИ ИЗМЕРЕНИИ ВРЕМЕНИ РАСПРОСТРАНЕНИЯ СИГНАЛА<sup>[7](#footnote7)</sup> | 0.0001 c |
| ПАКЕТНЫЙ РЕЖИМ | 254 адреса с уведомлением о получении, широковещательные сообщения, размер пакета до 64 байт |
| РАЗРЕШЕНИЕ ДАТЧИКА ГЛУБИНЫ (локально)<sup>[8](#footnote8)</sup> | 0.01 м |
| РАЗРЕШЕНИЕ ДАТЧИКА ГЛУБИНЫ (удаленно)<sup>[8](#footnote8)</sup> | 0.1 м |
  
________________
<a name="footnote1"><sup>1</sup></a> Параметр, определяющий максимальную дальность, на которой возможен прием сигнала, исходя из электроакустических параметров передатчика и приемника, пространственного убывания интенсивности звуковой энергии, затухания в среде и уровня гидроакустических помех. В скоростном режиме 78 бит/с.  
<a name="footnote2"><sup>2</sup></a> По умолчанию устройства работают в режиме со скоростью передачи **78 бит/с**, в котором обеспечивается максимальная дальность, надежность связи и максимальное число кодовых каналов. Разные скоростные режимы не совместимы между собой. Перевод модема в другой скоростной режим обеспечивается [заменой его встроенного ПО](uWAVE_FW_Updating_ru.md).  
<a name="footnote3"><sup>3</sup></a> Максимальная выходная мощность достигается при питании модема напряжением 12 В.  
<a name="footnote4"><sup>4</sup></a> Устройство имеет встроенную защиту от перенапряжения усилительной цепи. При напряжениях выше 12.8-13 вольт устройство не включает усилитель мощности, т.е.не допускает передачу данных.  
<a name="footnote5"><sup>5</sup></a> Значение получено без учета эффекта многолучевого распространения в лабораторном статическом эксперименте.  
<a name="footnote6"><sup>6</sup></a> Значение может быть изменено по запросу.  
<a name="footnote7"><sup>7</sup></a> С учетом данного значения разрешающая способность при измерении расстояния с учетом скорости звука 1500 м/с составляет 0.15 м.  
<a name="footnote8"><sup>8</sup></a> Оборудованный датчиком глубины модем может передавать показания глубины *локально* - через кабель, к управляющей системе, и *удаленно* - по запросу от другого модема.
