ucnl/ucnl.github.io/documentation/RU/Zima/Zima_Protocol_Specification_ru.md

[Главная](/README_RU) ❯ [Гидроакустические навигационные и трекинговые системы](/navigation_and_tracking_systems_ru) ❯ **Протокол информационного сопряжения: Zima USBL**

<details>
  <summary><b>ℹ Рекомендации для печати/сохранения в PDF</b></summary>
  <br>
  <ol>
    <li>Нажмите <b>Ctrl+P</b> (macOS: <b>Cmd+P</b>)</li>
    <li>В настройках принтера выберите <b>«Сохранить как PDF»</b> (Microsoft Print to PDF)</li>
    <li>В поле <b>«Страницы»</b> укажите диапазон, исключая первую и последнюю страницу</li>
    <li>Отключите <b>верхние и нижние колонтитулы</b> (заголовки/URL/page numbers)</li>
    <li>В <b>Chrome/Edge</b>: в доп. настройках → «Поля» → <b>Нет</b> | в <b>Firefox</b>: «Поля и колонтитулы» → <b>Нет</b></li>
    <li>Нажмите <b>Печать</b> и укажите куда сохранить PDF</li>
  </ol>
</details>

|  |  |
| :---: | ---: |
| [www.unavlab.com](https://www.unavlab.com/) <br/> [support@unavlab.com](mailto:support@unavlab.com) | **Zima USBL** - гидроакустическая навигационная система <br/> Протокол информационного сопряжения |

# Zima USBL <br/> Протокол информационного сопряжения

## Содержание
- [1. Введение](#1-%D0%B2%D0%B2%D0%B5%D0%B4%D0%B5%D0%BD%D0%B8%D0%B5)  
  - [1.1. Протокол физического уровня](#11-%D0%BF%D1%80%D0%BE%D1%82%D0%BE%D0%BA%D0%BE%D0%BB-%D1%84%D0%B8%D0%B7%D0%B8%D1%87%D0%B5%D1%81%D0%BA%D0%BE%D0%B3%D0%BE-%D1%83%D1%80%D0%BE%D0%B2%D0%B5%D0%BD%D1%8F)
  - [1.2. Стандарт протокола диалогового уровня NMEA0183](#12-%D1%81%D1%82%D0%B0%D0%BD%D0%B4%D0%B0%D1%80%D1%82-%D0%BF%D1%80%D0%BE%D1%82%D0%BE%D0%BA%D0%BE%D0%BB%D0%B0-%D0%B4%D0%B8%D0%B0%D0%BB%D0%BE%D0%B3%D0%BE%D0%B2%D0%BE%D0%B3%D0%BE-%D1%83%D1%80%D0%BE%D0%B2%D0%BD%D1%8F-nmea0183)
- [2. Система команд ZMA](#2-%D1%81%D0%B8%D1%81%D1%82%D0%B5%D0%BC%D0%B0-%D0%BA%D0%BE%D0%BC%D0%B0%D0%BD%D0%B4-zma)  
   - [2.1. IC_D2H_ACK - реакция устройства](#21-ic_d2h_ack)
   - [2.2. IC_H2D_FLD_GET - запрос значения поля](#22-ic_h2d_fld_get)
   - [2.3. IC_H2D_FLD_SET - задать значение поля](#23-ic_h2d_fld_set)
   - [2.4. IC_D2H_FLD_VAL - значение поля](#24-ic_d2h_fld_val)
   - [2.5. IC_H2D_LOC_DATA_GET - запрос локального параметра](#25-ic_h2d_loc_data_get)
   - [2.6. IC_H2D_LOC_DATA_SET - задать значение локального параметра](#26-ic_h2d_loc_data_set)
   - [2.7. IC_D2H_LOC_DATA_VAL - значение локального параметра](#27-ic_d2h_loc_data_val)
   - [2.8. IC_H2D_LOC_INVOKE - сервисная функция](#28-ic_h2d_loc_invoke)
   - [2.9. IC_D2H_LD - навигационные данные](#29-ic_d2h_ld)
   - [2.10. IC_D2H_BASE_REQ - принят запрос базовой станции](#210-ic_d2h_base_req)
   - [2.11. IC_H2D_REM_REQ - запрос удаленного ответчика](#211-ic_h2d_rem_req)
   - [2.12. IC_D2H_REM_TOUT - таймаут удаленного ответчика](#212-ic_d2h_rem_tout)
   - [2.13. IC_D2H_REM_RESP - ответ удаленного ответчика](#213-ic_d2h_rem_resp)
   - [2.14. IC_D2H_SYS_STATE - состояние системы](#214-ic_d2h_sys_state)
   - [2.15. IC_D2H_INC_DATA - показания встроенного инклинометра](#215-ic_d2h_inc_data)
   - [2.16. IC_H2D_REM_REQ_EX - запрос удаленного ответчика](#216-ic_h2d_rem_req_ex)
   - [2.17. IC_D2H_DEV_INFO - информация об устройстве](#217-ic_d2h_dev_info)
   - [2.18. IC_D2H_BASE_REQ - принят запрос базовой станции](#210-ic_d2h_base_req)   
- [3. Таблицы идентификаторов](#3-%D1%82%D0%B0%D0%B1%D0%BB%D0%B8%D1%86%D1%8B-%D0%B8%D0%B4%D0%B5%D0%BD%D1%82%D0%B8%D1%84%D0%B8%D0%BA%D0%B0%D1%82%D0%BE%D1%80%D0%BE%D0%B2)
   - [3.1. Типы устройств](#31-%D1%82%D0%B8%D0%BF%D1%8B-%D1%83%D1%81%D1%82%D1%80%D0%BE%D0%B9%D1%81%D1%82%D0%B2)
   - [3.2. Коды ошибок](#32-%D0%BA%D0%BE%D0%B4%D1%8B-%D0%BE%D1%88%D0%B8%D0%B1%D0%BE%D0%BA)
   - [3.3. Идентификаторы локальных данных](#33-%D0%B8%D0%B4%D0%B5%D0%BD%D1%82%D0%B8%D1%84%D0%B8%D0%BA%D0%B0%D1%82%D0%BE%D1%80%D1%8B-%D0%BB%D0%BE%D0%BA%D0%B0%D0%BB%D1%8C%D0%BD%D1%8B%D1%85-%D0%B4%D0%B0%D0%BD%D0%BD%D1%8B%D1%85)
   - [3.4. Идентификаторы операций](#34-%D0%B8%D0%B4%D0%B5%D0%BD%D1%82%D0%B8%D1%84%D0%B8%D0%BA%D0%B0%D1%82%D0%BE%D1%80%D1%8B-%D0%BE%D0%BF%D0%B5%D1%80%D0%B0%D1%86%D0%B8%D0%B9)
   - [3.5. Идентификаторы удаленных команд](#35-%D0%B8%D0%B4%D0%B5%D0%BD%D1%82%D0%B8%D1%84%D0%B8%D0%BA%D0%B0%D1%82%D0%BE%D1%80%D1%8B-%D1%83%D0%B4%D0%B0%D0%BB%D0%B5%D0%BD%D0%BD%D1%8B%D1%85-%D0%BA%D0%BE%D0%BC%D0%B0%D0%BD%D0%B4)

## 1. Введение
### 1.1. Протокол физического уровеня

Устройства системы [Zima USBL](Zima_DataBrief_ru.md) поддерживают информационное сопряжение при помощи стандарта физического уровня RS-232 
для асинхронного интерфейса (UART) c напряжением линии данных 3.3В. Подключение производится при помощи четырехпроводного кабеля, с жилами Tx
(трансмиттер), Rx (ресивер), Vcc (питание) и GND (земля). Без применения дополнительных повторителей и преобразователей интерфейса 
максимальная длинна шины данных, для которой гарантируется корректная работа интерфейса, составляет не более 2 метров.

Настройки порта подключения по умолчанию<sup>[1](#footnote1)</sup>:  
> _Baudrate: 9600 bit/s_  
> _Data bits: 8_  
> _Stop bits: 1_  
> _Parity: No_  
> _Hardware flow control: No_  

>**ВНИМАНИЕ!**
>_У устройств без преобразователей интерфейса напряжение линии данных составляет 3.3 В._

### 1.2. Стандарт протокола диалогового уровня NMEA0183
Стандарт NMEA0183 описывает формат текстовых (ASCII) сообщений диалогового уровня.  

Пример сообщения:  **`$PZMA0,0*hh<СR><LF>`**  

Основные элементы посылки (сообщения, sentence) NMEА0183:
* '$' - начало сообщения,
* 'P' - Proprietary, проприетарный код
* 'ZMA' - трехбуквенный идентификатор производителя
* '0' - идентификатор сообщения
* ',' - запятая (разделитель параметров)  
* '*' - разделитель контрольной суммы
* 'hh' - контрольная сумма в шестнадцатеричном формате (например FF, 01). Рассчитывается как побитовый XOR всех байт между '$' и '*'.
* \<CR\>\<LF\> - конец сообщения (перевод строки)
________
<a name="footnote1"><sup>1</sup> Указанные параметры могут быть изменены по запросу</a>

## 2. Система команд ZMA
Префикс **D2H** в наименовании сообщений означает, что оно передается от устройства (Device) к управляющей системе (Host).
Префикс **H2D** в наименовании сообщений означает, что оно передается от управляющей системы (Host) к устройству (Device).

### 2.1. IC_D2H_ACK
Сообщение IC_D2H_ACK - реакция устройства на поступивший от управляющей системы запрос.  

Формат сообщения: **`$PZMA0,xx*hh<CR><LF>`**

| Поле/параметр | Описание |
| :--- | :--- |
| $	| начало сообщения '$' |
| PZMA | система команд ZMA |
| 0	| идентификатор сообщения |
| Error code | Код ошибки \([см. 3.2.](#32-%D0%BA%D0%BE%D0%B4%D1%8B-%D0%BE%D1%88%D0%B8%D0%B1%D0%BE%D0%BA)\) |
| *	| разделитель контр. суммы NMEA |
| hh | контрольная сумма NMEA |
| \<CR\>\<LF\> | конец сообщения |

### 2.2. IC_H2D_FLD_GET
Прочитать значение поля. В ответ на эту команду устройство отсылает сообщение [IC_D2H_FLD_VAL](#24-ic_d2h_fld_val), содержащее значение запрашиваемого поля 
в случае успешного присваивания и сообщения [IC_D2H_ACK](#21-ic_d2h_ack) с кодом ошибки, в случае возникновения ошибки.  

Формат сообщения: **`$PZMA1,xx,00*hh <CR><LF>`**

| Поле/параметр | Описание |
| :--- | :--- |
| $	| начало сообщения '$' |
| PZMA | система команд ZMA |
| 1 | Идентификатор сообщения |
| Field ID | Идентификатор поля |
| Reserved | Должно быть всегда '00', зарезервированно |
| *	| разделитель контр. суммы NMEA |
| hh | контрольная сумма NMEA |
| \<CR\>\<LF\> | конец сообщения |

### 2.3 IC_H2D_FLD_SET
Задать значение поля. В ответ на эту команду устройство отсылает сообщение [IC_D2H_FLD_VAL](#24-ic_d2h_fld_val), содержащее значение запрашиваемого поля в 
случае успешного присваивания и сообщения [IC_D2H_ACK](#21-ic_d2h_ack) с кодом ошибки, в случае возникновения ошибки.  

Формат сообщения: **`$PZMA2,x,x*hh<CR><LF>`**

| Поле/параметр | Описание |
| :--- | :--- |
| $	| начало сообщения '$' |
| PZMA | система команд ZMA |
| 2 | Идентификатор сообщения |
| Field ID | Идентификатор поля |
| Field value | Значение поля (0..99) |
| *	| разделитель контр. суммы NMEA |
| hh | контрольная сумма NMEA |
| \<CR\>\<LF\> | конец сообщения |

### 2.4 IC_D2H_FLD_VAL
Значение настроечного поля.  

Формат сообщения: **`$PZMA3,xx,xx,00*hh<CR><LF>`**

| Поле/параметр | Описание |
| :--- | :--- |
| $	| начало сообщения '$' |
| PZMA | система команд ZMA |
| 3 | Идентификатор сообщения |
| Requested field ID | Идентификатор поля |
| Value | Значение поля |
| *	| разделитель контр. суммы NMEA |
| hh | контрольная сумма NMEA |
| \<CR\>\<LF\> | конец сообщения |

### 2.5 IC_H2D_LOC_DATA_GET
Прочитать значение локального параметра.  

Формат сообщения: **`$PZMA4,xx,00*hh<CR><LF`**

| Поле/параметр | Описание |
| :--- | :--- |
| $	| начало сообщения '$' |
| PZMA | система команд ZMA |
| 4	| Идентификатор сообщения |
| LocDataID	| Идентификатор параметра \([см. 3.3.](#33-%D0%B8%D0%B4%D0%B5%D0%BD%D1%82%D0%B8%D1%84%D0%B8%D0%BA%D0%B0%D1%82%D0%BE%D1%80%D1%8B-%D0%BB%D0%BE%D0%BA%D0%B0%D0%BB%D1%8C%D0%BD%D1%8B%D1%85-%D0%B4%D0%B0%D0%BD%D0%BD%D1%8B%D1%85)\) |
| Reserved	| Зарезервировано - '00' |
| *	| разделитель контр. суммы NMEA |
| hh | контрольная сумма NMEA |
| \<CR\>\<LF\> | конец сообщения |

### 2.6 IC_H2D_LOC_DATA_SET
Задать значение локального параметра.  

Формат сообщения: **`$PZMA5,xx,x.x*hh<CR><LF>`**

| Поле/параметр | Описание |
| :--- | :--- |
| $	| начало сообщения '$' |
| PZMA | система команд ZMA |
| 5	| Идентификатор сообщения |
| LocDataID	| Идентификатор параметра \([см. 3.3.](#33-%D0%B8%D0%B4%D0%B5%D0%BD%D1%82%D0%B8%D1%84%D0%B8%D0%BA%D0%B0%D1%82%D0%BE%D1%80%D1%8B-%D0%BB%D0%BE%D0%BA%D0%B0%D0%BB%D1%8C%D0%BD%D1%8B%D1%85-%D0%B4%D0%B0%D0%BD%D0%BD%D1%8B%D1%85)\) |
| LocDataValue	| Значение параметра |
| *	| разделитель контр. суммы NMEA |
| hh | контрольная сумма NMEA |
| \<CR\>\<LF\> | конец сообщения |

### 2.7 IC_D2H_LOC_DATA_VAL
Значение локального параметра.  

Формат сообщения: **`$PZMA6,xx,x.x*hh <CR><LF>`**

| Поле/параметр | Описание |
| :--- | :--- |
| $	| начало сообщения '$' |
| PZMA | система команд ZMA |
| 6 | Идентификатор сообщения |
| LocDataID | Идентификатор параметра \([см. 3.3.](#33-%D0%B8%D0%B4%D0%B5%D0%BD%D1%82%D0%B8%D1%84%D0%B8%D0%BA%D0%B0%D1%82%D0%BE%D1%80%D1%8B-%D0%BB%D0%BE%D0%BA%D0%B0%D0%BB%D1%8C%D0%BD%D1%8B%D1%85-%D0%B4%D0%B0%D0%BD%D0%BD%D1%8B%D1%85)\) |
| LocDataValue | Значение параметра |
| *	| разделитель контр. суммы NMEA |
| hh | контрольная сумма NMEA |
| \<CR\>\<LF\> | конец сообщения |

### 2.8 IC_H2D_LOC_INVOKE
Выполнить операцию.  

Формат сообщения: **`$PZMA7,xx,xx*hh <CR><LF>`**

| Поле/параметр | Описание |
| :--- | :--- |
| $	| начало сообщения '$' |
| PZMA | система команд ZMA |
| 7 | Идентификатор сообщения |
| ActionID | Идентификатор операции \([см. 3.4.](#34-%D0%B8%D0%B4%D0%B5%D0%BD%D1%82%D0%B8%D1%84%D0%B8%D0%BA%D0%B0%D1%82%D0%BE%D1%80%D1%8B-%D0%BE%D0%BF%D0%B5%D1%80%D0%B0%D1%86%D0%B8%D0%B9)\) |
| ActionParam | Параметр |
| *	| разделитель контр. суммы NMEA |
| hh | контрольная сумма NMEA |
| \<CR\>\<LF\> | конец сообщения |

### 2.9 IC_D2H_LD
Навигационные данные (ответчик).  

Формат сообщения: **`$PZMAA,x.x,x.x,x.x,x.x*hh <CR><LF>`**

| Поле/параметр | Описание |
| :--- | :--- |
| $	| начало сообщения '$' |
| PZMA | система команд ZMA |
| A	| Идентификатор сообщения |
| Azimuth	| Азимут на базовую станцию, град. |
| Distance	| Дистанция до базовой станции, м |
| SNR	| Соотношение сигнал-шум, дБ |
| Dpl	| Допплеровское смещение частоты, Гц |
| *	| разделитель контр. суммы NMEA |
| hh | контрольная сумма NMEA |
| \<CR\>\<LF\> | конец сообщения |

### 2.10 IC_D2H_BASE_REQ
Запрос базовой станции (ответчик).  

Формат сообщения: **`$PZMAB,x,x.x,x.x*hh <CR><LF>`**

| Поле/параметр | Описание |
| :--- | :--- |
| $	| начало сообщения '$' |
| PZMA | система команд ZMA |
| B | Идентификатор сообщения |
| CommandID | Идентификатор команды  \([см. 3.5.](#35-%D0%B8%D0%B4%D0%B5%D0%BD%D1%82%D0%B8%D1%84%D0%B8%D0%BA%D0%B0%D1%82%D0%BE%D1%80%D1%8B-%D1%83%D0%B4%D0%B0%D0%BB%D0%B5%D0%BD%D0%BD%D1%8B%D1%85-%D0%BA%D0%BE%D0%BC%D0%B0%D0%BD%D0%B4)\) |
| SNR | Соотношение сигнал-шум, дБ |
| Dpl | Допплеровское смещение частоты, Гц |
| *	| разделитель контр. суммы NMEA |
| hh | контрольная сумма NMEA |
| \<CR\>\<LF\> | конец сообщения |

### 2.11 IC_H2D_REM_REQ
Запрос удаленного ответчика

Формат сообщения: **`$PZMAС,x,x*hh <CR><LF>`**

| Поле/параметр | Описание |
| :--- | :--- |
| $	| начало сообщения '$' |
| PZMA | система команд ZMA |
| C | Идентификатор сообщения |
| TargetID | Адрес запрашиваемого ответчика |
| RequestID | Идентификатор запроса \([см. 3.5.](#35-%D0%B8%D0%B4%D0%B5%D0%BD%D1%82%D0%B8%D1%84%D0%B8%D0%BA%D0%B0%D1%82%D0%BE%D1%80%D1%8B-%D1%83%D0%B4%D0%B0%D0%BB%D0%B5%D0%BD%D0%BD%D1%8B%D1%85-%D0%BA%D0%BE%D0%BC%D0%B0%D0%BD%D0%B4)\) |
| *	| разделитель контр. суммы NMEA |
| hh | контрольная сумма NMEA |
| \<CR\>\<LF\> | конец сообщения |

### 2.12 IC_D2H_REM_TOUT
Таймаут удаленного ответчика.  

Формат сообщения: **`$PZMAD,x, x*hh <CR><LF>`**

| Поле/параметр | Описание |
| :--- | :--- |
| $	| начало сообщения '$' |
| PZMA | система команд ZMA |
| D | Идентификатор сообщения |
| TargetID | Адрес запрошенного ответчика |
| RequestID | Идентификатор запроса \([см. 3.5.](#35-%D0%B8%D0%B4%D0%B5%D0%BD%D1%82%D0%B8%D1%84%D0%B8%D0%BA%D0%B0%D1%82%D0%BE%D1%80%D1%8B-%D1%83%D0%B4%D0%B0%D0%BB%D0%B5%D0%BD%D0%BD%D1%8B%D1%85-%D0%BA%D0%BE%D0%BC%D0%B0%D0%BD%D0%B4)\) |
| *	| разделитель контр. суммы NMEA |
| hh | контрольная сумма NMEA |
| \<CR\>\<LF\> | конец сообщения |
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
