ucnl/ucnl.github.io/documentation/batpack1.png

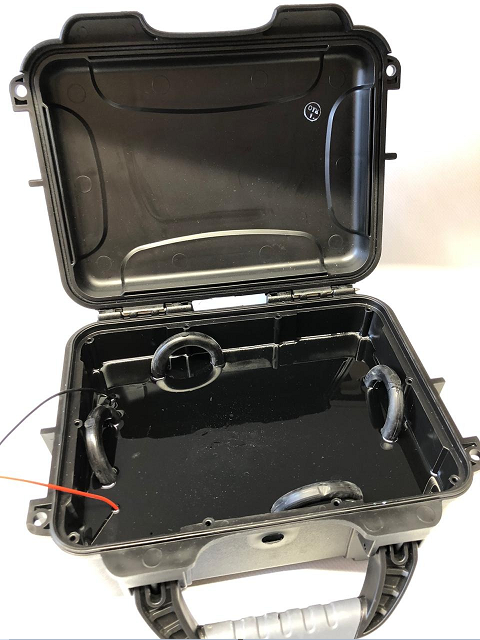
documentation/batpack1.png
