ucnl/ucnl.github.io/documentation/batpack2.png

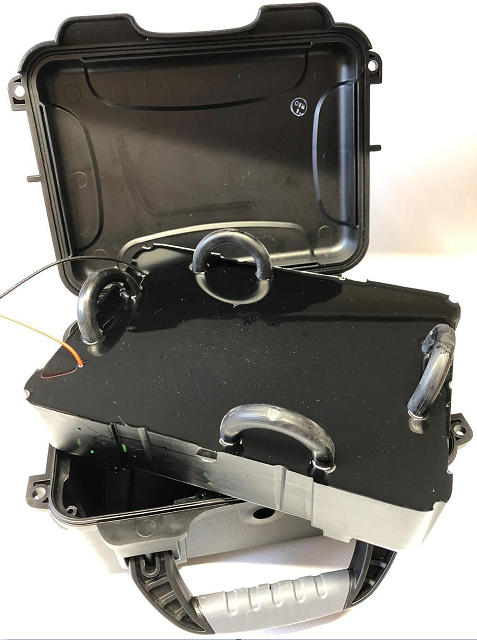
documentation/batpack2.png
