ucnl/ucnl.github.io/documentation/crm_300_os.png

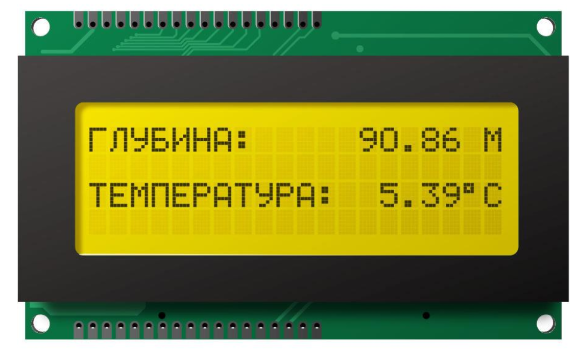
documentation/crm_300_os.png
