ucnl/ucnl.github.io/documentation/crm_300_os_drawings.png

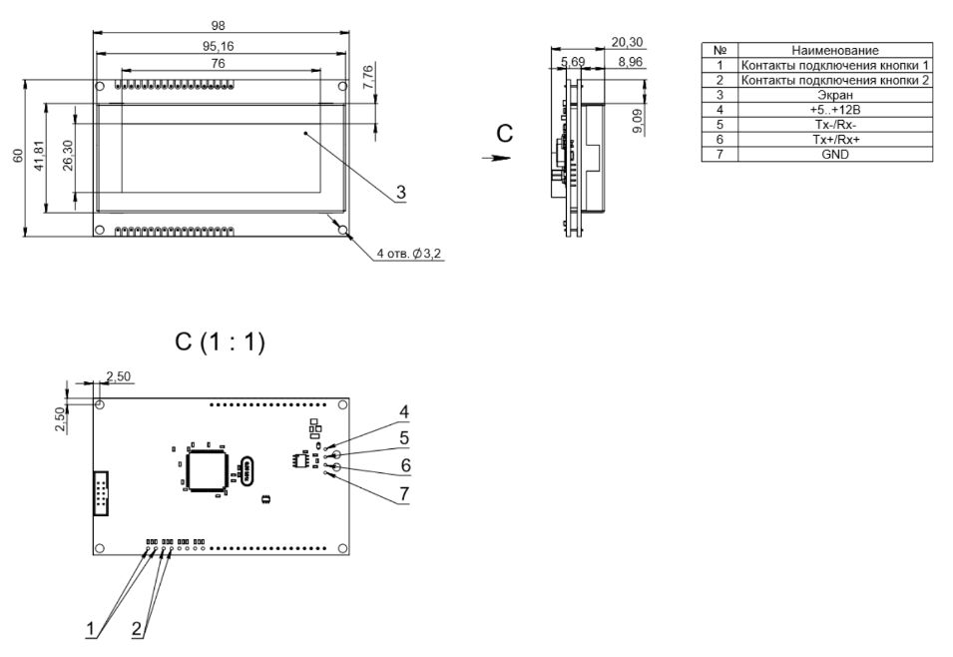
documentation/crm_300_os_drawings.png
