ucnl/ucnl.github.io/documentation/def_modem_yellow.png

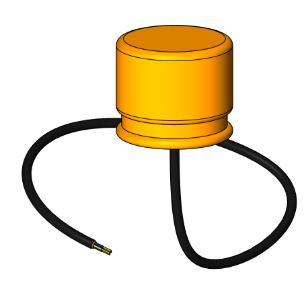
documentation/def_modem_yellow.png
