ucnl/ucnl.github.io/documentation/def_RedWave_package.png

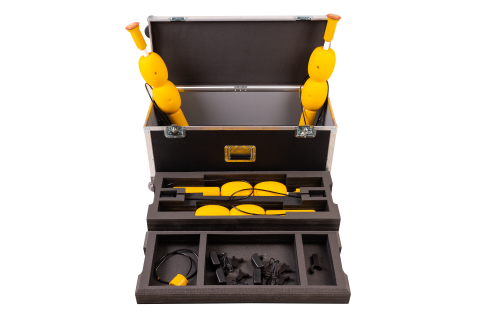
documentation/def_RedWave_package.png
