ucnl/ucnl.github.io/documentation/F4105_uman_2.jpg

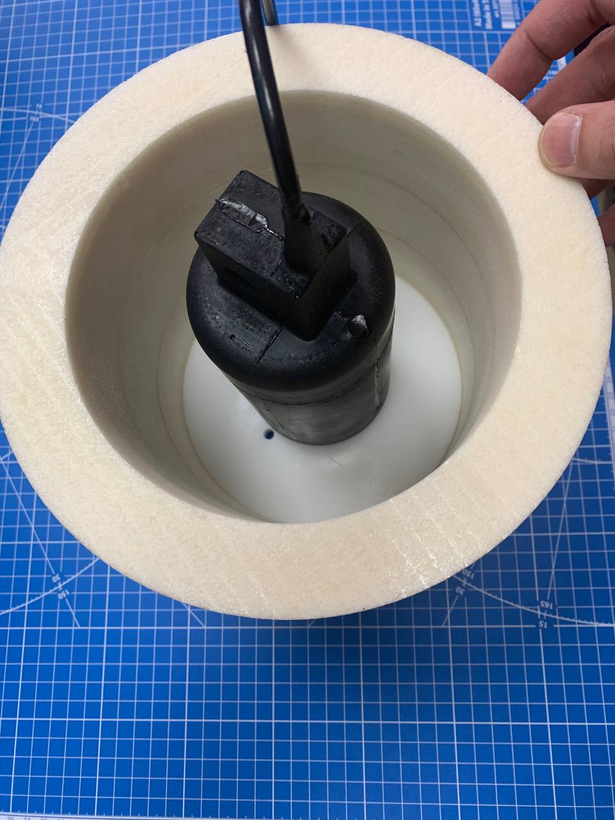
documentation/F4105_uman_2.jpg
