ucnl/ucnl.github.io/documentation/RedBase_v3_LiFEPO4_msds_ru_qr.png

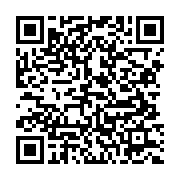
documentation/RedBase_v3_LiFEPO4_msds_ru_qr.png
