ucnl/ucnl.github.io/documentation/redgtr_drawings_ru.png

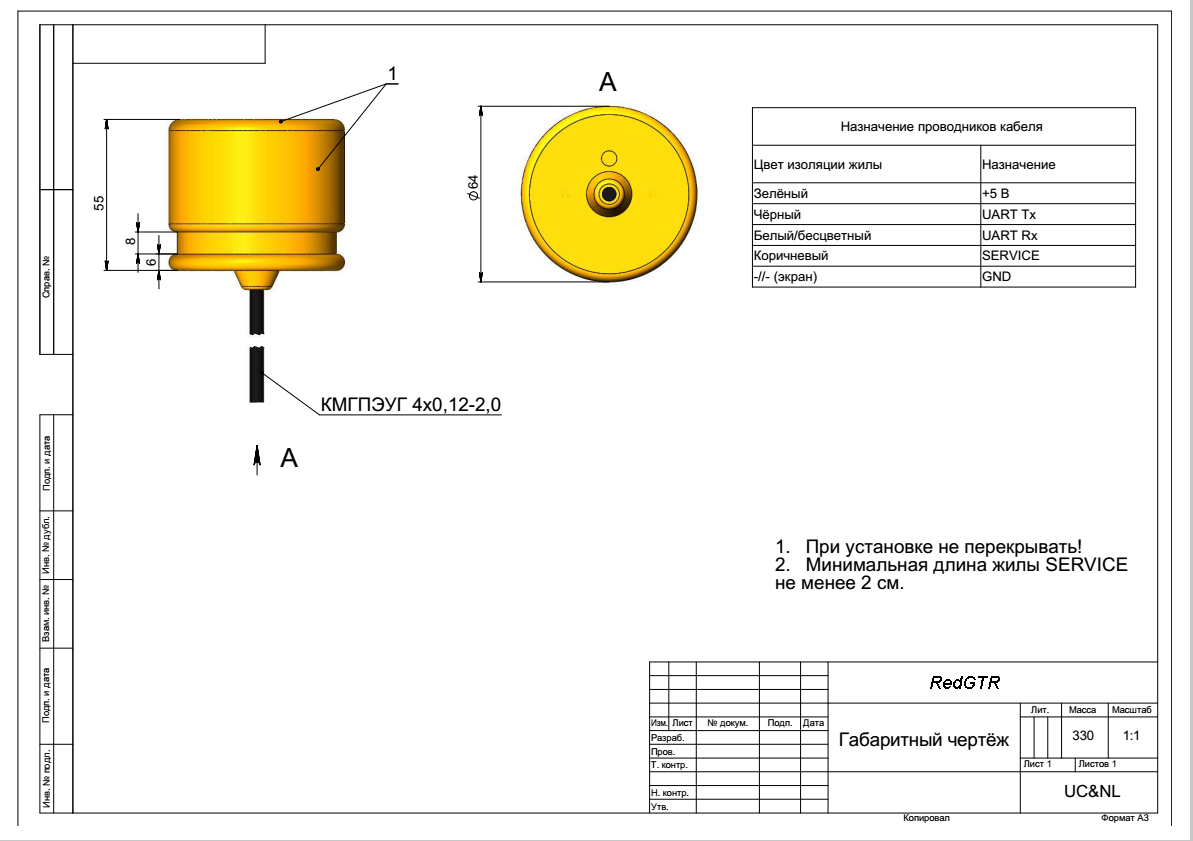
documentation/redgtr_drawings_ru.png
