ucnl/ucnl.github.io/documentation/redphone_os_qr_ru.png

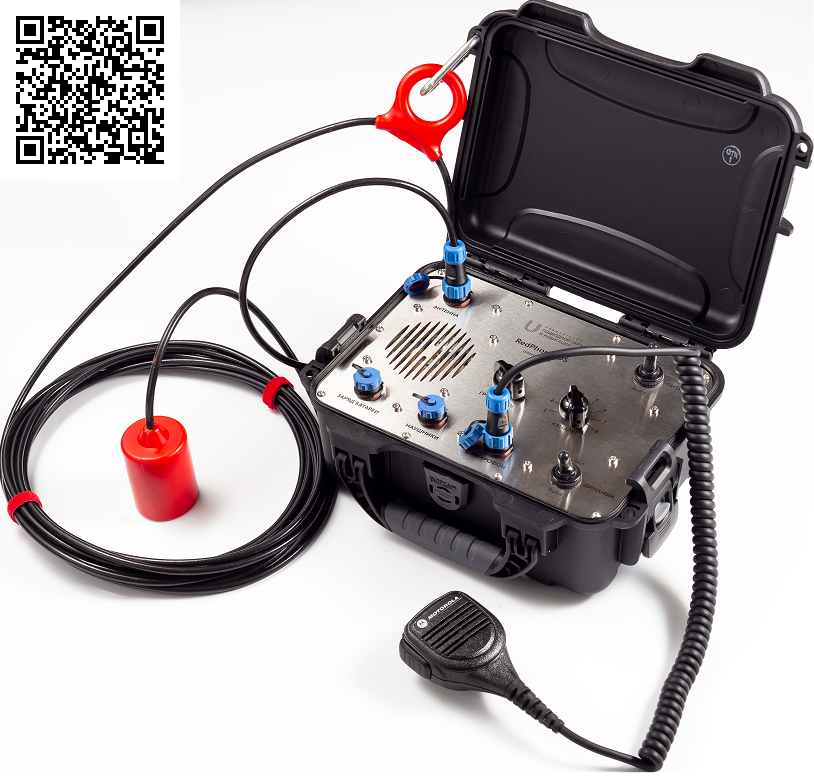
documentation/redphone_os_qr_ru.png
