ucnl/ucnl.github.io/documentation/RT_1_332820_1_ru_impedance.png

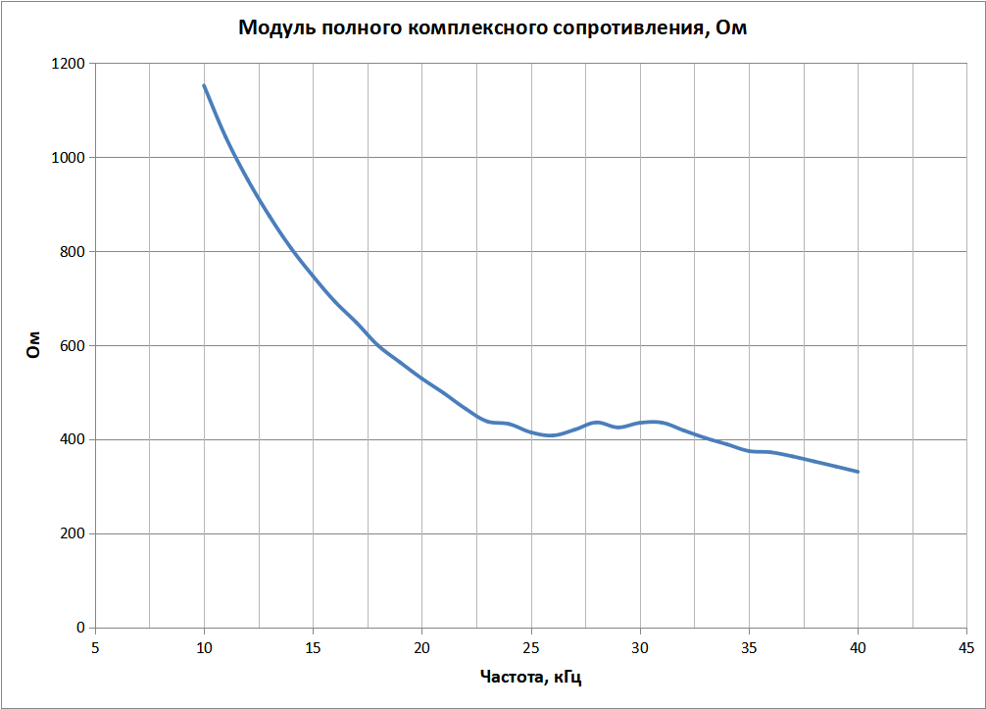
documentation/RT_1_332820_1_ru_impedance.png
