ucnl/ucnl.github.io/documentation/RT_1_332820_1_ru_tx_sensitivity.png

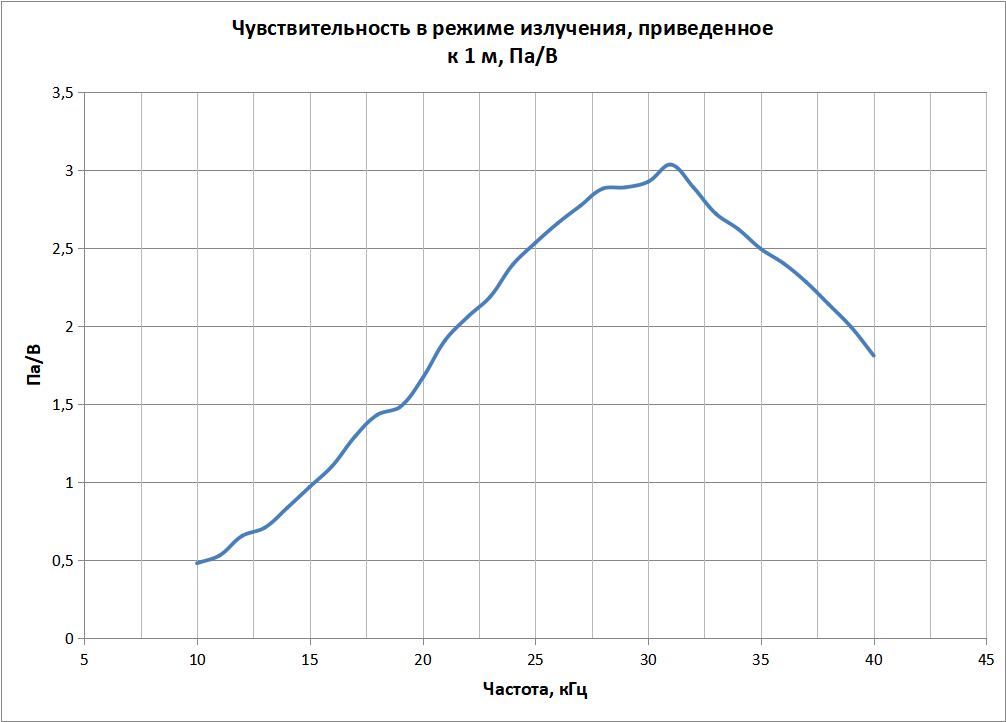
documentation/RT_1_332820_1_ru_tx_sensitivity.png
