ucnl/ucnl.github.io/documentation/RT_1_524525_1_FF_ru_rx_sensitivity.png

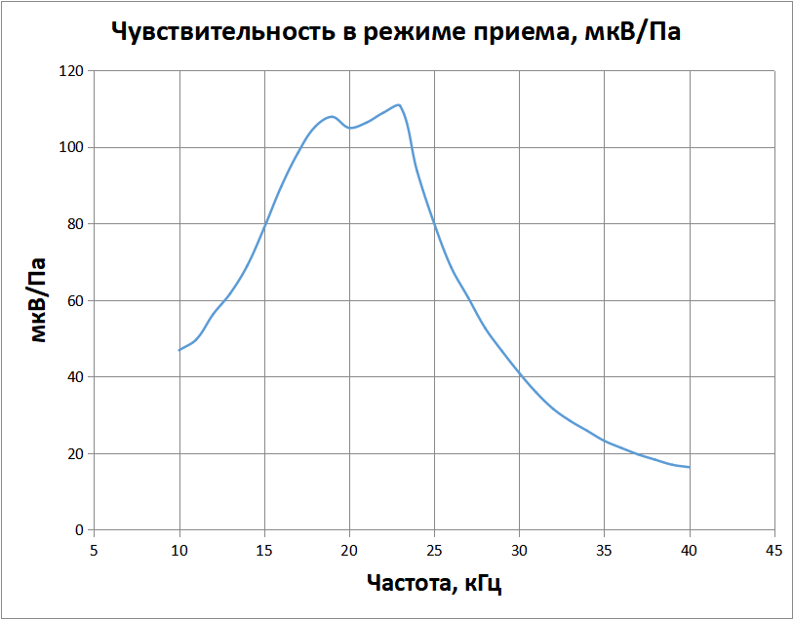
documentation/RT_1_524525_1_FF_ru_rx_sensitivity.png
