ucnl/ucnl.github.io/documentation/RT_1_524525_1_FF_ru_tx_sensitivity.png

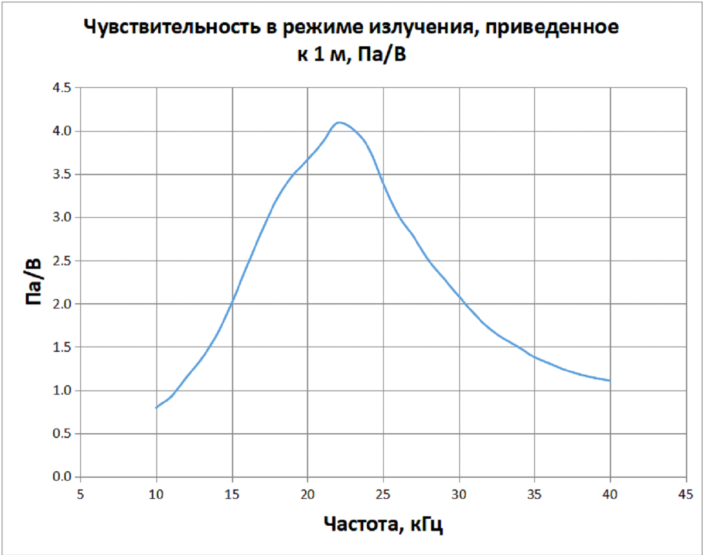
documentation/RT_1_524525_1_FF_ru_tx_sensitivity.png
