ucnl/ucnl.github.io/documentation/RT_1_524525_1_impedance.png

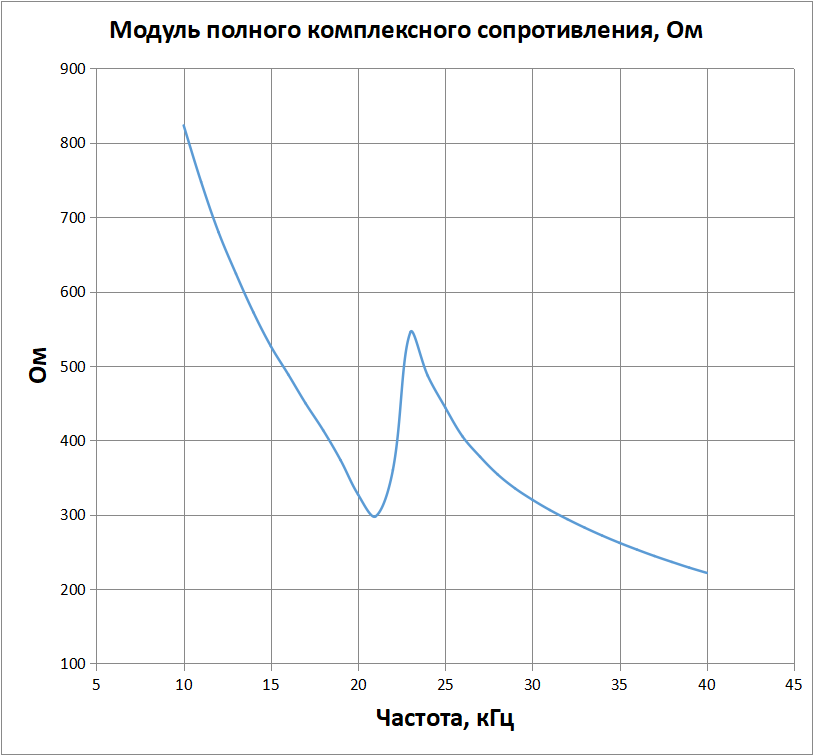
documentation/RT_1_524525_1_impedance.png
