ucnl/ucnl.github.io/documentation/RT_1_524525_1_tx_sensitivity.png

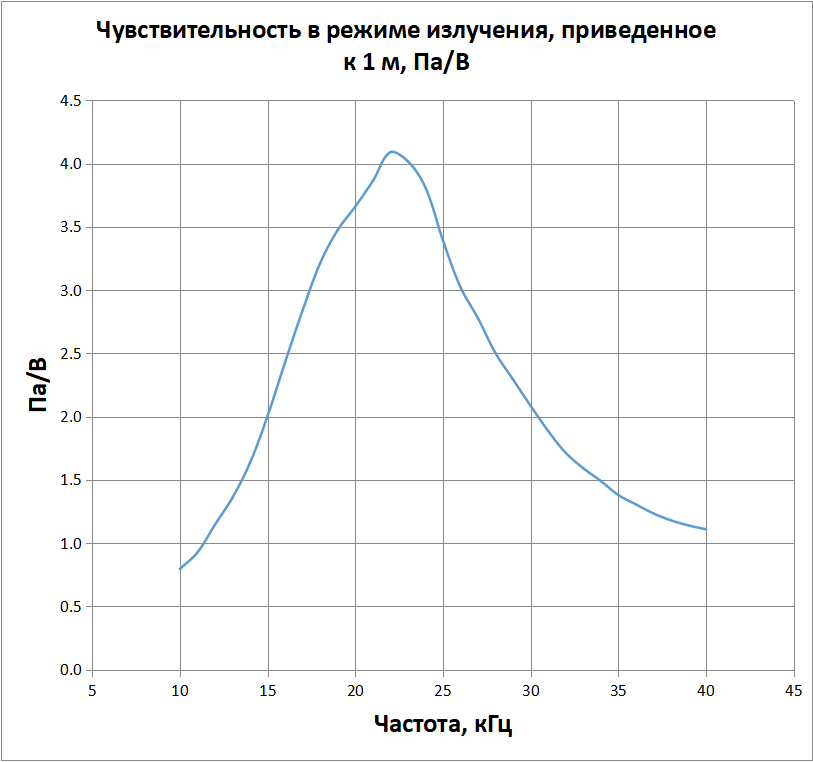
documentation/RT_1_524525_1_tx_sensitivity.png
