ucnl/ucnl.github.io/documentation/RT_1_d23h03_1.jpeg

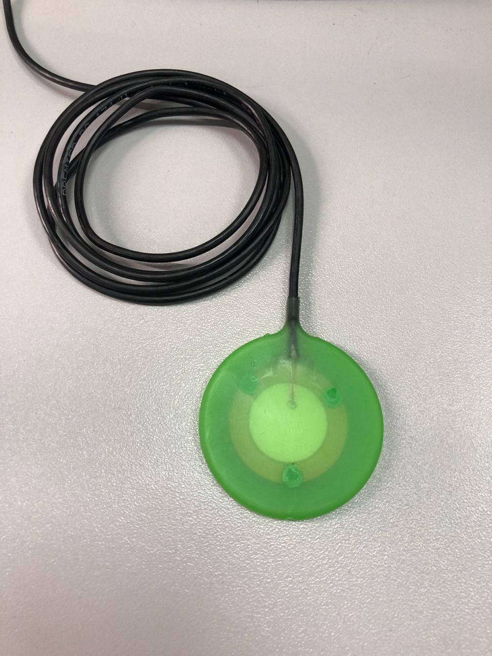
documentation/RT_1_d23h03_1.jpeg
