ucnl/ucnl.github.io/documentation/RT_2_332820_1_ru_rx_sensitivity.png

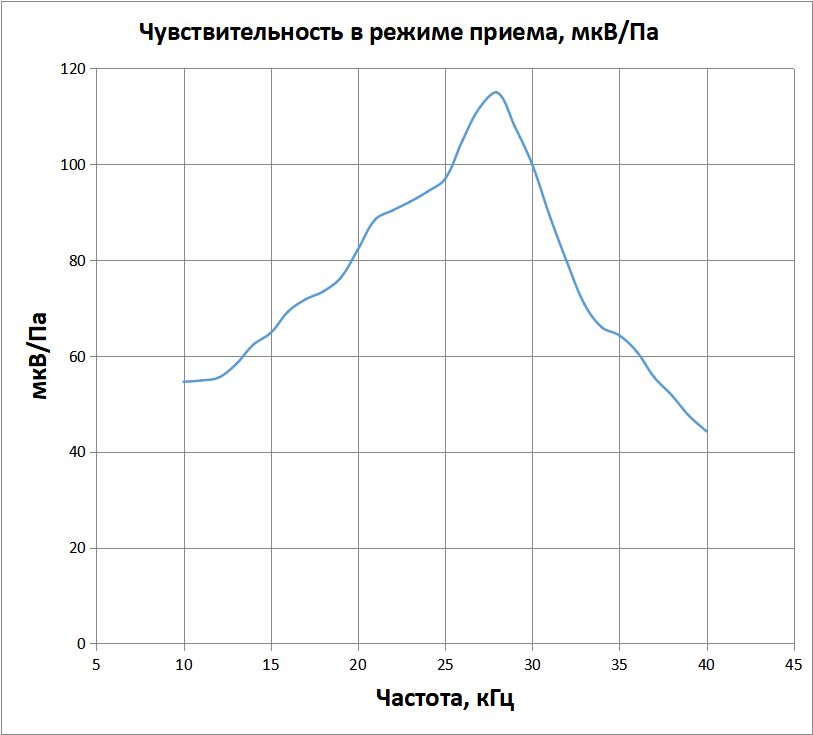
documentation/RT_2_332820_1_ru_rx_sensitivity.png
