ucnl/ucnl.github.io/documentation/RT_2_332820_1_ru_tx_sensitivity.png

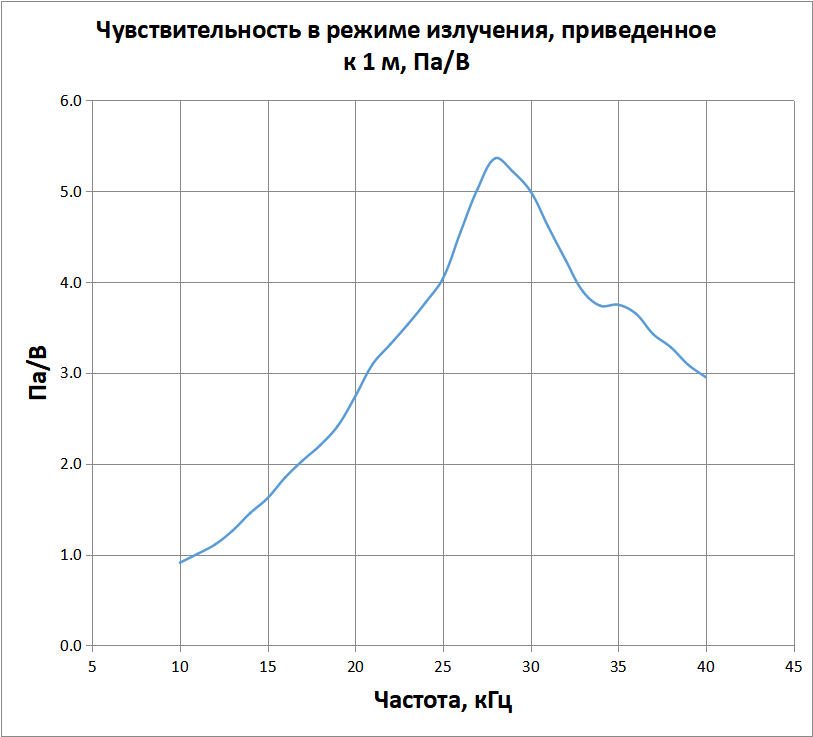
documentation/RT_2_332820_1_ru_tx_sensitivity.png
