ucnl/ucnl.github.io/documentation/rwlt_gib_v_small.png

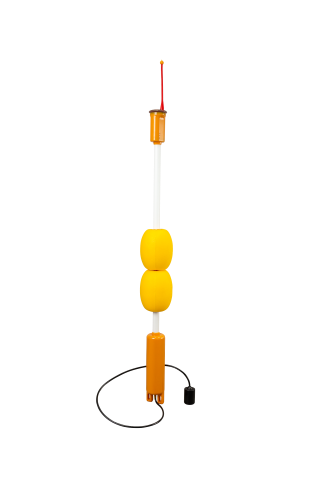
documentation/rwlt_gib_v_small.png
