ucnl/ucnl.github.io/documentation/ucnl_nav_systems_brochure_ru_qr.png

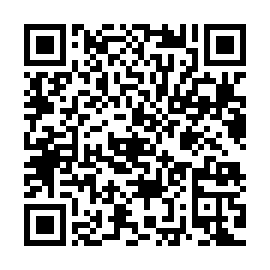
documentation/ucnl_nav_systems_brochure_ru_qr.png
