ucnl/ucnl.github.io/documentation/unavlab_web_qr.png

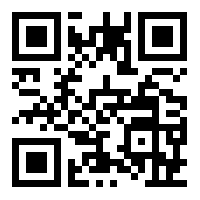
documentation/unavlab_web_qr.png
