ucnl/ucnl.github.io/documentation/utro_pcb_rt_1_524525_1.png

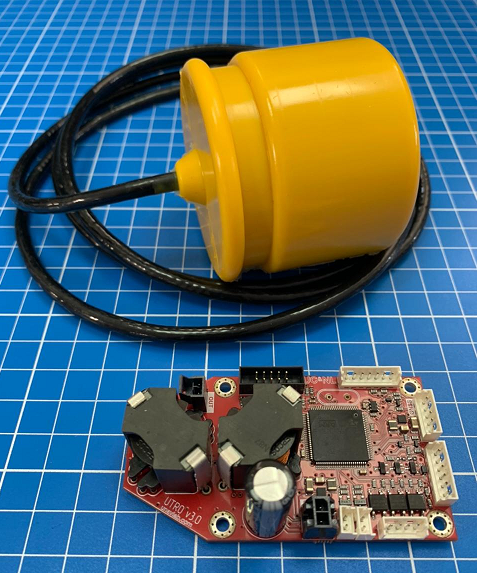
documentation/utro_pcb_rt_1_524525_1.png
