ucnl/ucnl.github.io/documentation/utro_pcb_rt_1_524525_1_2.jpeg

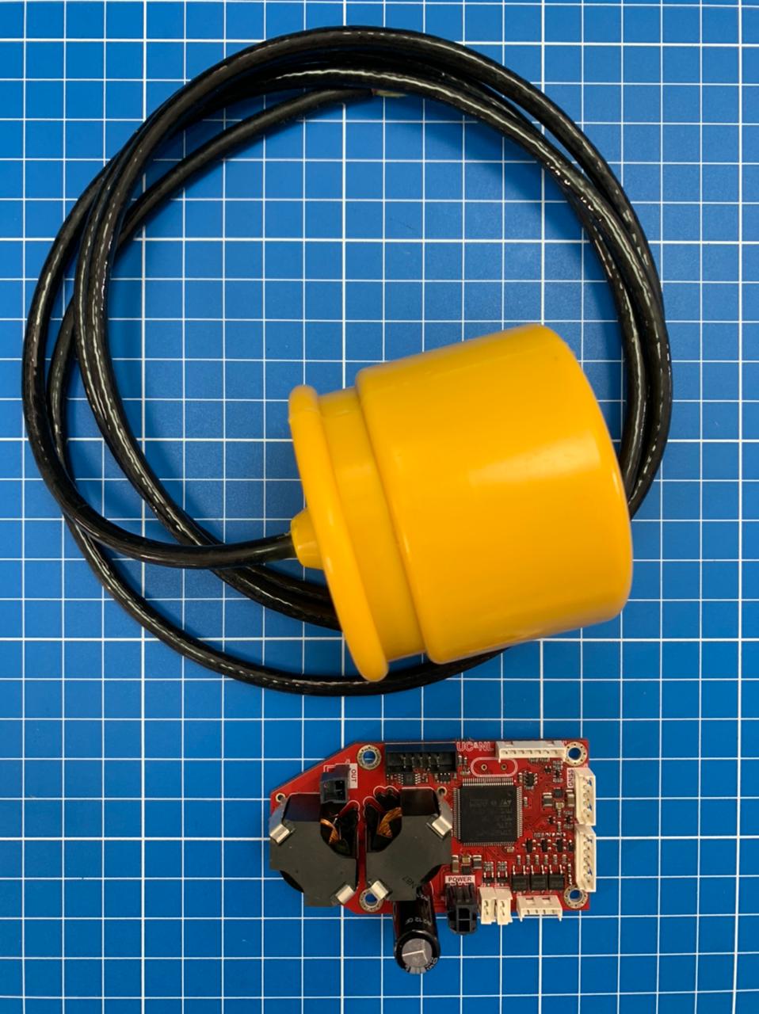
documentation/utro_pcb_rt_1_524525_1_2.jpeg
