ucnl/ucnl.github.io/documentation/uwave_and_uart_usb_converter.png

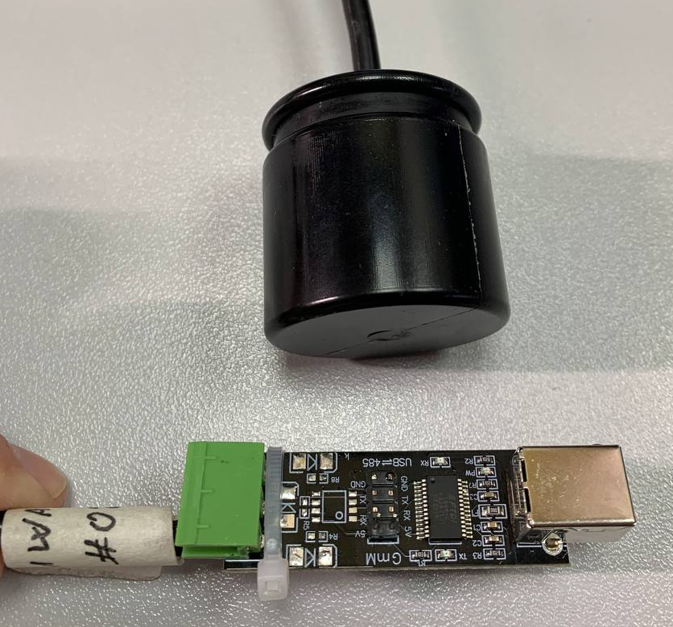
documentation/uwave_and_uart_usb_converter.png
