ucnl/ucnl.github.io/documentation/wayu_rf_dongle.png

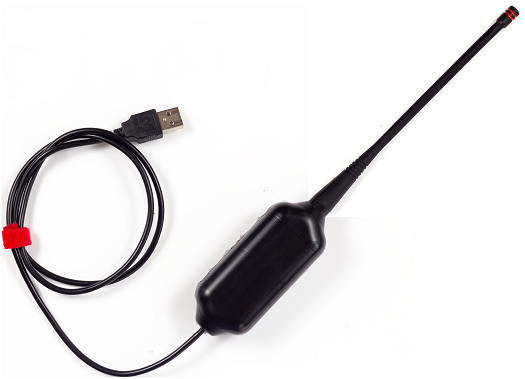
documentation/wayu_rf_dongle.png
