ucnl/ucnl.github.io/documentation/WAYU_Tracks_11-56-52_static_wide.jpg

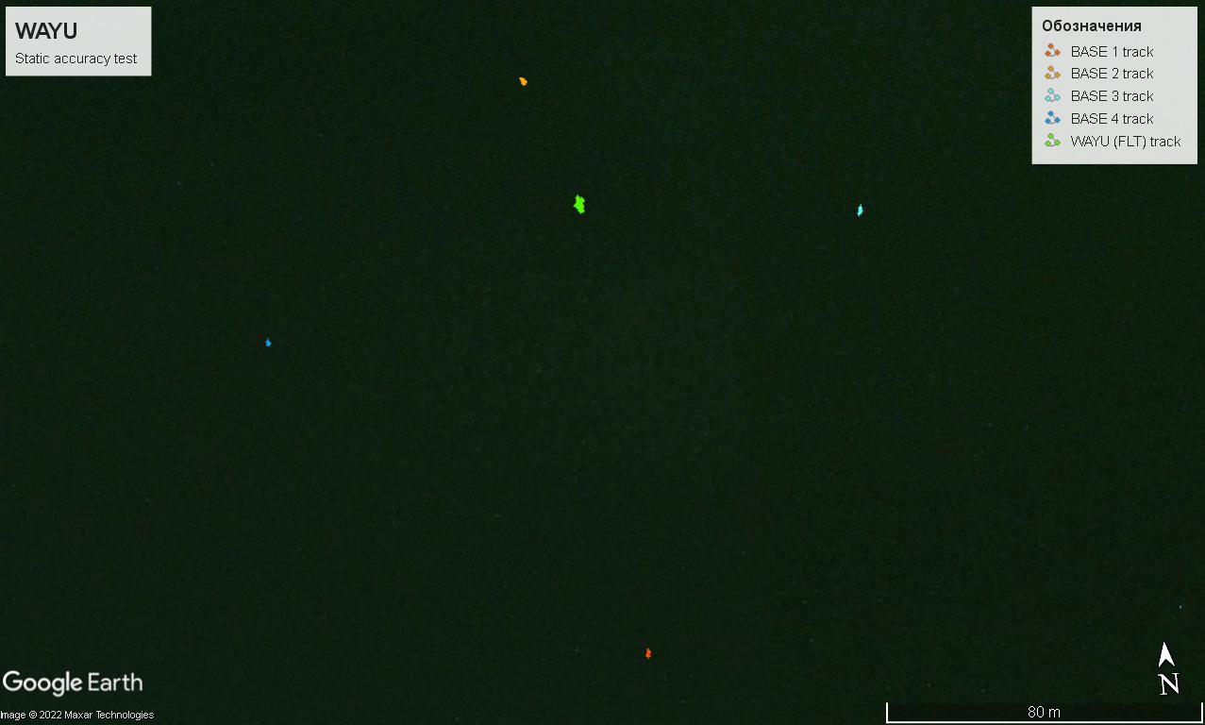
documentation/WAYU_Tracks_11-56-52_static_wide.jpg
