ucnl/ucnl.github.io/documentation/wayu_trionix_11_AUG_valaam.png

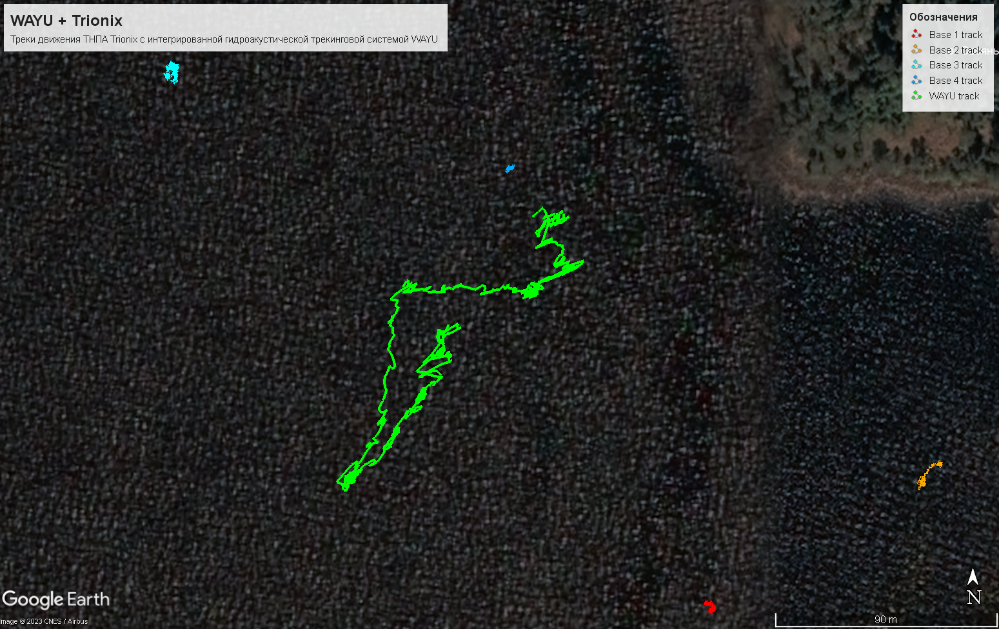
documentation/wayu_trionix_11_AUG_valaam.png
