ucnl/ucnl.github.io/documentation/zima_29_SEP_2021.jpg

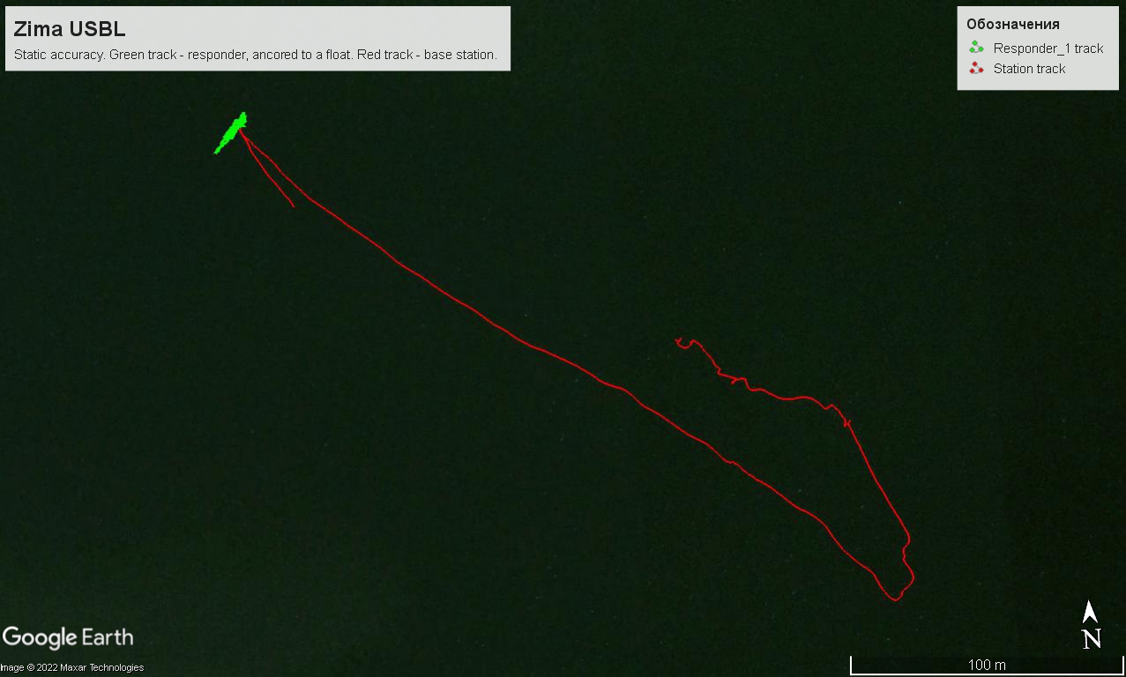
documentation/zima_29_SEP_2021.jpg
