ucnl/ucnl.github.io/documentation/zima_r_drawings.png

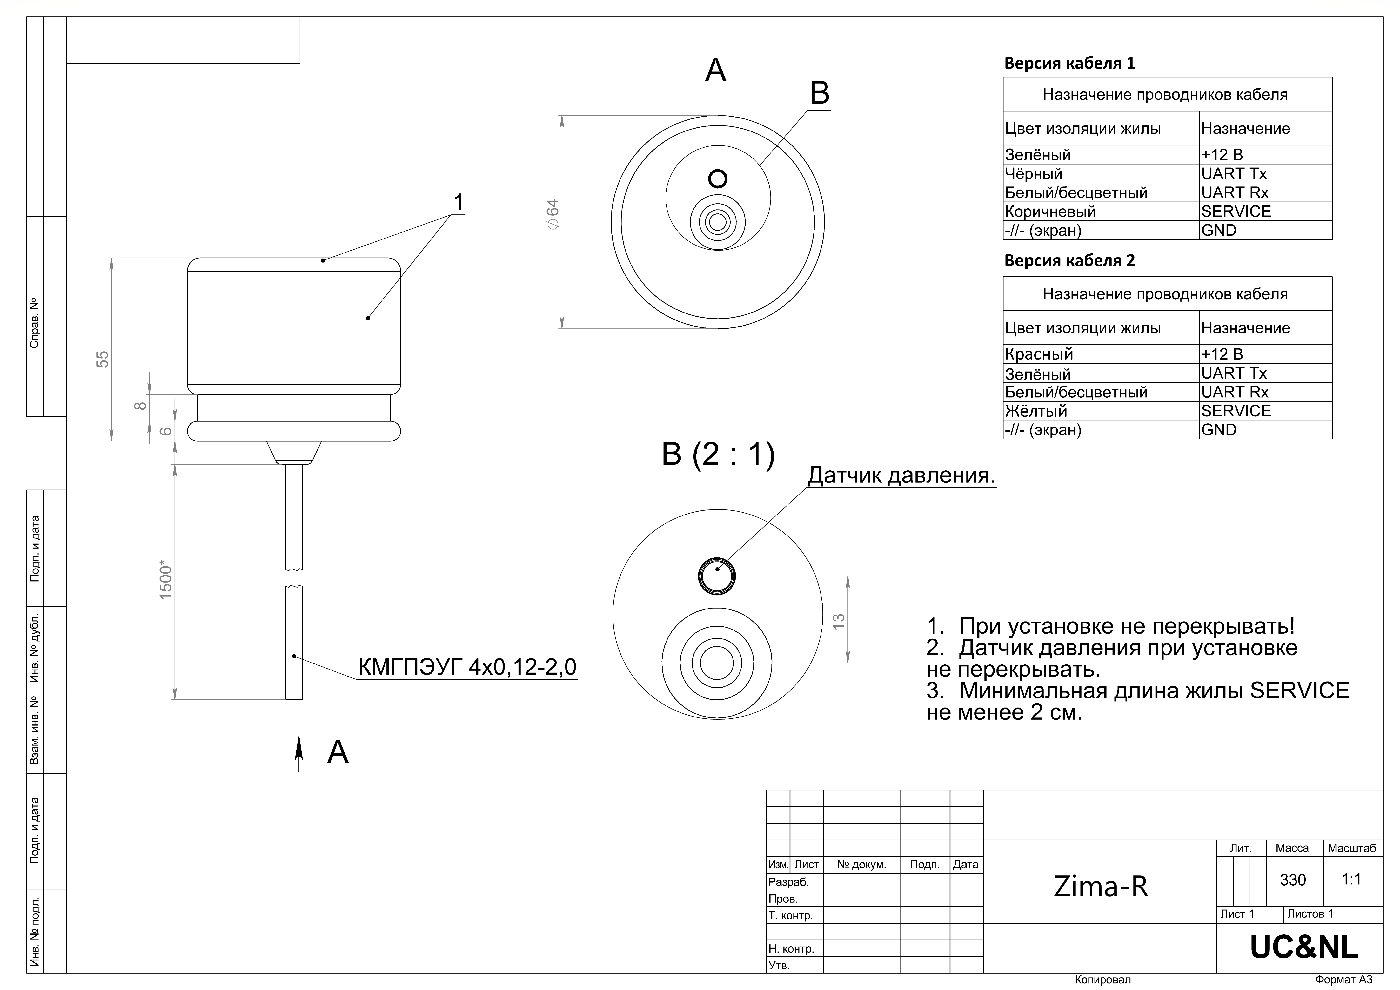
documentation/zima_r_drawings.png
