ucnl/ucnl.github.io/images/attenuation_article_headpic.png

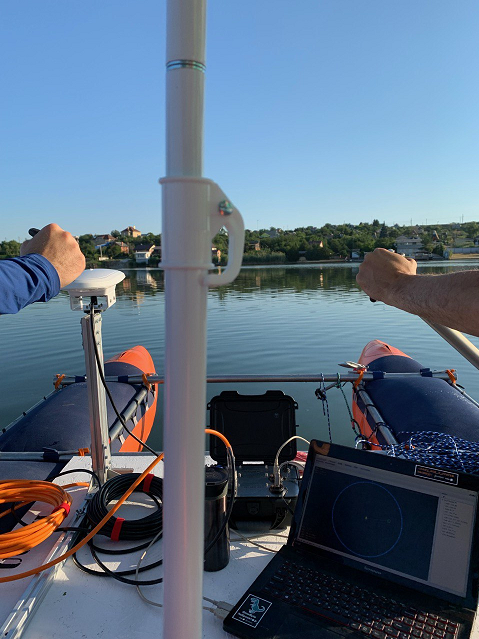
images/attenuation_article_headpic.png
