ucnl/ucnl.github.io/images/equation_from_bobrovsky.png

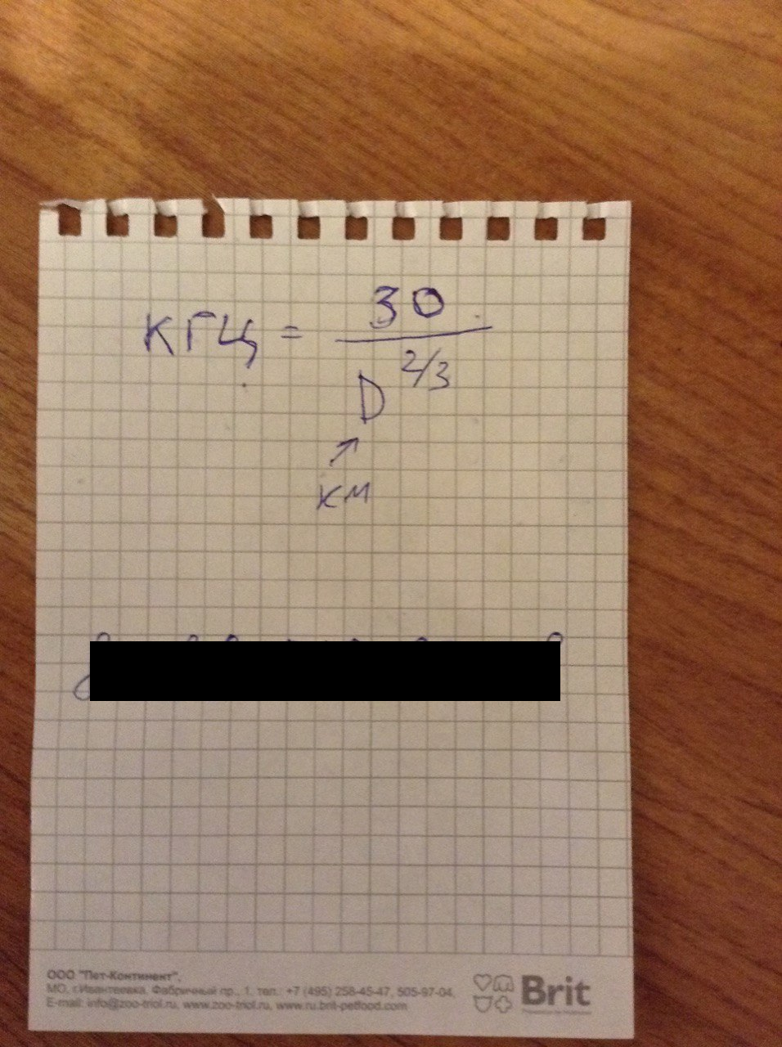
images/equation_from_bobrovsky.png
