ucnl/ucnl.github.io/images/r_vs_freq_simple.png

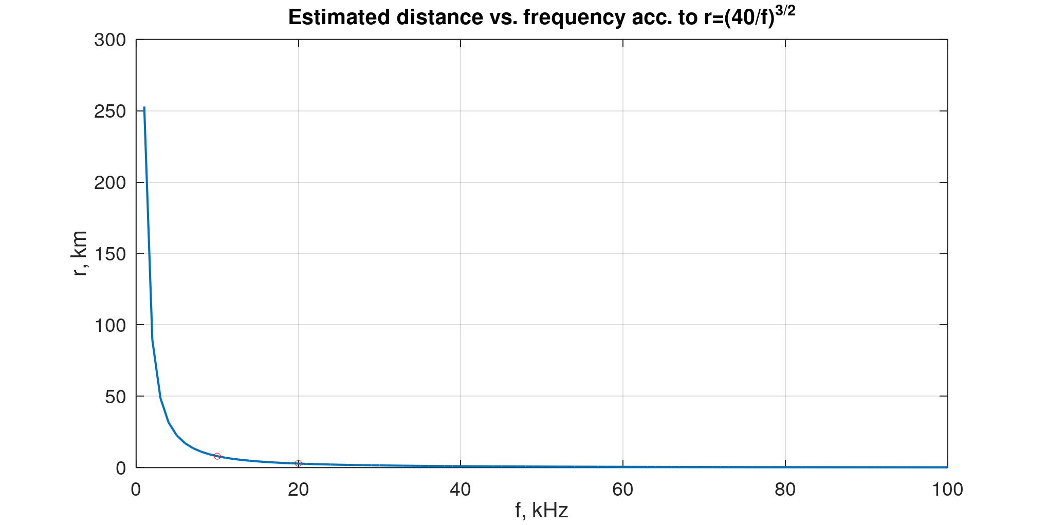
images/r_vs_freq_simple.png
