ucnl/ucnl.github.io/images/r_vs_freq_total.png

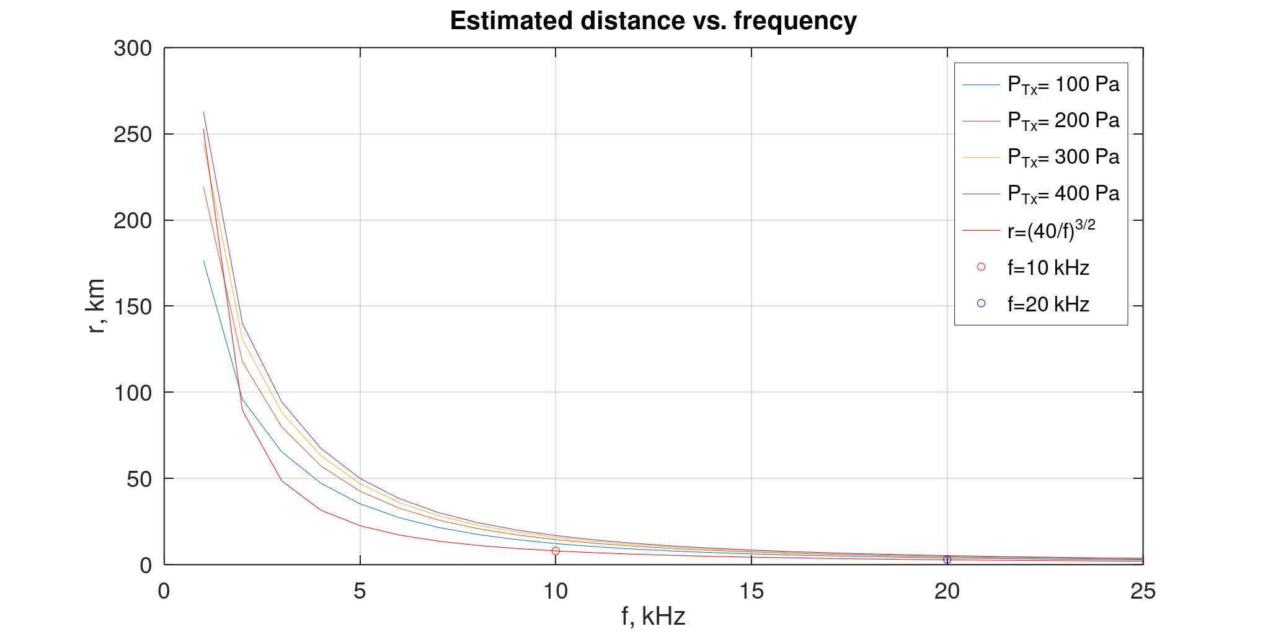
images/r_vs_freq_total.png
