ucnl/ucnl.github.io/redwave_03_03_2020.jpg

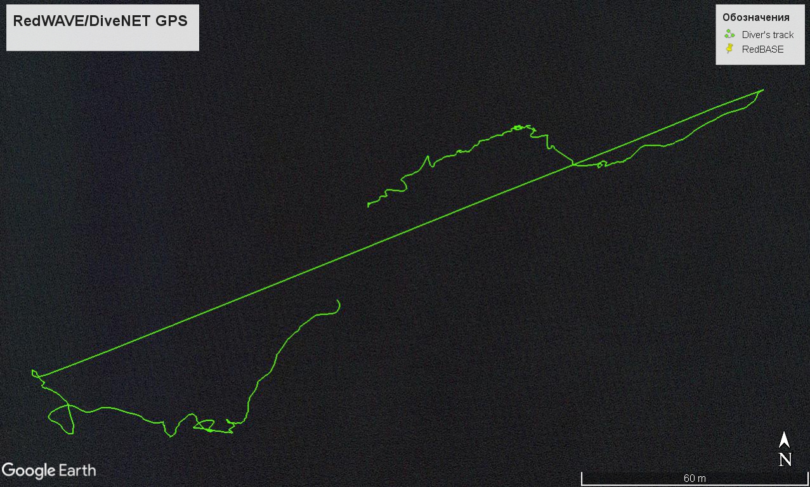
redwave_03_03_2020.jpg
