ucnl/ucnl.github.io/documentation/Zima2B_uWaveUSBL.step

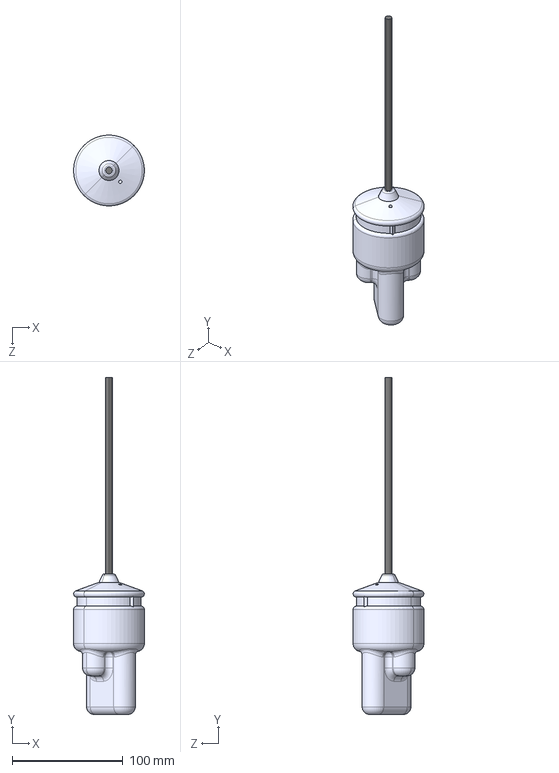
[picture p90: CAD file, 2026-08-26]
documentation/Zima2B_uWaveUSBL.step
63.9 x 304.6 x 63.9 mm
КМГПЭУГ 6х0,12-2,0
Заливка Zima2-В
