ucnl/ucnl.github.io/documentation/uWave_Max.step

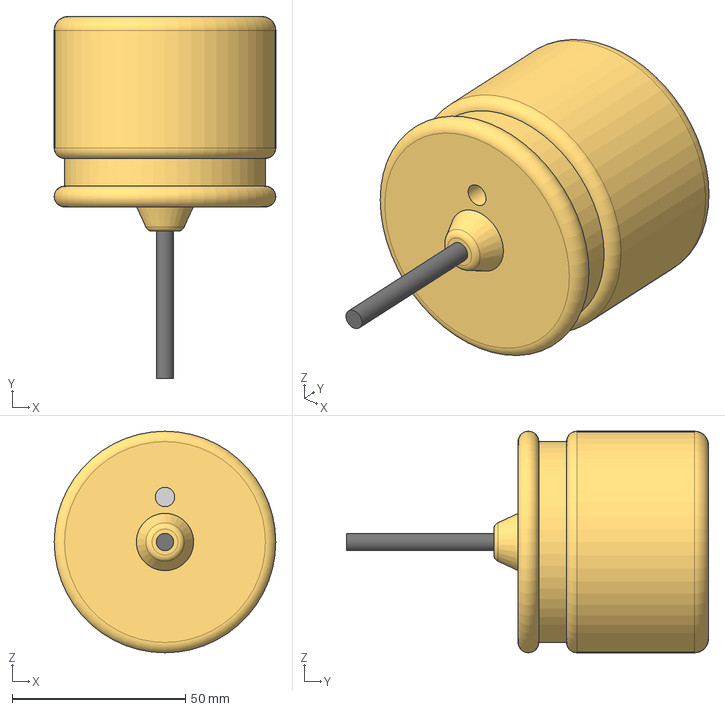
[picture p91: CAD file, 2022-10-29]
documentation/uWave_Max.step
64.0 x 104.6 x 64.0 mm
