ucnl/ucnl.github.io/documentation/uWave.step

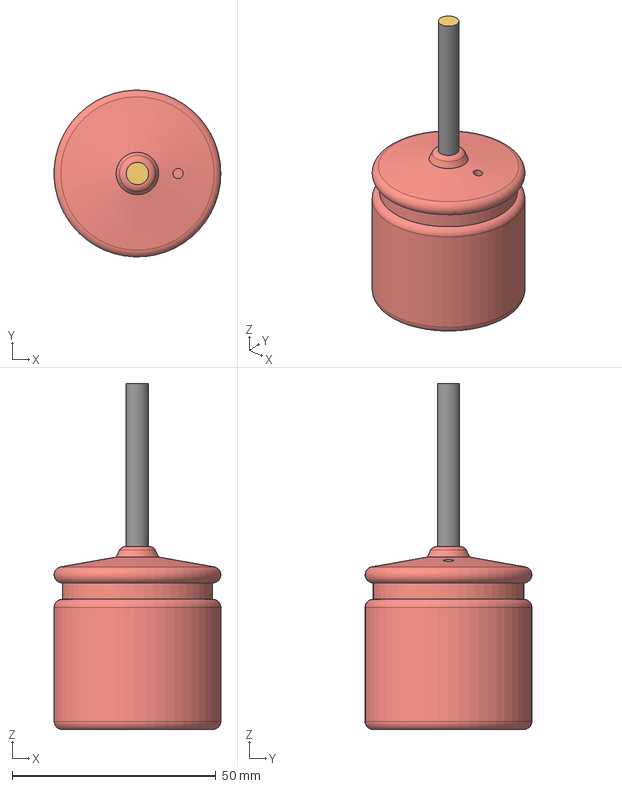
[picture p92: CAD file, 2022-10-29]
documentation/uWave.step
41.0 x 41.0 x 85.0 mm
