ucnl/ucnl.github.io/documentation/RedBase_v2.0_3D.STEP

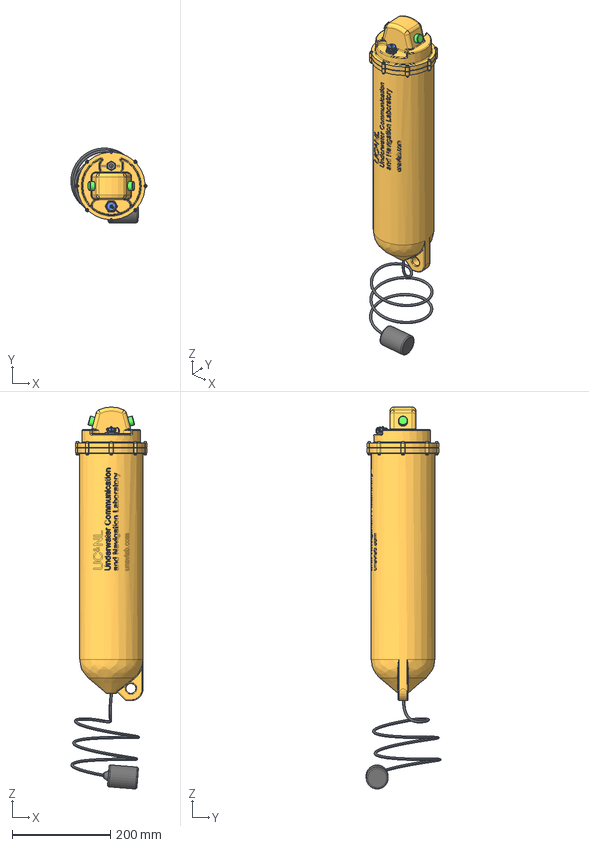
[picture p93: CAD file, 2021-09-10]
documentation/RedBase_v2.0_3D.STEP
155.5 x 152.7 x 779.1 mm
RedBase_Корпус_v1.0_с_м аркировкой
O-Ring 124x3mm
px0413_02s_01
px0413_02s_02
px0413_02s_03
px0413_02s_04
PX0484_Ready_to_Use
WPC-01
socket head cap screw_din_DIN 912 M3 x 25 --- 25C x 8
prevailing torque nut thin insert_din_DIN EN ISO 10511 - M3 - N x 8
RedBase_Polyurethane
RedBase_Крышка_v2.0
AD-16DS(LED) x 2
КМГПЭУГ (спир аль)
