ucnl/ucnl.github.io/documentation/RedNavwith_compass_3D.step

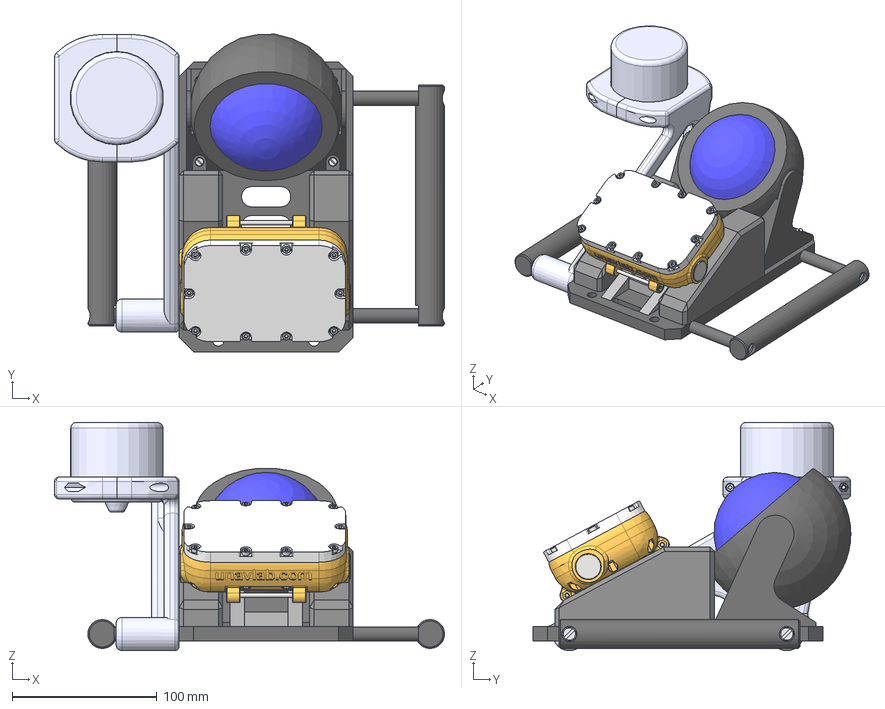
[picture p94: CAD file, 2021-09-10]
documentation/RedNavwith_compass_3D.step
269.0 x 219.1 x 157.5 mm
Заливка_uGTR-uNode
RedNav v2.0_Body
PS161P10YSS1 x 2
RedNav v2.0_Glass
prevailing torque nut thin insert_din_DIN EN ISO 10511 - M3 - N x 10
socket head cap screw_am_B18.3.1M - 3 x 0.5 x 50 Hex SHCS -- 50NHX x 2
socket head cap screw_din_DIN 912 M3 x 25 --- 18N x 10
RedNav v2.0_Plastic_Film
O-ring RedNav v2.0
Navigation Panel 2012
Крепление на нав игационную пане ль
Крепление на нав игационную пане ль (скоба)
socket head cap screw_din_DIN 912 M3 x 25 --- 25N x 2
prevailing torque nut style 1 insert_din_DIN EN ISO 7040 - M3 - N x 2
