ucnl/ucnl.github.io/(list of files, cad)

Other CAD files:
documentation/uWAVE_holder_tank.f3d
