ucnl/ucnl.github.io/documentation/EN/RedWAVE/RedNODE_wiring_diagram_en.md

[Main](/) ❯ [Navigation & tracking systems](/navigation_and_tracking_systems_en) ❯ **RedNode: Wiring diagram**

|  |  |
| :---: | ---: |
| [www.unavlab.com](https://www.unavlab.com/) <br/> [support@unavlab.com](mailto:support@unavlab.com) | **RedNode** Navigation receiver <br/> Cable wire assignment and dimensions |

## CABLE WIRE ASSIGNMENT

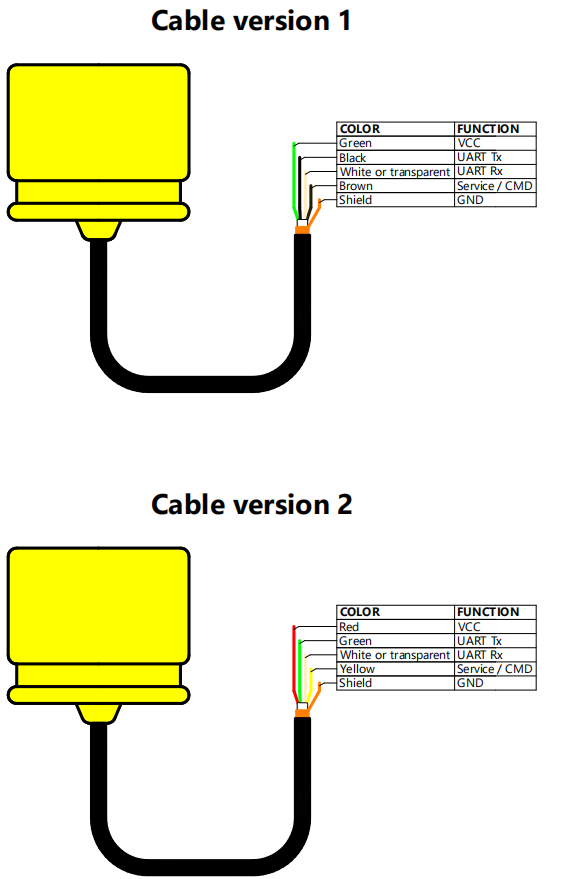
[picture p95: documentation/RedNODE_wiring_diagram_en.png]
RedLINE_wiring_diagram


## DIMENSIONAL DRAWING

RedLINE_drawing
