ucnl/ucnl.github.io/documentation/EN/uWAVE/uWAVE_wiring_diagram_en.md

[Main](/../../) ❯ [Underwater acoustic modems](/underwater_acoustic_modems_en) ❯ **Device wiring diagram: uWave**

|  |  |
| :---: | ---: |
| [www.unavlab.com](https://www.unavlab.com/) <br/> [support@unavlab.com](mailto:support@unavlab.com) | **uWAVE** underwater acoustic modem <br/> Wiring diagram & drawings |

### WIRING DIAGRAM
uWAVE_wiring_diagram_en

### DRAWINGS
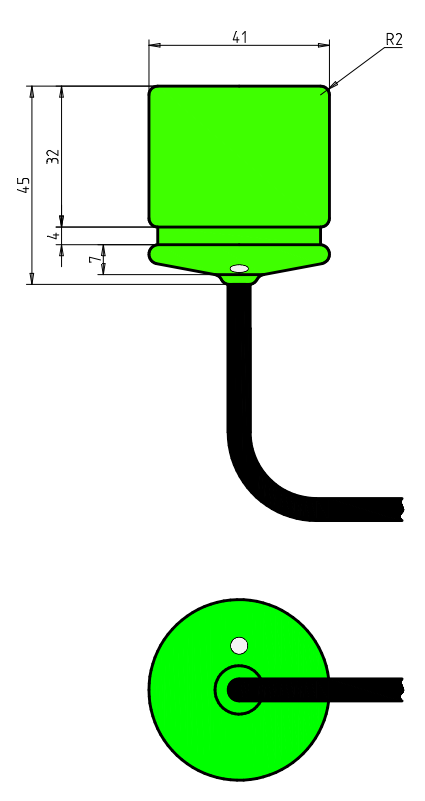
[picture p118: documentation/uWAVE_drawing.png]
uWAVE_drawing


### INSTALLATION REQUIREMENTS

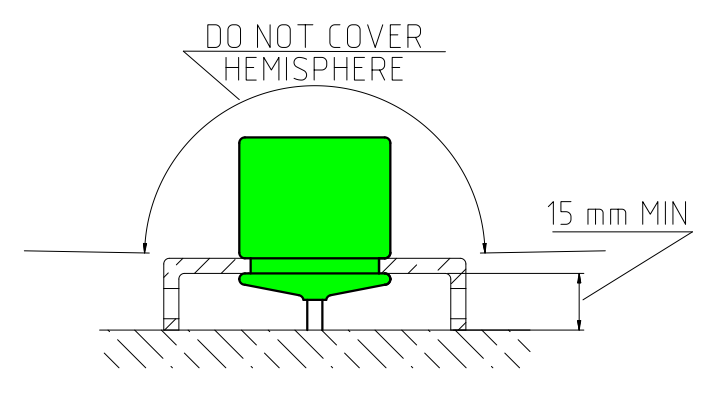
[picture p119: documentation/uWave_mount.png]
uWAVE_mount
