ucnl/ucnl.github.io/documentation/EN/Zima/ZimaR_wiring_diagram_en.md

|  |  |
| :---: | ---: |
| [www.unavlab.com](https://www.unavlab.com/) <br/> [support@unavlab.com](mailto:support@unavlab.com) | **Zima-R** Responder-beacon <br/> Wiring diagram and drawings |

## WIRING DIAGRAM

ZimaR_wiring_diagram

## DRAWINGS

RedLINE_drawing
