ucnl/ucnl.github.io/documentation/EN/RedLINE/RedLINE_wiring_diagram_en.md

|  |  |
| :---: | ---: |
| [www.unavlab.com](https://www.unavlab.com/) <br/> [support@unavlab.com](mailto:support@unavlab.com) | **RedLINE** Underwater acoustic modem <br/> Wiring diagram and drawings |

### WIRING DIAGRAM
RedLINE_wiring_diagram

## DRAWINGS
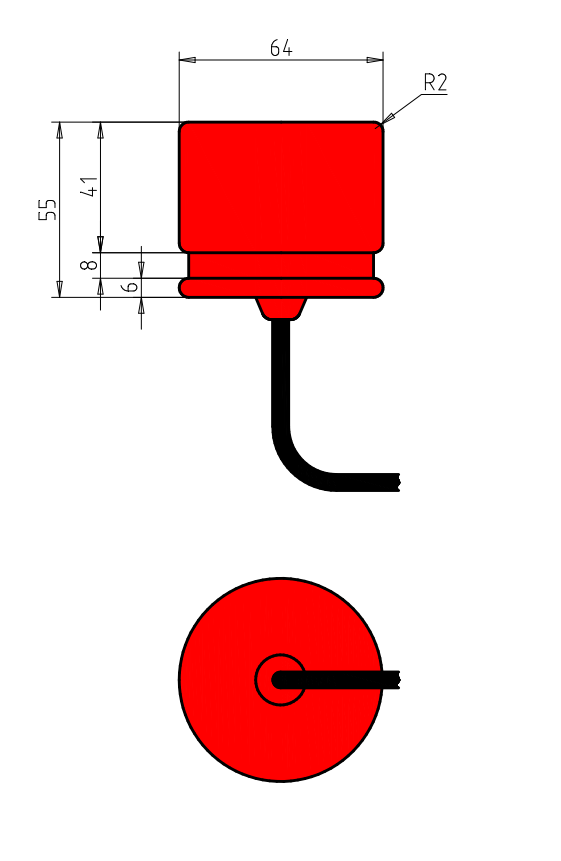
[picture p127: documentation/RedLINE_drawings.png]
RedLINE_drawing
