ucnl/ucnl.github.io/documentation/RU/uWAVE/uWAVE_Getting_started_ru.md

|  |  |
| :---: | ---: |
| [www.unavlab.com](https://www.unavlab.com/) <br/> [support@unavlab.com](mailto:support@unavlab.com) | **uWAVE** - миниатюрные гидроакустические модемы <br/> Быстрый старт |
  
# ВНИМАНИЕ! ДАННЫЙ ДОКУМЕНТ НАХОДИТСЯ В ПРОЦЕССЕ РАЗРАБОТКИ!  
  
# Гидроакустические модемы uWAVE: <br/> Быстрый старт

## Введение
Данное краткое руководство призвано помочь пользователю максимально быстро и просто начать использовать гидроакустические модемы 
[uWAVE](uWAVE_Specification_ru.md).  
В рамках данного документа рассматривется:
- Подключение модема к ПК;
- Переключение между режимами прозрачного канала и командным режимом;
- Взаимодействие с модемом посредством ПО [uWAVE_Host](https://api.github.com/repos/ucnl/uWAVE_Host/zipball);
- Проверка акустической связи между двумя модемами.

## 1. Список необходимых компонентов

- гидроакустический модем uWAVE[uWAVE](uWAVE_Specification_ru.md) (для проверки акустической связи потребуется как минимум 2 модема);
- ПК с ОС Windows 7 и выше, с установленным .NET Framework 4.5
- Преобразователь интерфейса **USB-UART** с логическими уровнями 3.3 - 5 Вольт
- ПО [uWAVE Host](https://api.github.com/repos/ucnl/uWAVE_Host/zipball)

## 2. Подключение модемов к преобразователям интерфейса
Модемы подключается к преобразователю интерфейса в соответствие с таблицей 1.

*Таблица 1 - функции жил кабеля модема*
| № | Цвет жилы | Функция |
| :--- | :--- | :--- |
| 1 | Зеленый | +5 .. +12 В |
| 2 | Черный | UART Tx |
| 3 | Белый/Прозрачный | UART Rx |
| 4 | Коричневый | SVC/CMD |
| 5 | Экран (оплетка) | GND |

Жила **SVC/CMD** отвечает за переключение между режимом прозрачного канала и командным режимом.
