ucnl/ucnl.github.io/documentation/RU/uWAVE/uWAVE_wiring_diagram_ru.md

[Главная](/README_RU) ❯ [Гидроакустические модемы](/underwater_acoustic_modems_ru) ❯ **Схема подключения: uWave**

<details>
  <summary><b>ℹ Рекомендации для печати/сохранения в PDF</b></summary>
  <br>
  <ol>
    <li>Нажмите <b>Ctrl+P</b> (macOS: <b>Cmd+P</b>)</li>
    <li>В настройках принтера выберите <b>«Сохранить как PDF»</b> (Microsoft Print to PDF)</li>
    <li>В поле <b>«Страницы»</b> укажите диапазон, исключая первую и последнюю страницу</li>
    <li>Отключите <b>верхние и нижние колонтитулы</b> (заголовки/URL/page numbers)</li>
    <li>В <b>Chrome/Edge</b>: в доп. настройках → «Поля» → <b>Нет</b> | в <b>Firefox</b>: «Поля и колонтитулы» → <b>Нет</b></li>
    <li>Нажмите <b>Печать</b> и укажите куда сохранить PDF</li>
  </ol>
</details>

|  |  |
| :---: | ---: |
| [www.unavlab.com](https://www.unavlab.com/) <br/> [support@unavlab.com](mailto:support@unavlab.com) | **uWAVE** Гидроакустический модем <br/> Назначение жил кабеля и габариты |

### НАЗНАЧЕНИЕ ЖИЛ КАБЕЛЯ

uWAVE_wiring_diagram_ru

### ГАБАРИТНЫЙ ЧЕРТЕЖ

uWAVE_drawing

### ТРЕБОВАНИЯ ПО УСТАНОВКЕ

uWAVE_mount
