ucnl/ucnl.github.io/documentation/RU/Zima/Bat_n_link_box_Users_manual_ru.md

[Главная](/README_RU) ❯ [Гидроакустические навигационные и трекинговые системы](/navigation_and_tracking_systems_ru) ❯ **Руководство пользователя: Bat&Link Box**

<details>
  <summary><b>ℹ Рекомендации для печати/сохранения в PDF</b></summary>
  <br>
  <ol>
    <li>Нажмите <b>Ctrl+P</b> (macOS: <b>Cmd+P</b>)</li>
    <li>В настройках принтера выберите <b>«Сохранить как PDF»</b> (Microsoft Print to PDF)</li>
    <li>В поле <b>«Страницы»</b> укажите диапазон, исключая первую и последнюю страницу</li>
    <li>Отключите <b>верхние и нижние колонтитулы</b> (заголовки/URL/page numbers)</li>
    <li>В <b>Chrome/Edge</b>: в доп. настройках → «Поля» → <b>Нет</b> | в <b>Firefox</b>: «Поля и колонтитулы» → <b>Нет</b></li>
    <li>Нажмите <b>Печать</b> и укажите куда сохранить PDF</li>
  </ol>
</details>

|  | Bat&Link Box |
| :---: | ---: |
| [www.unavlab.com](https://www.unavlab.com/) <br/> [support@unavlab.com](mailto:support@unavlab.com) | **Bat & Link Box** - источник питания и преобразователь интерфейса <br/> Руководство пользователя |

# Bat & Link Box <br/> Руководство пользователя

## Содержание
- [1. Введение](#1-%D0%B2%D0%B2%D0%B5%D0%B4%D0%B5%D0%BD%D0%B8%D0%B5)
- [2. Внешний вид и ограны управления](#2-%D0%B2%D0%BD%D0%B5%D1%88%D0%BD%D0%B8%D0%B9-%D0%B2%D0%B8%D0%B4-%D0%B8-%D0%BE%D0%B3%D1%80%D0%B0%D0%BD%D1%8B-%D1%83%D0%BF%D1%80%D0%B0%D0%B2%D0%BB%D0%B5%D0%BD%D0%B8%D1%8F)
- [3. Распиновки разъемов](#3-%D1%80%D0%B0%D1%81%D0%BF%D0%B8%D0%BD%D0%BE%D0%B2%D0%BA%D0%B8-%D1%80%D0%B0%D0%B7%D1%8A%D0%B5%D0%BC%D0%BE%D0%B2)
- [4. Работа с устройством](#4-%D1%80%D0%B0%D0%B1%D0%BE%D1%82%D0%B0-%D1%81-%D1%83%D1%81%D1%82%D1%80%D0%BE%D0%B9%D1%81%D1%82%D0%B2%D0%BE%D0%BC)
- [5. Хранение и обслуживание](#5-%D1%85%D1%80%D0%B0%D0%BD%D0%B5%D0%BD%D0%B8%D0%B5-%D0%B8-%D0%BE%D0%B1%D1%81%D0%BB%D1%83%D0%B6%D0%B8%D0%B2%D0%B0%D0%BD%D0%B8%D0%B5)
- [6. Обязательства и отказ от ответственности](#6-%D0%BE%D0%B1%D1%8F%D0%B7%D0%B0%D1%82%D0%B5%D0%BB%D1%8C%D1%81%D1%82%D0%B2%D0%B0-%D0%B8-%D0%BE%D1%82%D0%BA%D0%B0%D0%B7-%D0%BE%D1%82-%D0%BE%D1%82%D0%B2%D0%B5%D1%82%D1%81%D1%82%D0%B2%D0%B5%D0%BD%D0%BD%D0%BE%D1%81%D1%82%D0%B8)
  - [6.1. Условия замены и бесплатного гарантийного обслуживания](#61-%D1%83%D1%81%D0%BB%D0%BE%D0%B2%D0%B8%D1%8F-%D0%B7%D0%B0%D0%BC%D0%B5%D0%BD%D1%8B-%D0%B8-%D0%B1%D0%B5%D1%81%D0%BF%D0%BB%D0%B0%D1%82%D0%BD%D0%BE%D0%B3%D0%BE-%D0%B3%D0%B0%D1%80%D0%B0%D0%BD%D1%82%D0%B8%D0%B9%D0%BD%D0%BE%D0%B3%D0%BE-%D0%BE%D0%B1%D1%81%D0%BB%D1%83%D0%B6%D0%B8%D0%B2%D0%B0%D0%BD%D0%B8%D1%8F)
  - [6.2. Ограничение ответственности производителя](#62-%D0%BE%D0%B3%D1%80%D0%B0%D0%BD%D0%B8%D1%87%D0%B5%D0%BD%D0%B8%D0%B5-%D0%BE%D1%82%D0%B2%D0%B5%D1%82%D1%81%D1%82%D0%B2%D0%B5%D0%BD%D0%BD%D0%BE%D1%81%D1%82%D0%B8-%D0%BF%D1%80%D0%BE%D0%B8%D0%B7%D0%B2%D0%BE%D0%B4%D0%B8%D1%82%D0%B5%D0%BB%D1%8F)

## 1. Введение
Устройство [Bat & Link Box](Bat_n_link_box_Specification_ru.md) сочетает в себе функции автономного источника питания для станции пеленгования Zima2-B (Zima-B) и коммутационного хаба для сопряжения станции с ПК пользователя, а также для подключения источников данных о курсе и положении станции пеленгования. Содержит цепи защиты от переполюсовки и перенапряжения подключаемых приборов.

Прибор размещается в небольшом ударопрочном пластиковом кейсе. Имеет лицевую панель из высококачественной нержавеющей стали. Применяемые в приборе современные литий-железофосфатные аккумуляторы обеспечивают работу при отрицательных температурах и более тысячи циклов заряда-разряда. При необходимости возможна работа от сети переменного тока при помощи внешнего источника притания с одновременной зарядкой встроенного аккумулятора.

## 2. Внешний вид и ограны управления
Внешний вид лицевой панели усройства показан на **рисунке 1**. В центре панели располагаются разъемы для подключения устройств, поддерживающий связь по интерфейсу RS-422/485 и разъемы USB-B. Разъемы объединены в группы **1** и **8**<sup>[1](#footnote21)</sup>. Внешние устройства подключаются к разъемам **X1** и **X3**, через эти разъемы обеспечивается питание подключаемых внешних устройств. Разъемы USB-B **X2** и **X4** предназначены для подключения к USB порту ПК.

| Bat&Link Box panel |
| :---: |
| **Рисунок 1 - Внешний вид лицевой панели устройства** |
| _1 - Линия 1, 2 - Индикатор заряда, 3 - Индикатор питания, 4 - Выключатель питания, 5 - Предохранитель цепи встроенного АКБ<sup>[2](#footnote22)</sup>, 6 - Предохранитель цепи внешнего питания/зарядки<sup>[2](#footnote22)</sup>, 7 - Разъем подключения источника питания<sup>[2](#footnote22)</sup>, 8 - Линия 2_ |

Индикатор **2** горит когда встроенный аккумулятор заряжается и не горит, когда зарядка его не идет.
Двухцветный индикатор **3** используется для отображения состояния питания всей системы. **Таблица 1** содержит все возможные варианты световых сигналов.

Выключатель **4** предназначен для подачи питания на устройство и его отключения.

Предохранители **5** и **6** защищают цепи встроенной аккумуляторной батареи и внешнего питания (зарядки) соответственно. Применяются предохранители типоразмера **5.2х20** с номинальным током 5 А.

Разъем **7** служит для подключения сетевого адаптера (зарядного устройства), посредством которого заряжяется встроенная аккумуляторная батарея и, при необходимости, питается само устройство.

### Таблица 1 - Состояния индикатора **3**

| № | Состояние индикатора | Состояние индикатора |	Описание | Действие, которое необходимо предпринять |
| :---: | :---: | :--- | :--- | :--- |
| 1 | 🟢 | Зеленый горит постоянно | OK | Не требуется |
| 2 | ⚪🟢 | Зеленый мигает | Низкий заряд встроенного источника | Подключите зарядное устройство (адаптер) |
| 3 | 🔴 | Красный горит постоянно | Короткое замыкание на выходе | Выключите питание устройства, проверьте все кабели и разъемы |
| 4 | ⚪🔴 | Красный мигает | Ошибка в цепи внешнего питания | Выключите питание устройства, проверьте все кабели и зарядное устройство |

_____________
<a name="footnote21"><sup>1</sup></a> Группа **8** представлена только в расширенном исполнении устройства.  
<a name="footnote22"><sup>2</sup></a> В устройствах, произведенных до Июля 2020, предохранители и разъем для подключения внешнего питания могут располагаться на боковых поверхностях корпуса устройства.

## 3. Распиновки разъемов

### Таблица 2 - Распиновка разъема **7** для подключения сетевого зарядного устройства (адаптера)

| № | Номер пина | Функция |
| :---: | :--- | :--- |
| 1 | 1, 3 | +U CHARGE |
| 2 | 2 | GND CHARGE |
| 3 | 4 | ЗАРЕЗЕРВИРОВАНО |

### Таблица 3 - Распиновка разъема X1 (Группа 1)

| Номер пина | Функция |
| :---: | :--- |
| 1 | +U |
| 2 | GND |
| 3 | Tx+ |
| 4 | NC |
| 5 | Tx- |
| 6 | Rx+ |
| 7 | Rx- |

### Таблица 4 - Распиновка разъема X3 (Группа 8)

| Номер пина | Функция |
| :---: | :--- |
| 1 | +U |
| 2 | GND |
| 3 | Tx+ |
| 4 | NC |
| 5 | Tx- |
| 6 | Rx+ |
| 7 | Rx- |

## 4. Работа с устройством
Перед использованием, устройство должно быть установленно на устойчивое горизонтальное основание. При работе на судах и подобных подвижных объектах, рекомендуется закреплять устройство за ручку при помощи веревки.

Смыкание и размыкание разъемов выполнять при выключенном питании прибора, когда выключатель **4** находится в положении **OFF**.

После завершения подключения разъемов и перевода выключателя **4** в положение **ON**, состояние устройства отображается при помощи индикатора **3** согласно [Таблице 1](#%D1%82%D0%B0%D0%B1%D0%BB%D0%B8%D1%86%D0%B0-1---%D1%81%D0%BE%D1%81%D1%82%D0%BE%D1%8F%D0%BD%D0%B8%D1%8F-%D0%B8%D0%BD%D0%B4%D0%B8%D0%BA%D0%B0%D1%82%D0%BE%D1%80%D0%B0-3).

## 5. Хранение и обслуживание
- Хранение устройства допускается только в выключенном виде (выключатель **4** в положении **OFF**), отсоединенных разъемах и закрытой крышке прибора;
- В течение длительного (более месяца) хранения, рекомендуется периодически проверять состояние встроенного источника питания (аккумуляторной батареи), и, при необходимости, для предупреждения деградации аккумулятора, проводить подзарядку;
- Загрязнения с поверхностей устройсва могут быть удалены при закрытой крышке устройства при помощи бытовых мыльных растворов, с последующим их полным удалением;
- Загрязнения с лицевой панели устройства разрешается удалять только мягкой ветошью, избегая попадания грязи и влаги в открытые разъемы и предохранители;
- Не допускается использование сторонних зарядных устройств;

## 6. Обязательства и отказ от ответственности
### 6.1 Условия замены и бесплатного гарантийного обслуживания

Гарантия производителя распространяется только на заводские дефекты, которые проявляются при эксплуатации устройства в соответствии с настоящей инструкцией в течение гарантийного срока (2 года с момента покупки).

Изготовитель гарантирует бесплатный ремонт или замену неисправного оборудования из комплекта поставки, вышедшего из строя по причине производственного брака.

Основаниями для отказа в бесплатном гарантийном обслуживании, бесплатном ремонте и замене являются:
- любые **механические повреждения** оборудования из комплекта поставки, в т.ч. нарушение изоляции проводов и кабелей;
- любые **повреждения, вызванные воздействием влаги и грязи** из-за неправильного использования поставленного оборудования;
- любые **электрические повреждения**, вызванные **использованием некомплектных аксессуаров**; К некомплектным аксессуарам не относятся аксессуары, поставляемые производителем или его представителем взамен неисправных или утерянных;
- любые **следы самостоятельного ремонта и/или вскрытия** поставленного оборудования.

### 6.2 Ограничение ответственности производителя

_____________

_**ЛЮБЫЕ ЧАСТИ КОМПЛЕКТА ПОСТАВКИ ОТДЕЛЬНО И КАК ЧАСТЬ СИСТЕМЫ, ДАЛЕЕ ИМЕНУЕМЫЕ КАК «ПОСТАВЛЯЕМОЕ ОБОРУДОВАНИЕ»:**_  

_**- НЕ РАЗРАБОТАН КАК СРЕДСТВО СПАСЕНИЯ**_  
_**- НЕ ИСПЫТЫВАЛИСЬ В КАЧЕСТВЕ СПАСАТЕЛЬНОГО ОБОРУДОВАНИЯ**_
_**- НЕ ЯВЛЯЮТСЯ СПАСАТЕЛЬНЫМ ОБОРУДОВАНИЕМ**_
_**- ПРОИЗВОДИТЕЛЬ ЗАЯВЛЯЕТ, ЧТО ПОСТАВЛЯЕМОЕ ОБОРУДОВАНИЕ БЕЗОПАСНО ПРИ ИСПОЛЬЗОВАНИИ В СООТВЕТСТВИИ С НАСТОЯЩЕЙ ИНСТРУКЦИЕЙ И НЕ НЕСЕТ ОТВЕТСТВЕННОСТИ ЗА ЛЮБЫЕ ПОСЛЕДСТВИЯ ИСПОЛЬЗОВАНИЯ ПОСТАВЛЯЕМОГО ОБОРУДОВАНИЯ**_

_____________
[К содержанию](#%D1%81%D0%BE%D0%B4%D0%B5%D1%80%D0%B6%D0%B0%D0%BD%D0%B8%D0%B5)
