ucnl/ucnl.github.io/documentation/RU/RedPhone/RedPhone_OS_Users_manual_ru.md

[Главная](/README_RU) ❯ [Голосовая подводная связь (водолазная телефония)](/underwater_wireless_voice_systems_ru) ❯ **Инструкция по эксплуатации: RedPhone-OS**

<details>
<summary><b>ℹ Рекомендации для печати/сохранения в PDF</b></summary>

1. Нажмите **Ctrl+P** (macOS: **Cmd+P**)
2. В настройках принтера выберите **«Сохранить как PDF»** (Microsoft Print to PDF)
3. В поле **«Страницы»** укажите диапазон, исключая первую и последнюю страницу
4. Отключите **верхние и нижние колонтитулы** (заголовки/URL/page numbers)
5. В **Chrome/Edge**: в доп. настройках → «Поля» → **Нет** | в **Firefox**: «Поля и колонтитулы» → **Нет**
6. Нажмите **Печать** и укажите куда сохранить PDF

</details>

|  | redphone_os |
| :---: | ---: |
| [www.unavlab.com](https://www.unavlab.com/) <br/> [support@unavlab.com](mailto:support@unavlab.com) | **RedPhone-OS** <br/> Надводная станция голосовой гидроакустической связи <br/> **Руководство пользователя** |

# **RedPhone-OS** <br/> Надводная станция голосовой гидроакустической связи <br/> **Руководство пользователя**

## Содержание

- [1. Описание станции RedPhone-OS](#1-%D0%BE%D0%BF%D0%B8%D1%81%D0%B0%D0%BD%D0%B8%D0%B5-%D1%81%D1%82%D0%B0%D0%BD%D1%86%D0%B8%D0%B8-redphone-os)
  - [1.1. Назначение](#11-%D0%BD%D0%B0%D0%B7%D0%BD%D0%B0%D1%87%D0%B5%D0%BD%D0%B8%D0%B5)
  - [1.2. Органы управления и разъемы](#12-%D0%BE%D1%80%D0%B3%D0%B0%D0%BD%D1%8B-%D1%83%D0%BF%D1%80%D0%B0%D0%B2%D0%BB%D0%B5%D0%BD%D0%B8%D1%8F-%D0%B8-%D1%80%D0%B0%D0%B7%D1%8A%D0%B5%D0%BC%D1%8B)
  - [1.3. Технические характеристики](#13-%D1%82%D0%B5%D1%85%D0%BD%D0%B8%D1%87%D0%B5%D1%81%D0%BA%D0%B8%D0%B5-%D1%85%D0%B0%D1%80%D0%B0%D0%BA%D1%82%D0%B5%D1%80%D0%B8%D1%81%D1%82%D0%B8%D0%BA%D0%B8)
  - [1.4. Комплект поставки](#14-%D0%BA%D0%BE%D0%BC%D0%BF%D0%BB%D0%B5%D0%BA%D1%82-%D0%BF%D0%BE%D1%81%D1%82%D0%B0%D0%B2%D0%BA%D0%B8)
- [2. Работа с устройством](#2-%D1%80%D0%B0%D0%B1%D0%BE%D1%82%D0%B0-%D1%81-%D1%83%D1%81%D1%82%D1%80%D0%BE%D0%B9%D1%81%D1%82%D0%B2%D0%BE%D0%BC)
  - [2.1. Подготовка к работе](#21-%D0%BF%D0%BE%D0%B4%D0%B3%D0%BE%D1%82%D0%BE%D0%B2%D0%BA%D0%B0-%D0%BA-%D1%80%D0%B0%D0%B1%D0%BE%D1%82%D0%B5)  
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
от водолазов, оснащенных носимыми приборами водолазной телефонной связи, поддерживающих общие со станцией параметры сигнала.

Общий вид станции [RedPhone-OS](RedPhone_OS_Specification_ru.md), с подключенной гидроакустической антенной и микрофоном представлен на **рисунке 1**.

| RedPhone-OS |
| :---: |
| **Рисунок 1 - Общий вид станции [RedPhone-OS](RedPhone_OS_Specification_ru.md)** |

Для расположения и работы на объектах портовой инфраструктуры, судах и малых судах прибор выполнен в виде противоударного пластикового 
кейса, который при закрытой крышке обеспечивает класс защиты IP67. Встроенный источник питания состоит из литий-железофосфатных 
аккумуляторов, которые работают при отрицательных температурах и обеспечивают более 1000 циклов заряда-разряда. 

### 1.2. Органы управления и разъемы
Приборная панель устройства изготавливается из высококачественной нержавеющей стали, на которую, при помощи лазерной гравировки наносятся 
информационные надписи.
На **рисунке 2** показано расположение органов управления и разъемов.

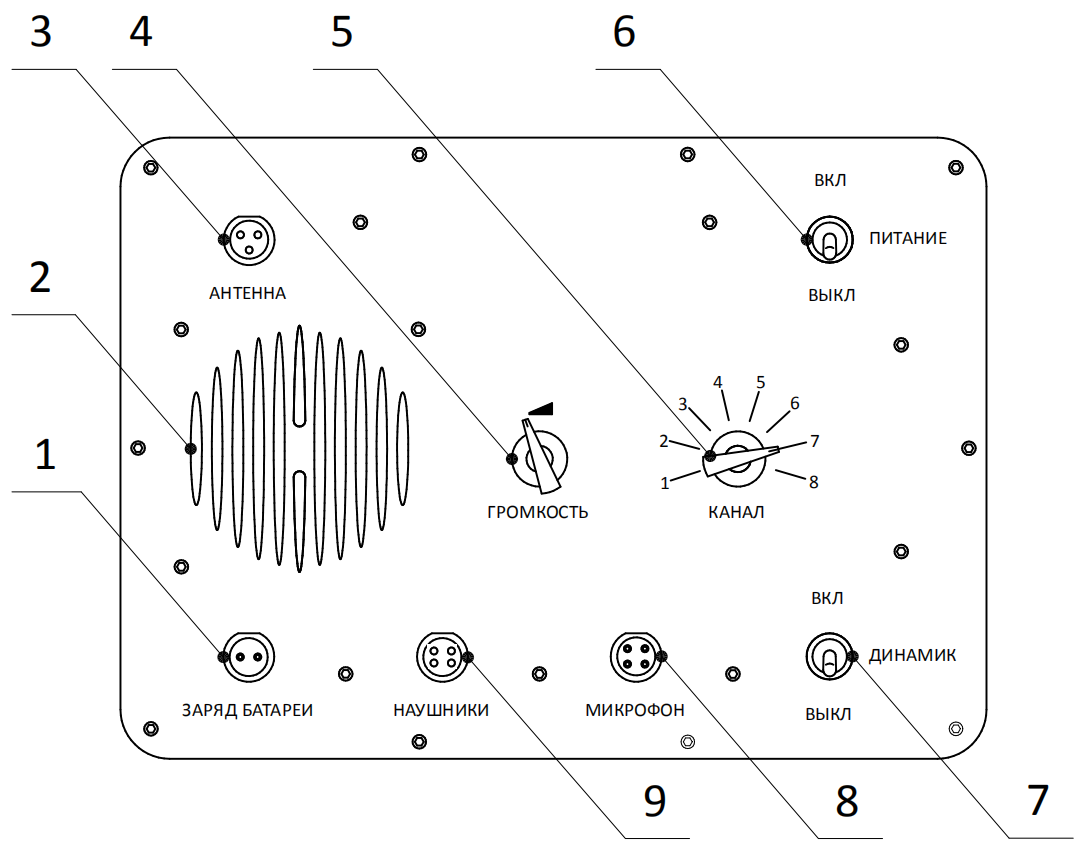
[picture p128: documentation/redphone_os_top_panel_scheme_ru.png]
RedPhone-OS top panel scheme
|  |
| :---: |
| **Рисунок 2 - Расположение органов управления и разъемов** |
| _1 - разъем подключения зарядного устройства, 2 - решетка громкоговорителя, 3 - разъем подключения гидроакустической антенны, 4 - регулятор громкости, 5 - переключатель каналов, 6 - тумблер включения прибора, 7 - тумблер включения громкоговорителя, 8 - разъем подключения микрофона и PTT, 9 - разъем подключения головных телефонов_ |

### 1.3. Технические характеристики
Станция использует однополосную амплитудную модуляцию (_англ. SSB, Single side band_) и поддерживает наиболее часто используемые в подобных системах диапазоны, что обеспечивает совместимость практически со всеми аналогами. Любая антенна, в т.ч. гидроакустическая, имеет характиристику, характеризующую ее чувствительность на разных частотах, поэтому в разных каналах прибор обеспечивает несколько отличающиеся чувствительности в режиме приема и передачи. В **таблице 1** приведено соответствие номеров каналов станции и полос частот, а так же степень соответствия канала характеристикам антенны и приемопередающего тракта. Если нет острой необходимости использования какого-то определенного канала, например, для обеспечения совместимости с устройствами других производителей, стоит отдавать предпочтение каналам, наиболее хорошо соответствующим характеристикам антенны.

### **Таблица 1** - Соответствие номера канала и параметров сигнала

| Номер канала | Несущая частота, Гц | Боковая полоса | Полоса частот, Гц | Соответствие характеристикам приемопередающего тракта |
| :---: | :--- | :--- | :--- | :--- |
| 1 | 32768 | Нижняя | 28468 .. 32468 | Хорошее |
| 2 | 32768 | Верхняя | 33068 .. 37068 | Удовлетворительное |
| 3 | 31250 | Нижняя | 26950 .. 30950 | Отличное |
| 4 | 31250 | Верхняя | 31550 .. 35550 | Хорошее |
| 5 | 28500 | Нижняя | 24200 .. 28200 | Отличное |
| 6 | 28500 | Верхняя | 28800 .. 32800 | Отличное | 
| 7 | 25000 | Нижняя | 20700 .. 24700 | Удовлетворительное |
| 8 | 25000 | Верхняя | 25300 .. 29300 | Отличное |

Общие технические характеристики устройства приведены в **таблице 2**:

### **Таблица 2** - Технические характеристики

| ПАРАМЕТР | ЗНАЧЕНИЕ |
| :--- | :--- |
| ГАБАРИТЫ (д х ш х в)| 259 x 202 x 115 мм |
| ВЕС (сухой) | 2 кг |
| МАКСИМАЛЬНАЯ ДАЛЬНОСТЬ АКУСТИЧЕСКОЙ СВЯЗИ<sup>[1](#footnote1)</sup> | 1000 м |
| МАКСИМАЛЬНОЕ АКУСТИЧЕСКОЕ ДАВЛЕНИЕ | 160 дБ re 1 мкПа @ 1 м |
| ДЛИНА КАБЕЛЯ ГИДРОАКУСТИЧЕСКОЙ АНТЕННЫ<sup>[2](#footnote2)</sup> | 7 м |
| ЧИСЛО ПОДДЕРЖИВАЕМЫХ КАНАЛОВ | 8 |
| ПОЛОСА ГОЛОСОВОГО СИГНАЛА<sup>[3](#footnote3)</sup> | 300 .. 4300 Гц |
| ЕМКОСТЬ ВСТРОЕННОГО АКБ | 60 Вт\*ч | 
| МАКСИМАЛЬНОЕ ВРЕМЯ АВТОНОМНОЙ РАБОТЫ В РЕЖИМЕ ПРИЕМА<sup>[4](#footnote4),[5](#footnote5)</sup> | до 30 часов |
| МАКСИМАЛЬНОЕ ВРЕМЯ АВТОНОМНОЙ РАБОТЫ В СМЕШАННОМ РЕЖИМЕ (20% передачи)<sup>[4](#footnote4),[5](#footnote5),[6](#footnote6)</sup> | до 24 часов |
| МАКСИМАЛЬНОЕ ВРЕМЯ АВТОНОМНОЙ РАБОТЫ В СМЕШАННОМ РЕЖИМЕ (50% передачи)<sup>[4](#footnote4),[5](#footnote5),[7](#footnote7)</sup> | до 12 часов |
| ДИАПАЗОН РАБОЧИХ ТЕМПЕРАТУР | -10 .. 50 °С |
| МИКРОФОН | Подключаемый, совмещенный с тангентой (PTT) |
| СОПРОТИВЛЕНИЕ ПОДКЛЮЧАЕМЫХ ГОЛОВНЫХ ТЕЛЕФОНОВ (не менее) | 8 Ом |
| ИСПОЛНЕНИЕ | IP67<sup>[8](#footnote8)</sup> |

________________
<a name="footnote1"><sup>1</sup></a> Параметр, определяющий максимальную дальность, на которой возможен прием сигнала, исходя из электроакустических параметров передатчика и приемника, пространственного убывания интенсивности звуковой энергии, затухания в среде и уровня гидроакустических помех.  
<a name="footnote2"><sup>2</sup></a> По договоренности возможна поставка с увеличенной длиной кабеля.  
<a name="footnote3"><sup>3</sup></a> Фактическая полоса воспроизводимых частот зависит от характеристик используемой гарнитуры.  
<a name="footnote4"><sup>4</sup></a> При воспроизведении на встроенный динамик, с уровнем громкости 40%.  
<a name="footnote5"><sup>5</sup></a> При полностью заряженном, новом АКБ. При температуре окружающей среды 20°С.  
<a name="footnote6"><sup>6</sup></a> В режиме 2 минуты передачи и 8 минут приема.  
<a name="footnote7"><sup>7</sup></a> В режиме 5 минут передачи и 5 минут приема.  
<a name="footnote8"><sup>8</sup></a> При закрытой крышке устройства.  

### 1.4. Комплект поставки

В данном пункте описывается стандартный комплект поставки (см. **таблица 3**). 
По отдельной договоренности с производителем возможна поставка гидроакустической антенны с удлиненным кабелем.  

### **Таблица 3** - Стандартный комплект поставки RedPhone-OS

| № | Наименование | Количество | Примечания |
| :--- | :--- | :--- | :--- |
| 1 | Станция RedPhone-OS | 1 шт. |  |
| 2 | Антенна гидроакустическая | 1 шт. | кабель 7 м |
| 3 | Микрофон с тангентой | 1 шт. | |
| 4 | Сетевое зарядное устройство | 1 шт. | |
| 5 | Карабин для крепления кабеля антенны | 1 шт. | |
| 6 | Гермомешок для транспортировки и хранения антенны и микрофона | 1 шт. | |
| 7 | Переходник с гнездом Jack 3.5 мм для подключения головных телефонов (наушников) | 1 шт. | |

## 2. Работа с устройством
### 2.1. Подготовка к работе
* Расположить станцию на устойчивом нескользком горизонтальном основании;
* Привязать станцию за ручку кейса при помощи страховочного шнура к леерному ограждению, перилам и т.п. для предотвращения опрокидывания станции в воду;
* Открыть крышку станции, нажав на предохранители закмков вниз (см. **риcунок 3**):

| RedPhone-OS case lock |
| :---: |
| **Рисунок 3 - Предохранитель замка** |

* Зафиксировать кабель гидроакустической антенны при помощи карабина, как показано на **рисунке 4**, для разгрузки разъема антенны от возможных рывков и натяжений. Допускается фиксация кабеля за грузонесущую проушину при помощи полимерного шнура, толщиной не менее 4 мм.

| RedPhone-OS cable fix |
| :---: |
| **Рисунок 4 - Фиксация кабеля гидракустической антенны** |

### 2.2. Проверочные мероприятия
#### 2.2.1. Внешняя визуальная проверка
Выполняется при открытой крышке станции. В ходе этой проверки контролируются, что:

* Целостность защитных колпачков на тумблерах **"Динамик"** и **"Питание"** передней панели станции не нарушена;
* Вода, высолы и прочие загрязнения отсутствуют внутри разъемов на передней панели станции и ответных разъемах (гидроакустическая антенна, микрофон, наушники (при использовании));
* Целостность изоляции кабелей гидроакустической антенны и микрофона не нарушена;

> **При несовпадении ожидаемых состояний от наблюдающихся эксплуатация станции запрещается!**.

#### 2.2.2. Проверка работоспособности устройства
Выполняется после успешной визуальной проверки, согласно [п. 2.2.1](#221-%D0%B2%D0%BD%D0%B5%D1%88%D0%BD%D1%8F%D1%8F-%D0%B2%D0%B8%D0%B7%D1%83%D0%B0%D0%BB%D1%8C%D0%BD%D0%B0%D1%8F-%D0%BF%D1%80%D0%BE%D0%B2%D0%B5%D1%80%D0%BA%D0%B0).

Дополнительные условия проверки:
* тумблер **"Питание"** установлен в положении **"Выкл"**;
* тумблер **"Динамик"** установлен в положении **"Вкл"**; 
* регулятор **"Громкость"**, установленном на 12 часов (50% шкалы);

В ходе проверки контролируется, что:

* При переводе тумблера **"Питание"** в положение **"Вкл"** станция издает короткий звуковой сигнал, свидетельстующий о наличии питания и работоспособности устройства;

[Пример звука](/documentation/redphone_pwon.wav)  

После проверки тумблер **"Питание"** перевести в положение **"Выкл"**

> **При несовпадении ожидаемых состояний от наблюдающихся эксплуатация станции запрещается!**.

#### 2.2.3. Проверка гидроакустической антенны и микрофона
Выполняется после успешных проверок согласно [п. 2.2.1](#221-%D0%B2%D0%BD%D0%B5%D1%88%D0%BD%D1%8F%D1%8F-%D0%B2%D0%B8%D0%B7%D1%83%D0%B0%D0%BB%D1%8C%D0%BD%D0%B0%D1%8F-%D0%BF%D1%80%D0%BE%D0%B2%D0%B5%D1%80%D0%BA%D0%B0) и [п. 2.2.2](#222-%D0%BF%D1%80%D0%BE%D0%B2%D0%B5%D1%80%D0%BA%D0%B0-%D1%80%D0%B0%D0%B1%D0%BE%D1%82%D0%BE%D1%81%D0%BF%D0%BE%D1%81%D0%BE%D0%B1%D0%BD%D0%BE%D1%81%D1%82%D0%B8-%D1%83%D1%81%D1%82%D1%80%D0%BE%D0%B9%D1%81%D1%82%D0%B2%D0%B0).

Дополнительные условия проверки:
* тумблер **"Питание"** установлен в положении **"Выкл"**;
* тумблер **"Динамик"** установлен в положении **"Вкл"**; 
* регулятор **"Громкость"**, установленном на **12 часов (50% шкалы)**;
* комплектная **гидроакустическая антенна** подключена к разъему **"Антенна"** на передней панели станции;
* комплектный **микрофон** подключен к разъему **"Микрофон"**;
* **тангента** (_PTT, Push-to-talk_) на микрофоне **не нажата**;

В ходе проверки контролируется, что:

* При переводе тумблера **"Питание"** в положение **"Вкл"** станция издает короткий звуковой сигнал, свидетельстующий о наличии питания и работоспособности устройства;
* Из громкоговорителя станции слышен постоянный шумовой фон, интенсивность которого может меняться;
* При прикосновении к гидроакустической антенне станция реагирует изменением шума (например, при легком постукивании по гидроакустической антенне из динамика станции должны быть слышны эти щелчки;
* При **нажатой тангенте** шум из динамиков полностью прекращается (идет передача), а при **отпускании** станция издает короткий звуковой сигнал, после чего может быть слышен шумофой фон;

После проверки тумблер **"Питание"** перевести в положение **"Выкл"**

[Пример звука](/documentation/redphone_pwon_rx_check.wav)  

> **При несовпадении ожидаемых состояний от наблюдающихся эксплуатация станции запрещается!**.

> Для проверки работоспособности головных телефонов (наушников) тумблер **"Динамик"** должен быть в состоянии **"Выкл"** и все звуковые сигналы, включая шумофой фон, должны контролироваться при помощи головных телефонов по указаноой выше методике.

#### Видеоинструкция по проверке станции RedPhone-OS перед использованием

<a href="https://youtu.be/j6Sgx4F4Q8E" 
target="_blank">RedPhone: check before usage</a>

#### 2.2.4. Непосредственно перед работой
Выполняется после успешных проверок согласно пп. [2.2.1](#221-%D0%B2%D0%BD%D0%B5%D1%88%D0%BD%D1%8F%D1%8F-%D0%B2%D0%B8%D0%B7%D1%83%D0%B0%D0%BB%D1%8C%D0%BD%D0%B0%D1%8F-%D0%BF%D1%80%D0%BE%D0%B2%D0%B5%D1%80%D0%BA%D0%B0) .. [2.2.3](#223-%D0%BF%D1%80%D0%BE%D0%B2%D0%B5%D1%80%D0%BA%D0%B0-%D0%B3%D0%B8%D0%B4%D1%80%D0%BE%D0%B0%D0%BA%D1%83%D1%81%D1%82%D0%B8%D1%87%D0%B5%D1%81%D0%BA%D0%BE%D0%B9-%D0%B0%D0%BD%D1%82%D0%B5%D0%BD%D0%BD%D1%8B-%D0%B8-%D0%BC%D0%B8%D0%BA%D1%80%D0%BE%D1%84%D0%BE%D0%BD%D0%B0).

Убедиться в том, что:
* Станция установлена на устойчивое нескользкое горизонтальное основание и привязана за ручку к леерному ограждению, перилам и т.п. для предотвращения опрокидывания станции в воду;
* Крышка устройства открыта;
* **Гидроакустическая антенна** подсоединена к разъему **"Антенна"**;
* **Микрофон** подключен к разъему **"Микрофон"**;
* Если станция используется без головных телефонов (наушников):
  * Тумблер **"Динамик"** находится в положении **"Вкл"**;
* Если станция используется с головными телефонами (наушниками);
  * Тумблер **"Динамик"** находится в положении **"Выкл"**;
  * Головные телефоны (наушники) подключены к разъему **"Наушники"**;
* Крышки всех незадействованных разъемов завинчены с легким усилием;
* Гайки на всех подключенных кабельных разъемах завинчены с легким усилием;
* Тумблер **"Питание"** установлен в положени **"Вкл"**;
* Переключатель **"Канал"** установлен в положение, соответствующие каналу связи, установленному на водолазных приборах;
* Гидроакустическая антенна опущена в воду на такую глубину, чтобы находится как минимум в 2 метрах от нижней точки судна и как минимум в 1.5 метрах от дна водоема;
* Имеется прямая видимость между гидроакустической антенной станции и гидроакустическими антеннами водолазных станций (не затенена элементами подводного ландшафта, частями различных конструкций, судами и т.п.).

### 2.3. Работа
Перед работой должны быть выполнены все подготовки и проверки, предусмотренные [п. 2.2](#22-%D0%BF%D1%80%D0%BE%D0%B2%D0%B5%D1%80%D0%BE%D1%87%D0%BD%D1%8B%D0%B5-%D0%BC%D0%B5%D1%80%D0%BE%D0%BF%D1%80%D0%B8%D1%8F%D1%82%D0%B8%D1%8F).

Водолазная гидроакустическая голосовая связь работает по полудуплексной схеме: передача и прием чередуются, если устройство находится в режиме передачи, оно не может принимать входящие сообщения.

#### 2.3.1. Звуковые сигналы
Возможные звуковые оповещения сведены в **таблицу 4**.

### **Таблица 4** - Звуковые оповещения

| Описание оповещения | О чем сигнализирует | Пример |
| :--- | :--- | :--- |
| Короткий повышающийся а потом понижающийся тон | Включение станции и переход в режим приема  | [Пример звука](/documentation/redphone_pwon.wav) |
| Короткий повышающийся тон | Переход в режим приема после завершения передачи (отпускании тангенты **PTT**) | [Пример звука](/documentation/redphone_switch_to_rx.wav) |
| Короткий понижающийся тон (~ каждые 30 секунд) | Низкий заряд встроенного источника питания | |

#### 2.3.2. Прием голосовых сообщений
Для приема голосовых сообщений от водолазов тангента **PTT** на микрофоне должна быть отпущена. При этом входящие сообщения будут воспроизводится громкоговорителем устройства (или наушниками, если последние подключены а тумблер **"Динамик"** находится в состоянии **"Выкл"**). 

Громкость воспроизводимых входящих голосовых сообщений зависит от расстояния между антенной станцией и водолазом, от гидрологических условий. Может снижаться при попадании водолаза в зону акустической тени (когда на пути следования сигнала находятся элементы подводного ландшафта, части конструкций, суда, водоросли и т.п.). 

Пользователь должен самостоятельно устанавливать комфортный уровень громкости при помощи регулятора **"Громкость"** в зависимости от текущих условий связи.

#### 2.3.3 Передача голосовых сообщений
Для передачи голосовых сообщений выполняется следующая последовательность действий:
* Поднести микрофон решеткой ко рту на расстояние **0.5 - 2** см;
* Нажать тангенту **PTT**;
* Выждержать короткую паузу (~**0.5** секунды) для того, чтобы станция перешла в режим передачи;
* Произнести голосовое сообщений с выраженной артикуляцией; Рекомендуется завершать голосовое сообщение словом **"Прием!"**, сигнализирующем адресату о том, что сообщение окончено;
* Выдержать короткую паузу (~**0.5** секунды);
* Отпустить тангенту **PTT**;
* Станция издает короткий звуковой сигнал, говорящий о том, что устройство перешло в режим приема.

### 2.4. Завершение работы
По завершении работы действия должны выполнятся по следующей последовательности:
* Тумблер **"Питание"** перевести в положение **"Выкл"**;
* Выбрать кабель гидроакустической антенны;
* Дальнейшие действия выполняются только при отсутствии риска попадания воды в открытые разъемы:
  * Отключаются все подключенные разъемы;
  * Завинчиваются защитные крышки всех разъемов;
  * Карабин грузонесущей проушины отсоединяется от крышки устройства;
  * Крышка устройства закрывается.

## 3. Хранение и обслуживание
### 3.1. Условия хранения и обслужвания
К станции и комплектному оборудованию: антенне, микрофону и зарядному устройству не предъявляются особых условий хранения, кроме следующих:
- Хранение при температуре от -20° до 60°С;
- Все разъемы отсоединены, защитные крышки закручены с легким усилием, станция выключена (тумблер **"Питание"** в положении **"Выкл"** крышка прибора закрыта;
- При длительном хранении (более месяца) рекомендуется производить подзарядку встроенного источника питания станции;
- При попадании влаги на диффузор громкоговорителя ее стоит удалить перевернув станцию решеткой громкоговорителя вниз, остатки влаги должны удаляся естественным испарением;
- Допускается краткая промывка слабой струей воды при закрытых крышках разъемов;
- Не допускается механическое воздействие на диффузор громкоговорителя;
- Для удаления загрязнений с корпуса устройства допускается применение слабого раствора бытовых моющих средств при закрытых крышках разъемов и крышке устройства;
- Не допускается попадание влаги в разъемы гидроакустической антенны, микрофона, наушников, зарядного устройства и переходника для подключения головных телефонов;
- Не допускается перегибание кабеля гидроакустической антенны, радиусом менее 5 см;
- Не допускается воздействие влаги на микрофон, попавшая влага должна удалятся сухой впитывающей тканью, после чего устройство должно высохнуть в течение как минимум 8 часов в сухом помещении при температуре от 15°С до 50°С и отнсительной влажности воздуха не более 50%;
- Хранение и транспортировка антенны и микрофона производится в комплектном гермомешке;
- Перед помещением антенны и микрофона в комплектный транспортировочный мешок с них **полностью должна быть удалена влага**.

> **ЗАПРЕЩАЕТСЯ:**
>
> **- ВСКРЫТИЕ ОБОРУДОВАНИЯ ИЗ КОМПЛЕКТА ПОСТАВКИ СОГЛАСНО [п. 1.4.](#14-%D0%BA%D0%BE%D0%BC%D0%BF%D0%BB%D0%B5%D0%BA%D1%82-%D0%BF%D0%BE%D1%81%D1%82%D0%B0%D0%B2%D0%BA%D0%B8)**  
> **- ДОПУСК К ПОЛЬЗОВАНИЮ ОБОРУДОВАНИЕМ ИЗ КОМПЛЕКТА ПОСТАВКИ СОГЛАСНО [п. 1.4.](#14-%D0%BA%D0%BE%D0%BC%D0%BF%D0%BB%D0%B5%D0%BA%D1%82-%D0%BF%D0%BE%D1%81%D1%82%D0%B0%D0%B2%D0%BA%D0%B8) ЛИЦ, НЕ ОЗНАКОМИВШИХСЯ С НАСТОЯЩЕЙ ИНСТРУКЦИЕЙ**  
> **- ДОПУСК К ПОЛЬЗОВАНИЮ ОБОРУДОВАНИЕМ ИЗ КОМПЛЕКТА ПОСТАВКИ СОГЛАСНО [п. 1.4.](#14-%D0%BA%D0%BE%D0%BC%D0%BF%D0%BB%D0%B5%D0%BA%D1%82-%D0%BF%D0%BE%D1%81%D1%82%D0%B0%D0%B2%D0%BA%D0%B8) ЛИЦ, НЕ ДОСТИГШИХ СОВЕРШЕННОЛЕТИЯ**  
> **- ВКЛЮЧЕНИЕ РЕЖИМА ПЕРЕДАЧИ (НАЖАТИЕ ТАНГЕНТЫ НА МИКРОФОНЕ) ПРИ НЕПОДКЛЮЧЕННОЙ ГИДРОАКУСТЧИЕСКОЙ АНТЕННЕ**

### 3.2. Заряд встроенного источника питания
Заряд встроенного источника питания станции допускается только комплектным зарядным устройством, при выключенной станции (тумблер **"Питание"** в положении **"Выкл"**) и отсоединенных всех остальных разъемах.
Перед применением зарядного устройства необходимо ознакомиться с инструкцией по эксплуатации зарядного устройства.

## 4. Обязательства и отказ от ответственности
### 4.1 Условия замены и бесплатного гарантийного обслуживания
Гарантия производителя распространяется только на заводские дефекты, выявивщиеся при эксплуатации устройства в соответствие с настоящим руководством в течении гарантийного срока (2 года с момента покупки).  

Производитель гарантирует бесплатный ремонт или замену неисправного оборудования из комплекта поставки, вышедшего из строя по причине заводского дефекта.  

К поводам для отказа от бесплатного гарантийного обслуживания, бесплатного ремонта и замены относятся:
- любые **механические повреждения** оборудования из комплекта поставки [п. 1.4.](#14-%D0%BA%D0%BE%D0%BC%D0%BF%D0%BB%D0%B5%D0%BA%D1%82-%D0%BF%D0%BE%D1%81%D1%82%D0%B0%D0%B2%D0%BA%D0%B8), в т.ч. нарушение изоляции проводов и кабелей;
- любые **повреждения, вызванные воздействием влаги и загрязнейний**, вследствие неправильной эксплуатации оборудования из комплекта поставки [п. 1.4.](#14-%D0%BA%D0%BE%D0%BC%D0%BF%D0%BB%D0%B5%D0%BA%D1%82-%D0%BF%D0%BE%D1%81%D1%82%D0%B0%D0%B2%D0%BA%D0%B8): попадания влаги в разъемы, внутрь микрофона, переходника для подключения головных телефонов и т.п.
- любые **электрические повреждения**, вызванные **использованием некомплектных аксессуаров** (гидроакустической антенны, микрофона, переходника для подключения головных телефонов, головных телефонов с сопротивлением менее того, которое указано в спецификации устройства, зарядного устройства); к некомплектным не отностятся аксессуары, поставленные производителем или его представителем в замен неисправных или утраченых;
- любые **следы самостоятельного ремонта и/или вскрытия** оборудования из комплекта поставки [п. 1.4.](#14-%D0%BA%D0%BE%D0%BC%D0%BF%D0%BB%D0%B5%D0%BA%D1%82-%D0%BF%D0%BE%D1%81%D1%82%D0%B0%D0%B2%D0%BA%D0%B8).

### 4.2 Ограничение ответственности производителя

_____________

_**ЛЮБАЯ ИЗ ЧАСТЕЙ КОМПЛЕКТА ПОСТАВКИ СОГЛАСНО [п. 1.4.](#14-%D0%BA%D0%BE%D0%BC%D0%BF%D0%BB%D0%B5%D0%BA%D1%82-%D0%BF%D0%BE%D1%81%D1%82%D0%B0%D0%B2%D0%BA%D0%B8) В ОТДЕЛЬНОСТИ И В СОСТАВЕ СИСТЕМЫ, ИМЕНУЕМЫЕ ДАЛЕЕ "ПОСТАВЛЯЕМОЕ ОБОРУДОВАНИЕ":**_

_**- НЕ РАЗРАБАТЫВАЛОСЬ КАК СРЕДСТВО СПАСЕНИЯ**_  
_**- НЕ ТЕСТИРОВАЛОСЬ, КАК СРЕДСТВО СПАСЕНИЯ**_  
_**- НЕ ЯВЛЯЕТСЯ СРЕДСТВОМ СПАСЕНИЯ**_  
_**- ПРОИЗВОДИТЕЛЬ ЗАЯВЛЯЕТ, ЧТО ПОСТАВЛЯЕМОЕ ОБОРУДОВАНИЕ БЕЗОПАСНО ПРИ ЭКСПЛУАТАЦИИ СОГЛАСНО НАСТОЯЩЕЙ ИНСТРУКЦИИ И НЕ ОТВЕЧАЕТ ЗА ЛЮБЫЕ ПОСЛЕДСТВИЯ ИСПОЛЬЗОВАНИЯ ПОСТАВЛЯЕМОГО ОБОРУДОВАНИЯ**_

______________

_____________
[Вернуться к содержанию](#%D1%81%D0%BE%D0%B4%D0%B5%D1%80%D0%B6%D0%B0%D0%BD%D0%B8%D0%B5)
