ucnl/ucnl.github.io/documentation/RU/RWLT/uNav_application_Users_manual_ru.md

[Главная](/README_RU) ❯ [Гидроакустические навигационные и трекинговые системы](/navigation_and_tracking_systems_ru) ❯ **uNav application: Руководство пользователя**

> ℹ Этот документ можно распечатать прямо из браузера. 
> Для лучшего результата:
> - выберите диапазон страниц для печати, исключая первую и последнюю
> - в дополнительных настройках отключите нижние и верхние колонтитулы

|  |  |
| :---: | ---: |
| [www.unavlab.com](https://www.unavlab.com/) <br/> [support@unavlab.com](mailto:support@unavlab.com) | **💧 uNav application** - Приложение для работы с радиодонглом uNav <br/> Руководство пользователя |

# 💧 uNav application <br/> Руководство пользователя

## Содержание

- [1. Введение](#1-%D0%B2%D0%B2%D0%B5%D0%B4%D0%B5%D0%BD%D0%B8%D0%B5)
- [2. Интерфейс и функции приложения](#2-%D0%B8%D0%BD%D1%82%D0%B5%D1%80%D1%84%D0%B5%D0%B9%D1%81-%D0%B8-%D1%84%D1%83%D0%BD%D0%BA%D1%86%D0%B8%D0%B8-%D0%BF%D1%80%D0%B8%D0%BB%D0%BE%D0%B6%D0%B5%D0%BD%D0%B8%D1%8F)
  - [2.1. Настройки приложения](#21-%D0%BD%D0%B0%D1%81%D1%82%D1%80%D0%BE%D0%B9%D0%BA%D0%B8-%D0%BF%D1%80%D0%B8%D0%BB%D0%BE%D0%B6%D0%B5%D0%BD%D0%B8%D1%8F)
    - [2.1.1. Вкладка 🧪 PHYSICS](#211-%D0%B2%D0%BA%D0%BB%D0%B0%D0%B4%D0%BA%D0%B0--physics)
    - [2.1.2. Вкладка ❗ CONNECTION](#212-%D0%B2%D0%BA%D0%BB%D0%B0%D0%B4%D0%BA%D0%B0--connection)
    - [2.1.3. Вкладка 🛸 EXTRA](#213-%D0%B2%D0%BA%D0%BB%D0%B0%D0%B4%D0%BA%D0%B0--extra)
  - [2.2. Главное окно приложения](#22-%D0%B3%D0%BB%D0%B0%D0%B2%D0%BD%D0%BE%D0%B5-%D0%BE%D0%BA%D0%BD%D0%BE-%D0%BF%D1%80%D0%B8%D0%BB%D0%BE%D0%B6%D0%B5%D0%BD%D0%B8%D1%8F)
    - [2.2.1. Главная панель инструментов](#221-%D0%B3%D0%BB%D0%B0%D0%B2%D0%BD%D0%B0%D1%8F-%D0%BF%D0%B0%D0%BD%D0%B5%D0%BB%D1%8C-%D0%B8%D0%BD%D1%81%D1%82%D1%80%D1%83%D0%BC%D0%B5%D0%BD%D1%82%D0%BE%D0%B2)
    - [2.2.2. Панель инструментов карты](#222-%D0%BF%D0%B0%D0%BD%D0%B5%D0%BB%D1%8C-%D0%B8%D0%BD%D1%81%D1%82%D1%80%D1%83%D0%BC%D0%B5%D0%BD%D1%82%D0%BE%D0%B2-%D0%BA%D0%B0%D1%80%D1%82%D1%8B)
    - [2.2.3. Панель карты](#223-%D0%BF%D0%B0%D0%BD%D0%B5%D0%BB%D1%8C-%D0%BA%D0%B0%D1%80%D1%82%D1%8B)
    - [2.2.4. Панель дополнительной информации](#224-%D0%BF%D0%B0%D0%BD%D0%B5%D0%BB%D1%8C-%D0%B4%D0%BE%D0%BF%D0%BE%D0%BB%D0%BD%D0%B8%D1%82%D0%B5%D0%BB%D1%8C%D0%BD%D0%BE%D0%B9-%D0%B8%D0%BD%D1%84%D0%BE%D1%80%D0%BC%D0%B0%D1%86%D0%B8%D0%B8)
    - [2.2.5. Панель журнала](#225-%D0%BF%D0%B0%D0%BD%D0%B5%D0%BB%D1%8C-%D0%B6%D1%83%D1%80%D0%BD%D0%B0%D0%BB%D0%B0)
    - [2.2.6. Дополнительная панель №1](#226-%D0%B4%D0%BE%D0%BF%D0%BE%D0%BB%D0%BD%D0%B8%D1%82%D0%B5%D0%BB%D1%8C%D0%BD%D0%B0%D1%8F-%D0%BF%D0%B0%D0%BD%D0%B5%D0%BB%D1%8C-1)
    - [2.2.7. Дополнительная панель №2](#227-%D0%B4%D0%BE%D0%BF%D0%BE%D0%BB%D0%BD%D0%B8%D1%82%D0%B5%D0%BB%D1%8C%D0%BD%D0%B0%D1%8F-%D0%BF%D0%B0%D0%BD%D0%B5%D0%BB%D1%8C-2)
    - [2.2.8. Строка статуса](#228-%D1%81%D1%82%D1%80%D0%BE%D0%BA%D0%B0-%D1%81%D1%82%D0%B0%D1%82%D1%83%D1%81%D0%B0)
    - [2.2.9. Поле легенды](#229-%D0%BF%D0%BE%D0%BB%D0%B5-%D0%BB%D0%B5%D0%B3%D0%B5%D0%BD%D0%B4%D1%8B)
    - [2.2.10. Линейка масштаба](#2210-%D0%BB%D0%B8%D0%BD%D0%B5%D0%B9%D0%BA%D0%B0-%D0%BC%D0%B0%D1%81%D1%88%D1%82%D0%B0%D0%B1%D0%B0)

## 1. Введение

Навигационный решатель [uNav RF Dongle](documentation/RU/RWLT/RWLT_RF_Dongle_Specification_ru.md) передает вычисленное положение пингера, в том числе, эмулируя стандартные (RMC, GGA) сообщения протокола NMEA0183, применяемого в GNSS-приемниках. Поэтому после настройки, если таковая необходима, устройство может подключаться к любой, поддерживающей подключение по последовательному порту стандартного GNSS-приемника, геоинформационной системе: GoogleEarth, SAS.Planet и т.п.

Для настройки устройства по [специализированному протоколу](documentation/RU/RWLT/uNav_protocol_specification_ru.md) или для получения расширенного набора данных, куда входят, например, положения буев, положение пингера относительно опорной точки, данные от встроенного GNSS решателя и т.д. можно воспользоваться приложением [💧 uNav](https://github.com/ucnl/uNav/releases/download/1.0/uNav.zip).

Приложение так же позволяет передавать данные от решателя в неизменном виде по последовательному соединению или по протоколу UDP.

Для работы скачайте необходимое ПО. Установка не требуется - достаточно просто распаковать содержимое архива в удобное для вас место.

Приложение работает под управлением .NET Framework и совместимо с OS Windows версий 10 и выше.

## 2. Интерфейс и функции приложения

### 2.1. Настройки приложения

Редактор настроек приложения доступен по кнопке **SETTINGS** в главном меню приложения. Настройки сгруппированы по вкладкам:  

- **🧪 PHYSICS** - основные настройки, относящиеся к физическим параметрам среды и настройкам алгоритмов в навигационном решателе [uNav](documentation/RU/RWLT/RWLT_RF_Dongle_Specification_ru.md)
- **❗ CONNECTION** - настройки параметров соединения 
- **🛸 EXTRA** - дополнительные настройки, относящиеся к отображению треков, подложки карты и специфических параметров системы

Помимо вкладок, редактор настроек имеет три кнопки:

- **SET DEFAULTS** - сброс к настройкам по умолчанию
- **OK** - Сохранить изменения и закрыть редактор настроек
- **CANCEL** - Закрыть редактор настроек без сохранения изменений
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
