ucnl/ucnl.github.io/documentation/RU/A3S/A3S_Users_Manual_ru.md

[Главная](/README_RU) ❯ [Наши проекты для образования](/educational_projects_ru) ❯ **ACubes: Руководство пользователя**

|  |  |
| :---: | ---: |
| [www.unavlab.com](https://www.unavlab.com/) <br/> [support@unavlab.com](mailto:support@unavlab.com) | **A<sup>3</sup>S** **ACubes** <br/> Руководство пользователя |

# Семейство устройств **A<sup>3</sup>S** <br/> Руководство пользователя

## Содержание

* [0. Для кого и зачем эта коробка с кубиками?](#0-для-кого-и-зачем-эта-коробка-с-кубиками)
* [1. A³T и A³R](#1-a3t-и-a3r)
  * [Передатчик A³T](#передатчик-a3t)
  * [Приёмник A³R](#приёмник-a3r)
  * [Особенности работы](#особенности-работы)
  * [Возможности масштабирования](#возможности-масштабирования)
  * [1.1. О гидроакустических антеннах](#11-о-гидроакустических-антеннах)
    * [Особенности выбора антенн](#особенности-выбора-антенн)
    * [Специализированные приёмные антенны](#специализированные-приёмные-антенны)
    * [Приёмо-передающие антенны](#приёмо-передающие-антенны)
    * [Правила эксплуатации](#правила-эксплуатации)
  * [1.2. Проект 1 - Передаем и принимаем](#12-проект-1---передаем-и-принимаем)
    * [1.2.1. Требуемый набор оборудования](#121-требуемый-набор-оборудования)
    * [Подключение антенн](#подключение-антенн)
    * [1.2.2. Настройка передатчика](#122-настройка-передатчика)
    * [1.2.3. Настройка приёмника](#123-настройка-приёмника)
    * [1.2.4. Тестирование системы](#124-тестирование-системы)
  * [1.3. Кратко о многолучевости и защитных интервалах](#13-кратко-о-многолучевости-и-защитных-интервалах)
    * [1.3.1. Суть явления многолучевости](#131-суть-явления-многолучевости)
    * [1.3.2. Проблемы, вызванные многолучевостью](#132-проблемы-вызванные-многолучевостью)
    * [1.3.3. Методы борьбы (на примере ACubes)](#133-методы-борьбы-на-примере-acubes)
  * [1.4. Проект 2 - Собираем приемопередатчик и измеряем наклонную дальность](#14-проект-2---собираем-приемопередатчик-и-измеряем-наклонную-дальность)
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
