ucnl/ucnl.github.io/documentation/RedNODE_wiring_diagram_ru.png

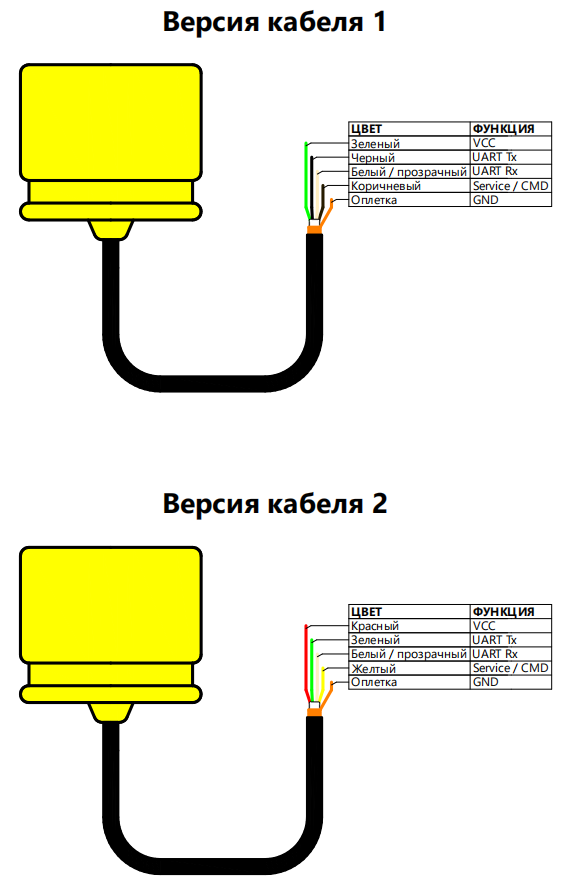
documentation/RedNODE_wiring_diagram_ru.png
