ucnl/ucnl.github.io/documentation/redphone_dx_qr_manual_ru.png

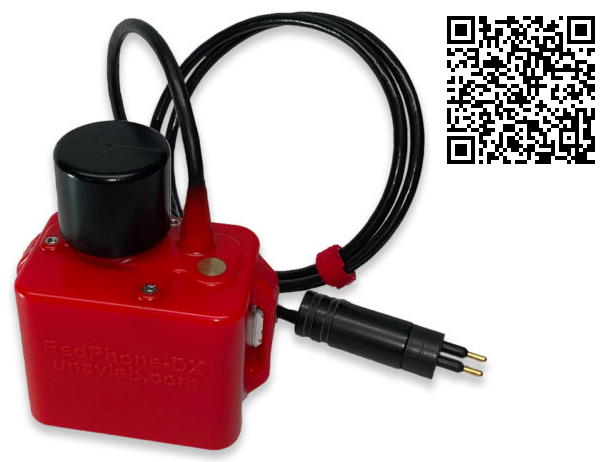
documentation/redphone_dx_qr_manual_ru.png
