ucnl/ucnl.github.io/documentation/rwlt_qr_manual_ru.png

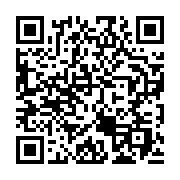
documentation/rwlt_qr_manual_ru.png
