ucnl/ucnl.github.io/_posts/2022-10-25-test.md

---
layout: post
title: Тест
---

> "Тестировать, тестировать и еще раз тестировать" (С) В. И. Ленин
