ucnl/ucnl.github.io/(commit log)

2026-06-10 Printing and saving notes
2026-06-25 ЛШТШФУМ АЩЬФ - день рождения Фомы Киняева
2026-10-09 docs-sync: add brief subcommand to docsync.py
    Prints the per-document facts an executor brief needs: status, printing
    block, breadcrumb, structure counts, every local and absolute self-link with
    the state of its EN target (exists, created in the batch, deferred), language
    variants of images and the sync marker line.
    Claude-Session: https://claude.ai/code/session_01MRgQCdZ4f6ZzVAHoz9FS9i
2026-10-09 docs-sync: update documentation/EN/Zima/Zima2_Users_manual_en.md
    Full re-translation of the current RU manual (heading structure, images and
    sections had diverged). Links to AzimuthConsole_manual, AzimuthSuite_manual,
    Zima2B35 and Zima2R35 specifications stay RU until their EN versions exist.
    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
2026-10-09 docs-sync: apply independent review fixes to documentation/EN/Zima/Zima2_Users_manual_en.md
    Restores the manufacturer as the subject of the liability disclaimer and
    replaces calques found by the independent review (slack, thruster wash,
    unauthorized repair, HOVs, ACAL table wording, SI units).
    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
2026-10-09 docs-sync: apply independent review fixes to documentation/EN/Zima/Zima2_Protocol_Specification_en.md
    Section 3.3 renamed to Addressed request identifiers (RU: адресных запросов)
    and translated-sounding sentence openings and field descriptions reworded.
    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
2026-10-09 docs-sync: make docsync.py print usage when run without arguments
    Running it without a subcommand used to regenerate REPORT.md; the report is
    now produced only by an explicit `report` subcommand.
    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
2026-10-09 docs-sync: apply independent review fixes to documentation/EN/Zima/Zima_Users_manual_en.md
    Antenna orientation (not directivity) in the installation text, imperative
    mood in procedures, product names before the noun, and wording that read as
    translated.
    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
2026-10-09 docs-sync: check product name case in docsync.py
    `check` now reports product names written in capitals in EN text (uWAVE,
    RedWAVE, RedBASE, RedNODE, RedNAV, RedLINE, ZIMA), outside code, link
    targets, URLs, identifiers and ALL CAPS labels.
    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
2026-10-09 docs-sync: record the mixed-case product name rule in glossary.md
    Maintainer decision: uWave, RedWave, RedBase, RedNode, RedNav, RedLine and
    Zima are always written in mixed case in EN text.
    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
2026-10-09 docs-sync: write Zima-B in mixed case in documentation/EN/Zima/Zima_DataBrief_en.md
    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
2026-10-09 docs-sync: apply independent review fixes to documentation/EN/Zima/AzimuthSuite_manual_en.md
    RAZ enables homing of the carrier (no added destination), menu items and
    buttons phrased as "The X item/button ...", imperative procedure step.
    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
2026-10-09 docs-sync: add executor_rules.md
    The rules every executor brief points to (approved amendments to CLAUDE.md
    section 3, link handling, product name case, self-check, report format), so
    that a new session can resume the sync from the repository alone.
    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
2026-10-09 docs-sync: accept the RU target of the language-switch row in docsync.py check
    CLAUDE.md section 3.4 keeps the [EN] | [RU] row with both targets, so its RU
    link is not reported as an undeclared RU link.
    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
2026-10-09 docs-sync: update documentation/EN/A3S/A3R_Datasheet_en.md
    Write the pin reference as in the A3T datasheet.
    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
2026-10-09 docs-sync: update documentation/EN/Transducers/RT_1_524525_1_FF_Specification_en.md
    Use the glossary label CABLE DIAMETER, as in the other transducer specifications.
    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
2026-10-09 docs-sync: update documentation/EN/Transducers/RT_1_332820_1_Specification_en.md
    Keep the RU qualifier of the beam angle (АЧХ 3 дБ) as in the other transducer specifications of this batch.
    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
2026-10-09 docs-sync: update documentation/EN/Transducers/RT_1_524525_1_FF_Specification_en.md
    Use the same wording for the cable insulation feature as the other transducer specifications.
    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
